HASP-UMN/CubeSat/Documents/CubeSat_Sub-Systems/Communications/Images/Patch_20140520.png

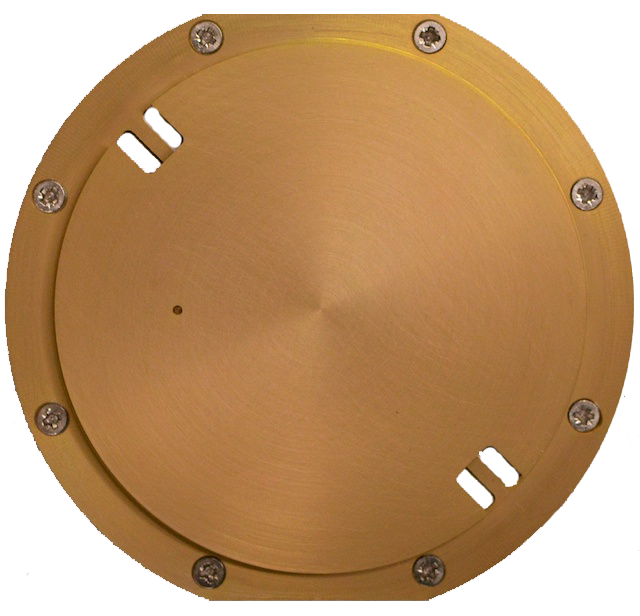
Documents/CubeSat_Sub-Systems/Communications/Images/Patch_20140520.png
