HASP-UMN/CubeSat/Presentations/Images/leadership-500x500.jpg

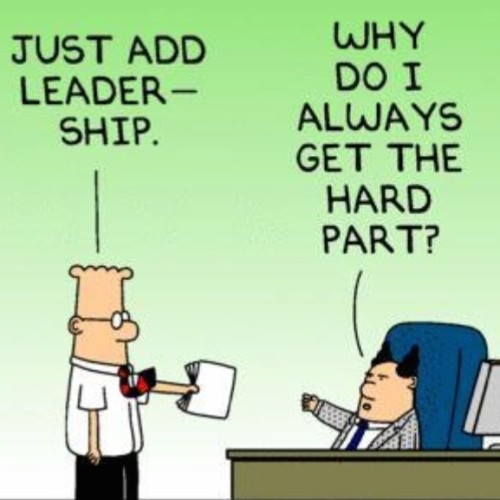
Presentations/Images/leadership-500x500.jpg
