HASP-UMN/CubeSat/README.md

# CubeSat
This is the working repository for the 2015-16 AEM4331 CubeSat design team

The contents are the research files and working documents for the Senior design team
