HASP-UMN/CubeSat/Presentations/CDR_Presentation.pptx

## CubeSat

Critical Design Review

## Agenda

    1. Introduction
    2. Motivation
    3. Approach
    4. Budget
    5. Design
    6. Standards
    7. FMEA
    8. Conclusion

- Charlie

## Introduction

- Charlie

Team Lead/Structure
Charles Denis

ADNCS
Jacob Gustafson
Brian Hanson
Nicholas Sloan

Communications
Ben Setterholm
Tim Kukowski

Power Management
Ethan Arendt
Justin Seifert
Nicholas Janak

## Motivation

- Charlie

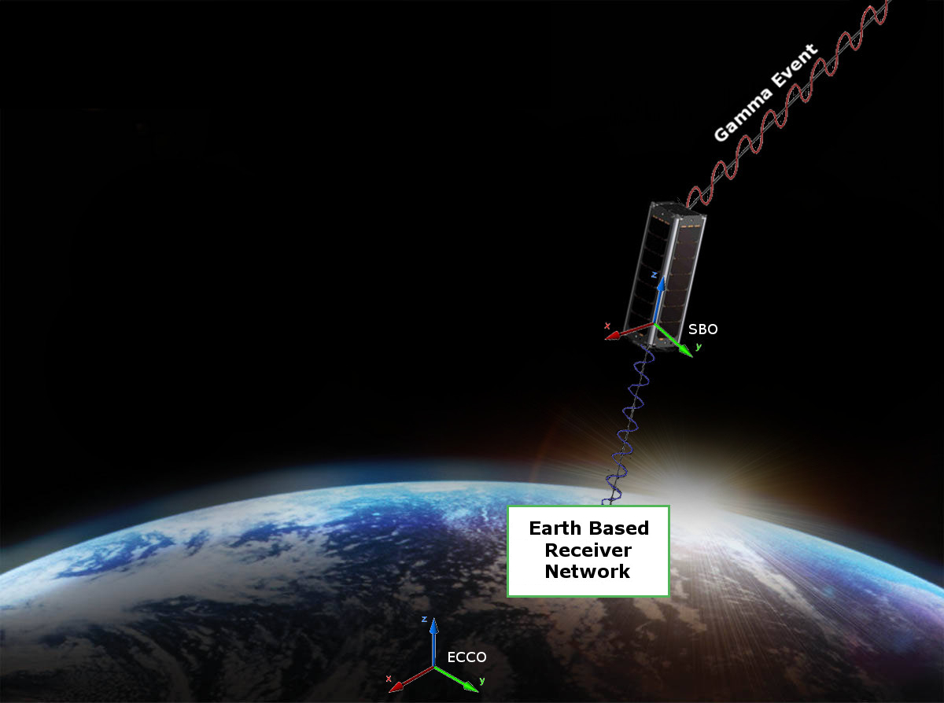
[picture p3: figure]

## Motivation

- Payload
  - Gamma Ray Intensity Detector (GRID)
- What GRID does?
  - Detect Gamma Ray Events to conceptually prove deep space navigation concepts

- Charlie

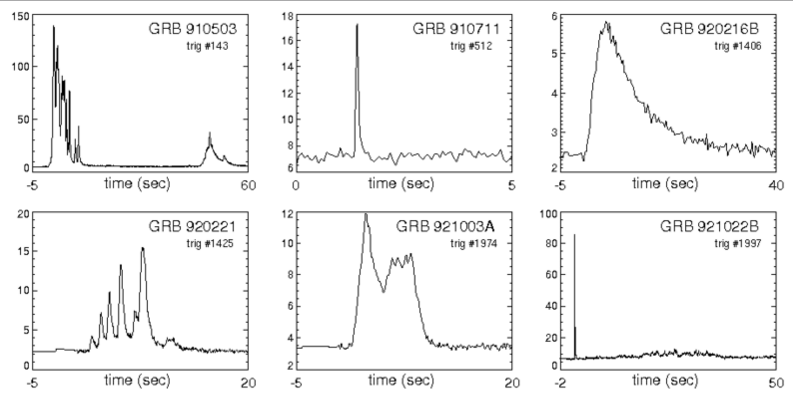
[picture p4: figure]

Figure 1. This figures shows six examples of known Gamma Ray bursts from our universe. The data in the plots represents the relation between Kilo-Electron Volts and Seconds in time.

## Motivation

Requirements
  - The CubeSat shall determine and relay a relative position solution (i.e., relative to the formation) with an accuracy of 10 meters (1 standard deviation)
  - The CubeSat shall determine and relay a relative attitude solution with an accuracy of 10 mRad.
  - The CubeSat shall maintain a clock offset or timing accuracy (relative to the formation) better than 10 µs.

- Tim K

## Motivation

Derived Requirements
  - Shall accept “GRID” as a payload
    - Supplies payload with power (3~5W/hr) and communication requirements
    - Provides environmental data (time, attitude, position) to payload with priority
    - Receives data from payload to transmit to ground network
  - Shall meet NASA CubeSat Launch Initiative requirements
    - Structural, electrical, and other requirements are listed at
      - http://www.nasa.gov/pdf/627972main_LSP-REQ-317_01A.pdf

- Tim K

## Design Approach

- Goals
- Off the Shelf components
  - Why?
  - Focus on design, not technology
  - Support for components
- Subteams
  - Divide and conquer
  - One to three slides

- Tim K

## Budget

- Attitude Control
- Attitude Determination
- Position Determination
- Communication
- Power
- Manpower
  - FREE!
  - Proposal

- Jake G.

## Design - Model

- Solidworks Model HERE

- Charlie D

## Design - Structure

- Century College to Manufacture to Specifications
  - Sub Contracted by UMN

- Charlie

## Design - Structure

- Thermal environment ( heat shielding )

- Charlie

## Design

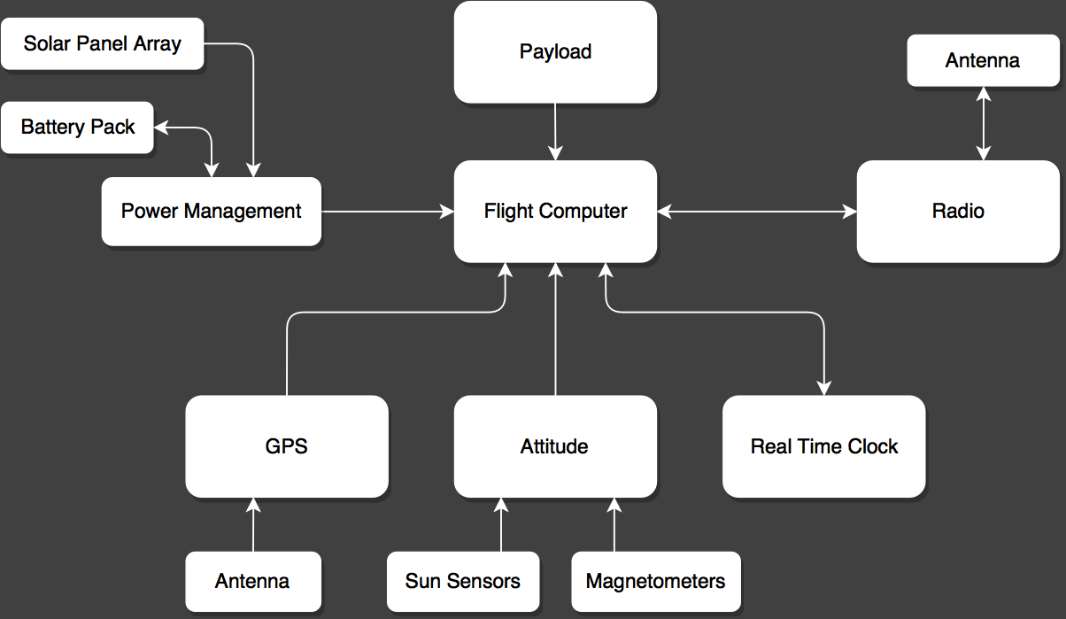
[picture p5: figure]

## Wiring

- TO BE COMPLETED

- Jake G

## Design - ADNCS

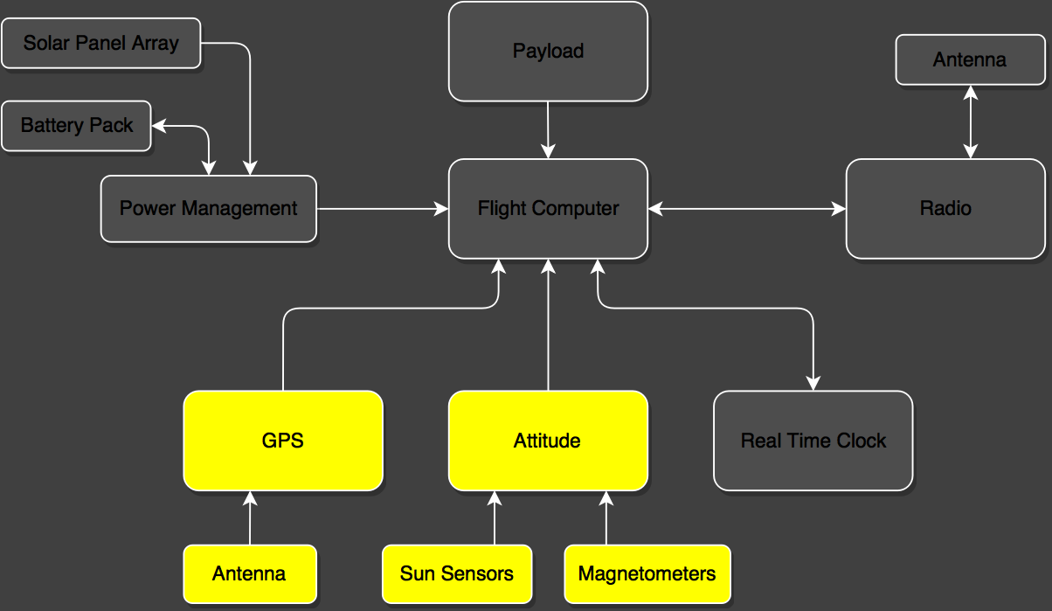
[picture p6: figure]

## DESIGN ADNCS

- Overview

- Nick S

## DESIGN ADNCS

- Passive control mathematatatatatics
why passive?
power savings, etc
FMEA analytics

- Nick S

## DESIGN ADNCS

- GPS

- Jake G

## DESIGN ADNCS

- Attitude determination
- High level description, inputs, etc.

- Brian H

## Design - ADNCS

- Jake G

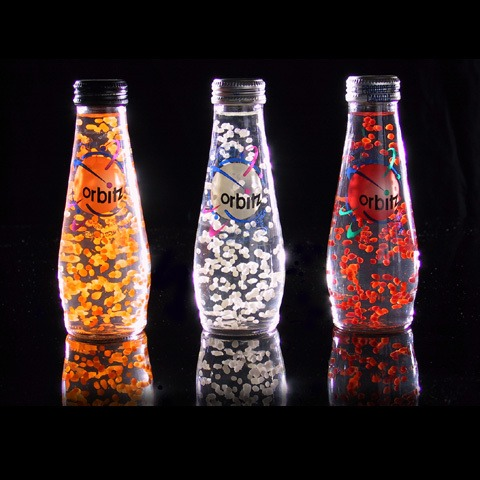
[picture p7: figure]

## Design – Requirements for GRID/GPS

## Design – Requirements for GRID/GPS

- GRID/GPS may generate up to 20 MB per GRB event
- GRID/GPS must save data files in 128 KB packets (maximum).
- Must use logical data naming structure
- Flight computer must generate and save a checksum for each packet file individually

- NAME

## Design - Communications

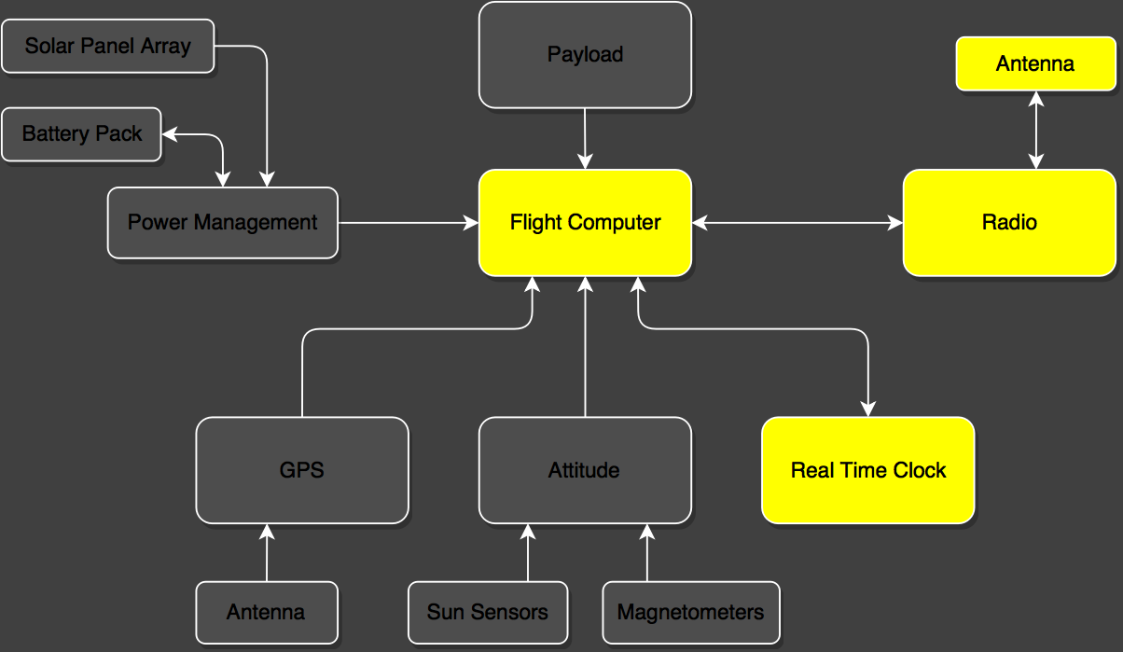
[picture p8: figure]

## Design - Communications Overview

- Maximum total theoretical data that can be transferred per day: 50 MB
- Expected effects reducing this value
  - Weather
  - Communications Algorithm
  - Random Data Errors
- Expected science data transfer per day: 15 MB
- Guaranteed total data transfer per day: 10 MB

- NAME

Notes: Predicted assumes 40% weather throughput, maximum expected data errors, and 1 MB of other data transferred per day (handshakes, diagnostics, log files)

## Design - Communications Hardware

- FreeWave Radio @ 915MHz
- Whip Antenna
- TO BE COMPLETED

- Tim K

## Design – Communications Algorithm

- Ben

Step 1: Active Pinging
- Check if any other ground stations are currently in contact with CubeSat
- If not, send hail signal once every 3 seconds

## Design – Communications Algorithm

- Ben

Step 2: Establish Connection
- CubeSat replies to hail
- CubeSat transmits GPS location, heading, and velocity information
- CubeSat transmits number of files ready for downlink

## Design – Communications Algorithm

- Ben

Step 3: Computation
- Ground station determines communication time

## Design – Communications Algorithm

- Ben

Step 3: Computation
- Ground station determines communication time

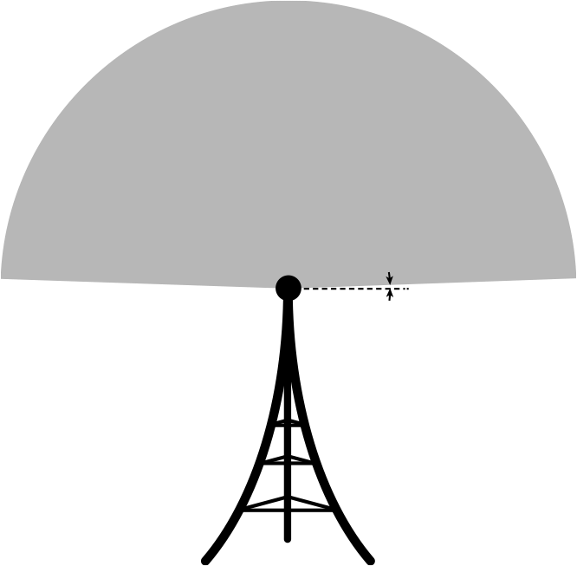
[picture p9: figure]
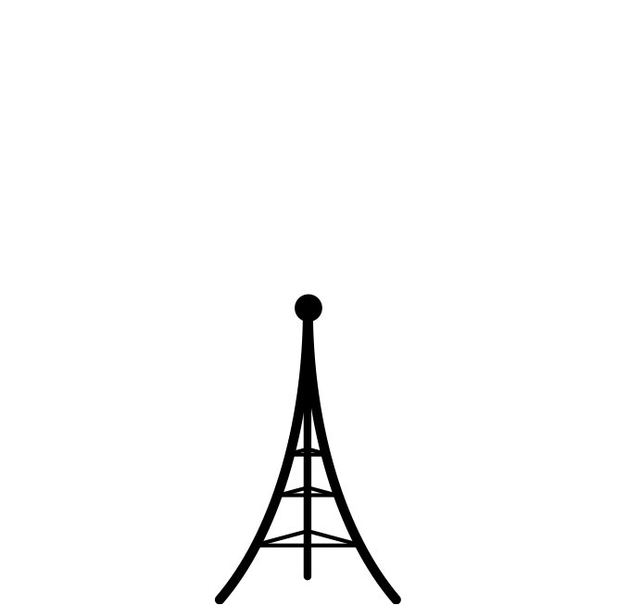
[picture p10: figure]
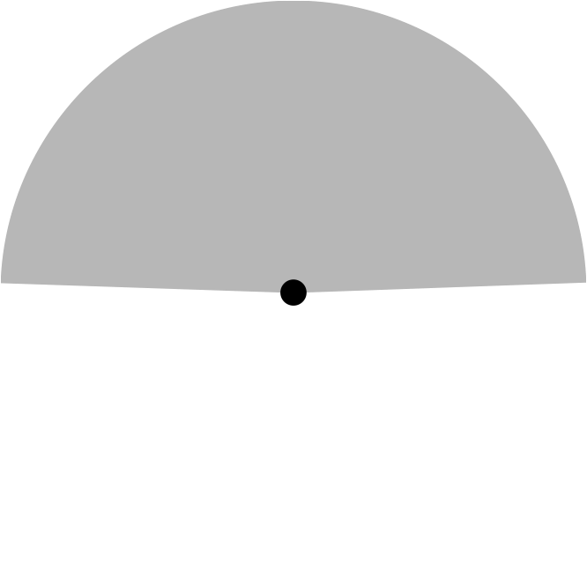
[picture p11: figure]
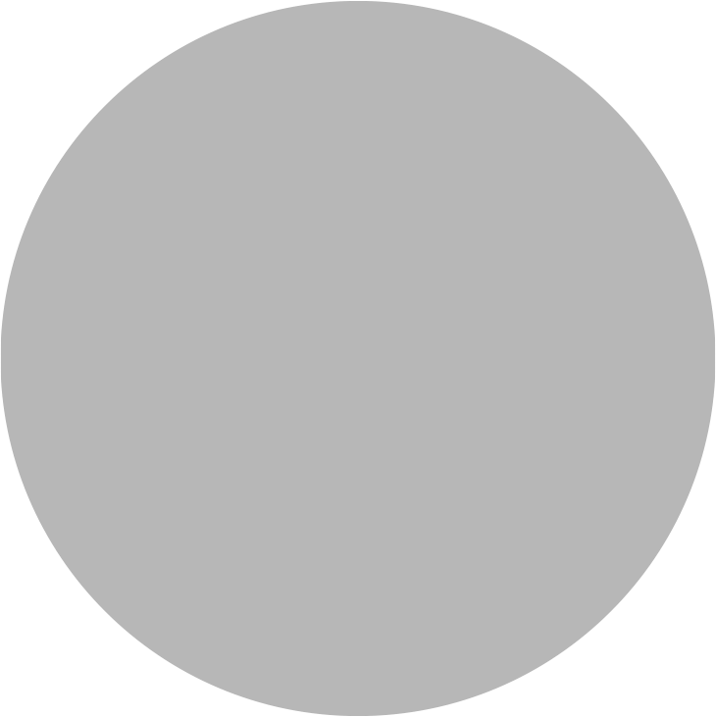
[picture p12: figure]

2°

2000 km

## Design – Communications Algorithm

- Ben

CubeSat makes contact
Determine range

Step 3: Computation
- Ground station determines communication time

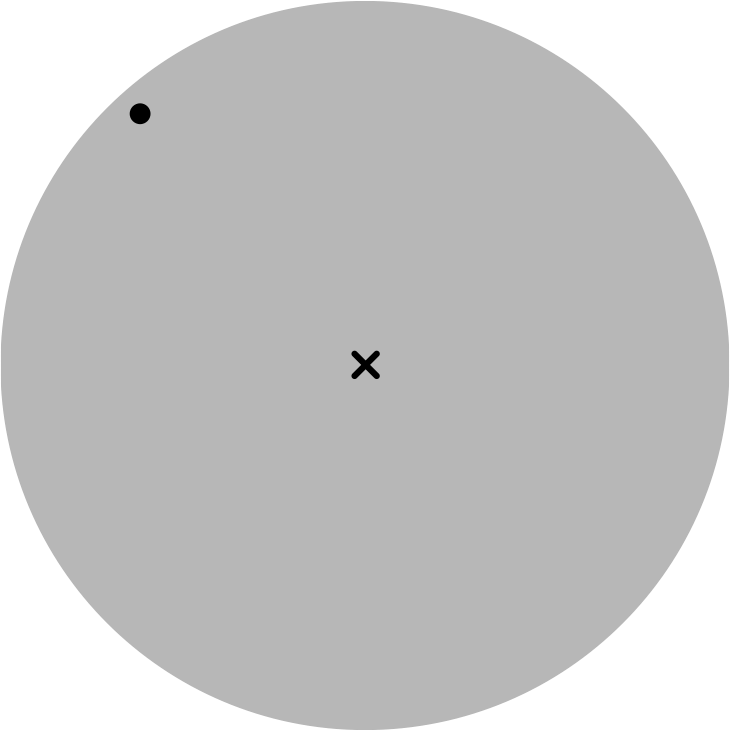
[picture p13: figure]
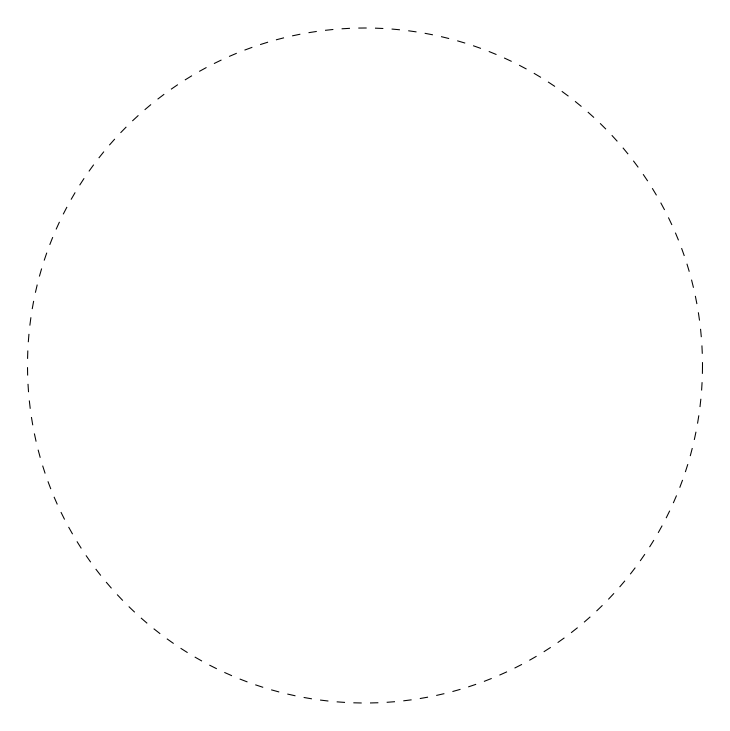
[picture p14: figure]

## Design – Communications Algorithm

- Ben

Step 3: Computation
- Ground station determines communication time

CubeSat makes contact
Determine range
Forward time step
3 second intervals

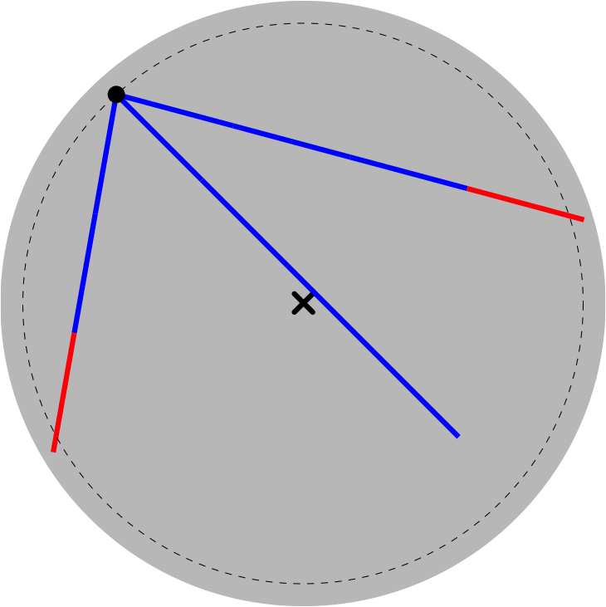
[picture p15: figure]
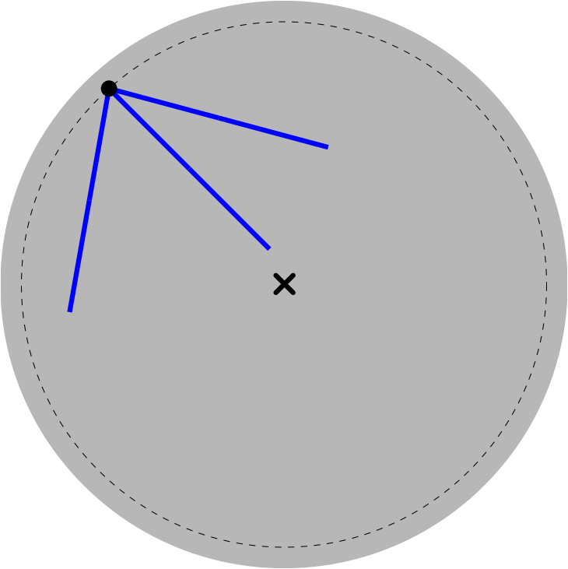
[picture p16: figure]
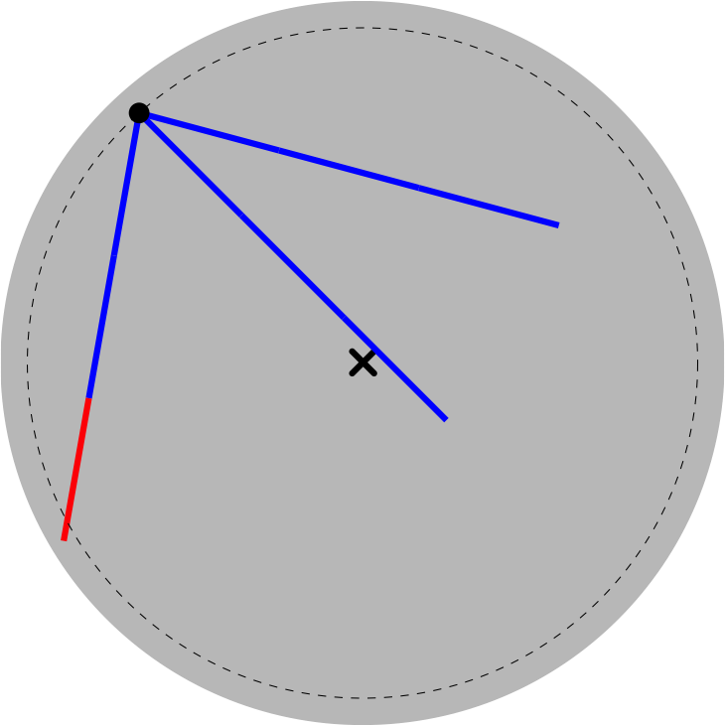
[picture p17: figure]
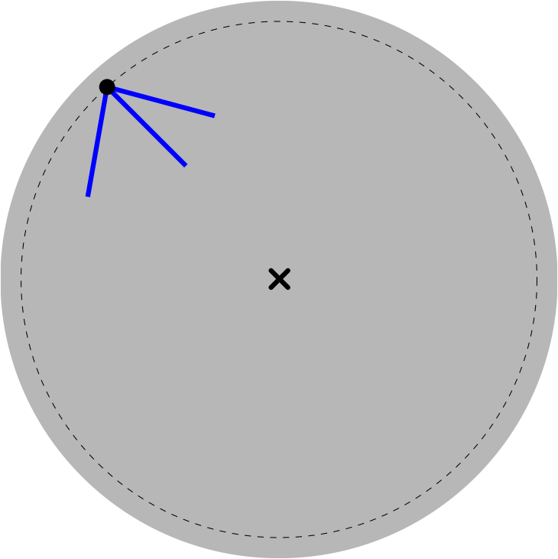
[picture p18: figure]
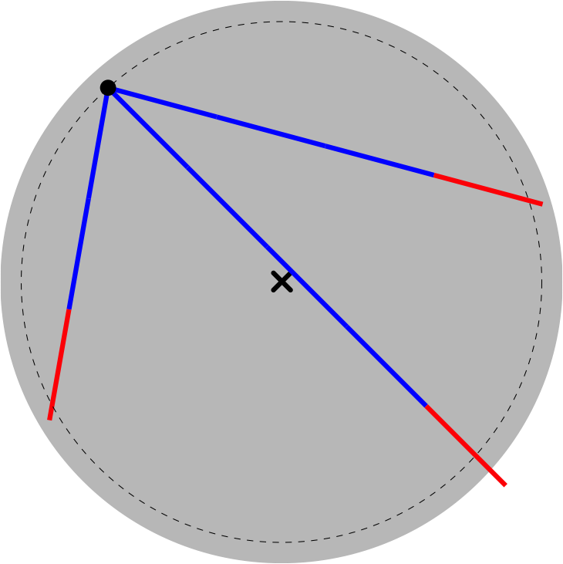
[picture p19: figure]

## Design – Communications Algorithm

- Ben

Step 4: Command
- Ground Station sends command code
  - transfer queued file
  - transfer log file
  - diagnostics
  - delete queued file
- CubeSat purges marked files

delete all data files
delete log file
reboot OS
goodbye

## Design – Communications Algorithm

- Ben

Step 5: Transmit Data
- CubeSat transmits one 128 kB packet
  - 3 time steps

## Design – Communications Algorithm

- Ben

Step 6: Error Checking
- Ground Station computes checksum
- Ground Station transmits checksum

## Design – Communications Algorithm

- Ben

Step 7: Confirmation
- CubeSat checks checksum
- CubeSat relays success/failure to ground station
- CubeSat appends log file
- CubeSat marks file for deletion

## Design – Communications Algorithm

- Ben

Diagnostics
- Onboard Time
- GPS Position, Velocity, Satellite Lock
- Battery Status, Panel Cell Performance
- Attitude Magnetic Lock
- Data Storage Check
- Detector Diagnostics

## Design - Power

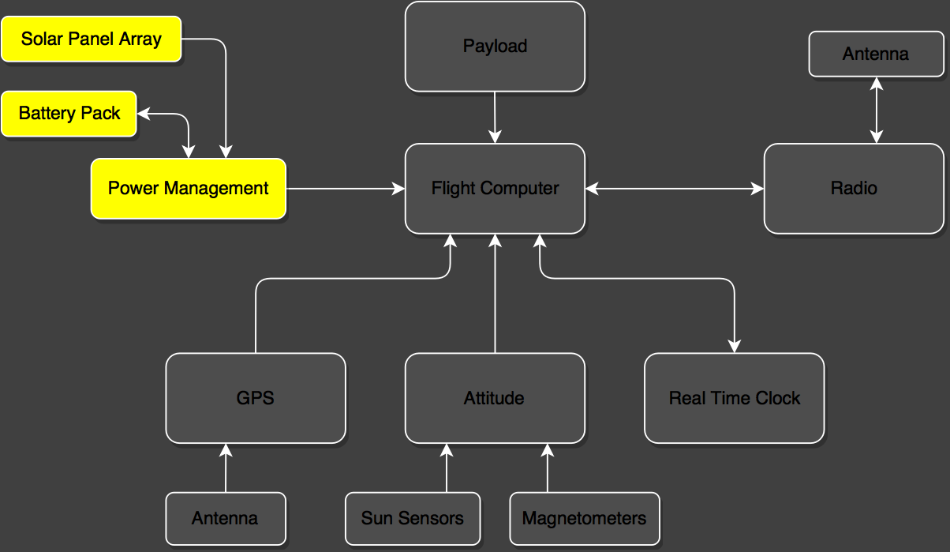
[picture p20: figure]

## Design – Power

- Overview
  - Power needed
  - Power supplied
  - Initial design / needed design
  - deployables

- Justin S

## Design - Power

- Enviromental aspects. (orbits)

- Nick J

## Slide 40

- Power components

- Justin S

## Design – Power Budget

- charge vs discharge

- Ethan A

## Design - Power

- Wiring

- Ethan A

## Design - Power

- Power order of operations

- Nick J

## Design – Power

- Nick J

## FMEA

- TO BE COMPLETED

- Ben S

## Conclusion

- Delivered:
- TO BE COMPLETED

- Nick S

## Next steps.

- Here is the next steps to be done in spring.

- Brian H

## Individual Reports

## Design – Data Link Budget

- TO BE COMPLETED

- Ben
