HASP-UMN/CubeSat/Presentations/Cubesat_outline.docx

1. Intro
  a. Team Arch
2. Motivation
  a. Conops
  b. Requirements
3. Design Approach
  a. Subsystem break down
    i. Requirements
    ii. Research
    iii. Research
    iv. More
  b. Search for reasonable COTS complements
  c. Case studies on other cube sates
  d. Network and repeat
  e. Find expert information
  f. Piece together
4. Specific Design
  a. Block Diagram
  b. Wiring Diagram
  c. CAD model
    i. SHEILDING
      1. Thermal
      2. electrical
  d. Structure requirements for century college
  e. ANDCS ALG
  f. Power Budget
  g. Link Budget
    i. Data schedule
  h. Passive ATT control
  i. Orbit
  j. Packet
    i. Start time GPS
    ii. Start GPS XYZ, velocity
    iii. GRID DATA
    iv. Stop GPS XYZ
    v. STOP TIME
5. Standards
  a. NASA Req
  b. Cal poly Slow
  c. Industrial
6. Budget
  a. Slimming down budget and picking components
7. FMEA
  a. Chart
    i. Modes
    ii. Risk 1-10
    iii. Probability 100 to 0 percent
