HASP-UMN/CubeSat/Documents/CubeSat_Sub-Systems/Communications/StateOfComm.rtf

State of Link Budget
▪ Problems
⁃ Frequency mismatch
⁃ Patch antenna (~2.2 - 2.5 GHz)
⁃ Freewave radio (~900 - 930 MHz).
▪ Info from Freewave (or receiver)
⁃ Receiving antenna
⁃ Effective area (lambda^2 * Gain)/(4*pi)
⁃ G/T
▪ Patch antenna
⁃ Gain?
▪ Atmospheric losses
⁃ If in GHz range
⁃ International Telecommunications Union
⁃ http://www.itu.int/dms_pubrec/itu-r/rec/p/R-REC-P.676-9-201202-S!!PDF-E.pdf
⁃ Ignore rain - transmit at other time

State of communications protocols
▪ Use GPS location to determine if in range to ping ground station
⁃ CubeSat to initiate ping?
▪ Use handshake to determine when to begin transmission
⁃ Ground station determine whether there will be enough time in the communication window to make communication worthwhile.
⁃ Make use of orbit and weather data.
⁃ Send transmission instructions to CubeSat in handshake
⁃ Handshake for each data packet
▪ Error checking
⁃ Look into FEC protocols
⁃ Error rate probably on the order of ~10^-7 or less
⁃ Value decreases with increasing power to CubeSat antenna
⁃ Link Budget will extimate
⁃ Break data up into 128 kB packages
⁃ Flight computer must have checksum ability
⁃ Ground station to uplink checksum
⁃ CubeSat to return Pass/Fail message
⁃ If Pass - delete data from CubeSat storage, proceed to next data packet
⁃ If Fail, repeat current data packet transmission
⁃ At 1W transmission/isotropic antenna, success:failure rate ~ 3:1
⁃ Better rate with more power & gain.
⁃ Transmission time at assumed 100 kbps data rate ~11 sec
⁃ Entire handshake, transmission, & error checking per packet ~15 sec
