HASP-UMN/CubeSat/Documents/CubeSat_Sub-Systems/Power/Research/Useful webpages.docx

http://www.diyspaceexploration.com/power-system-budget-analysis/
