HASP-UMN/CubeSat/Other/Returned tech memo/P1.pdf

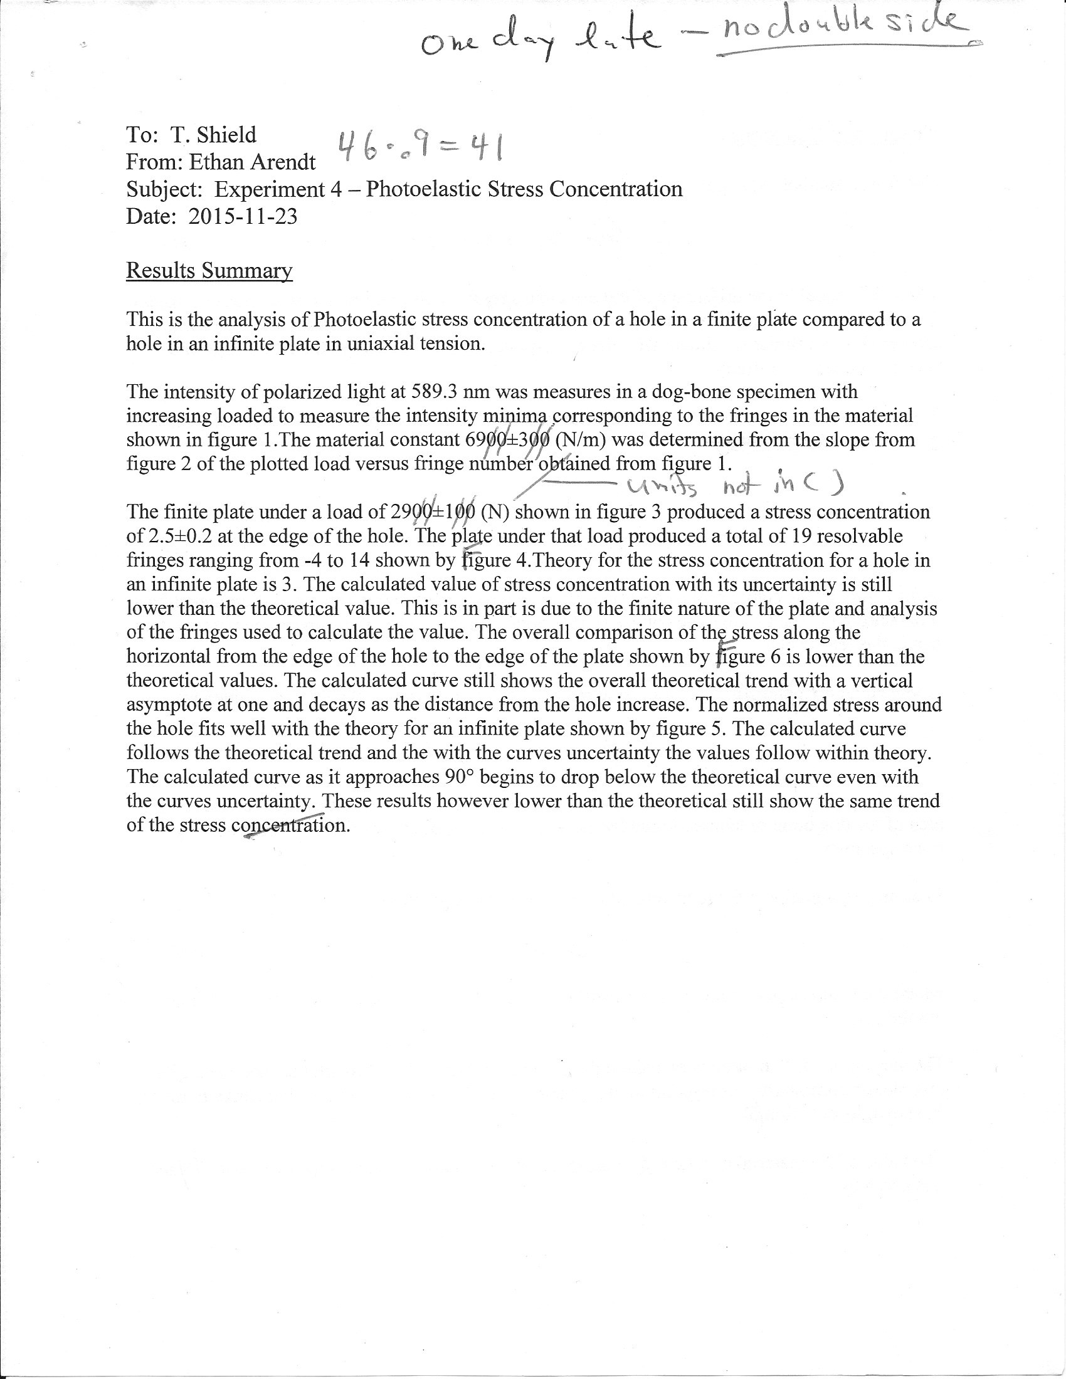
[picture p127: page 1]
