HASP-UMN/CubeSat/Other/Returned tech memo/P10.pdf

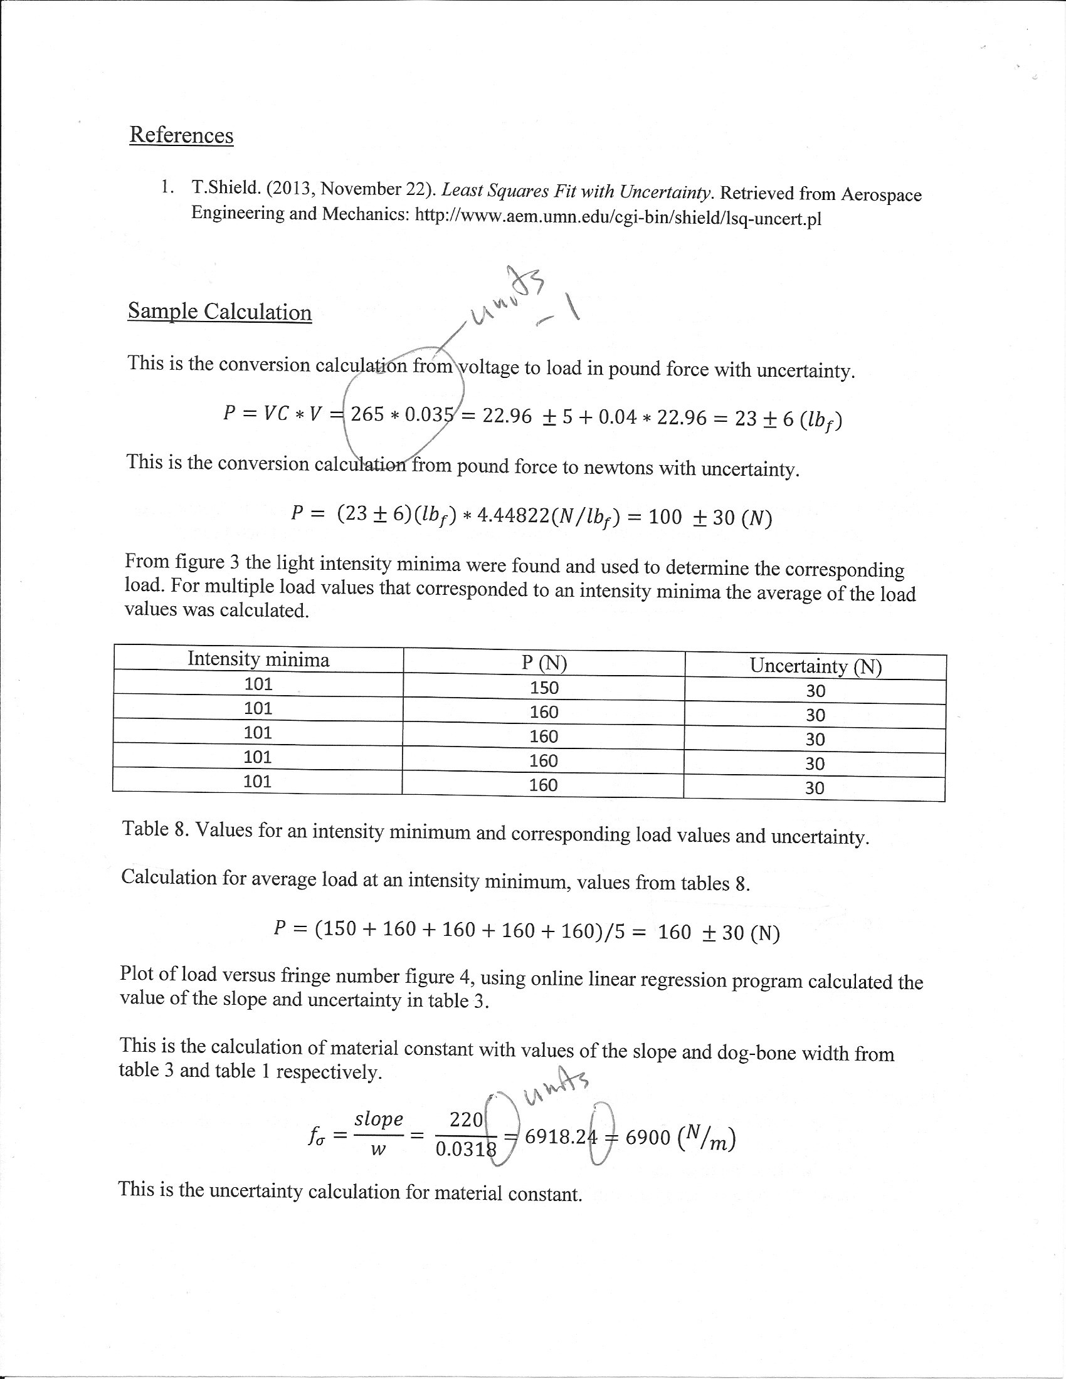
[picture p128: page 1]
