HASP-UMN/CubeSat/Other/Returned tech memo/P11.pdf

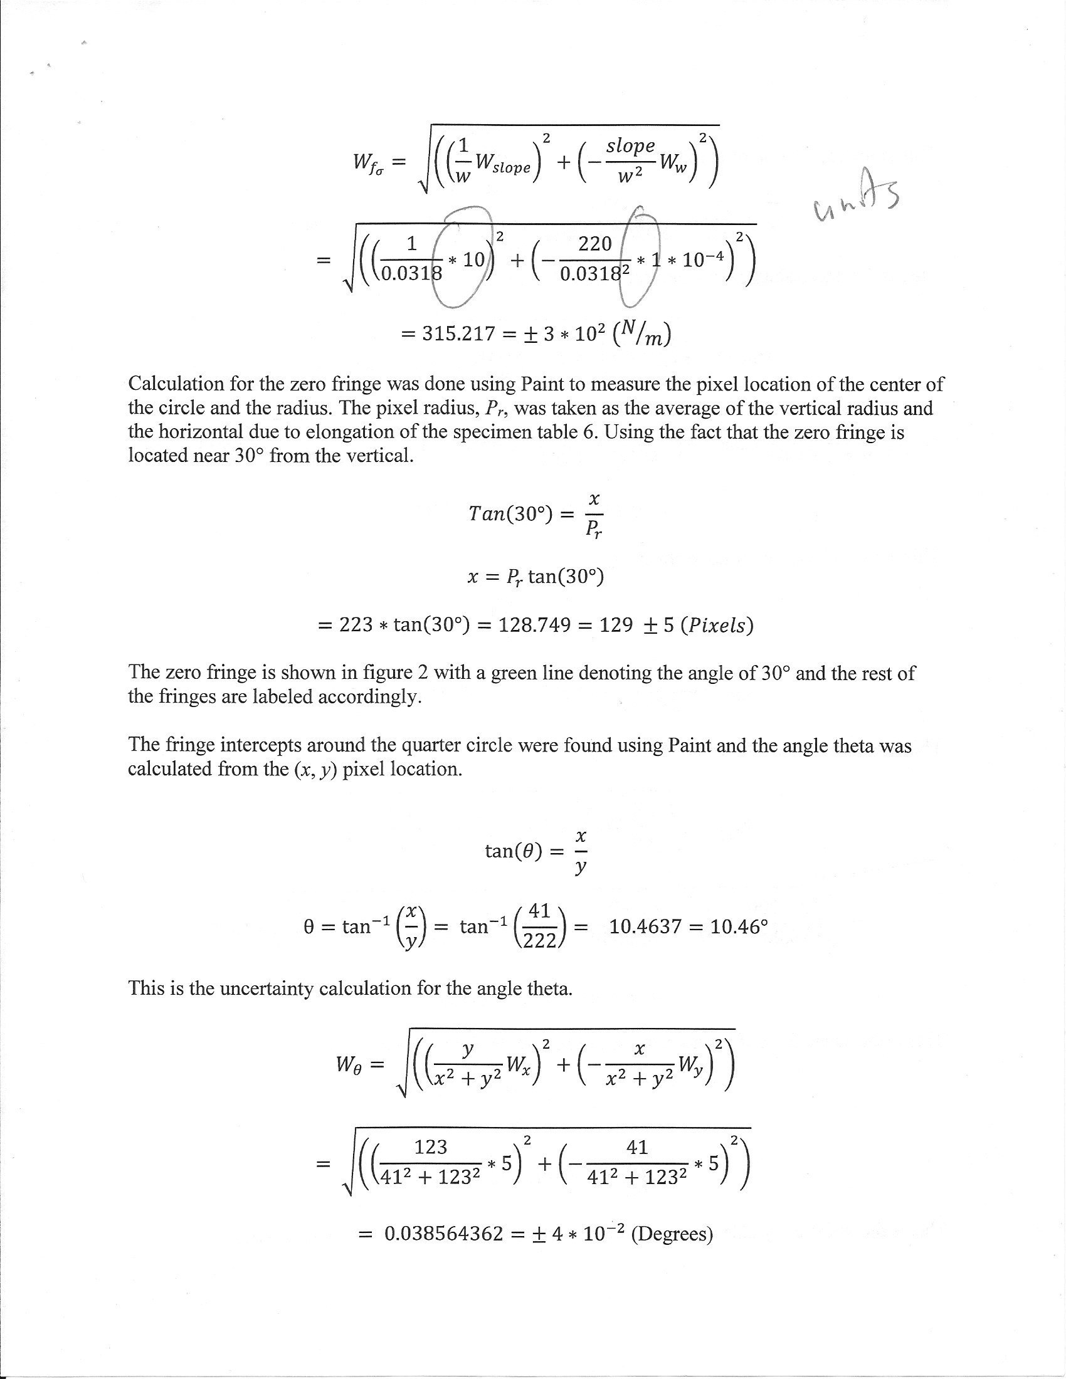
[picture p129: page 1]
