HASP-UMN/CubeSat/Other/Returned tech memo/P12.pdf

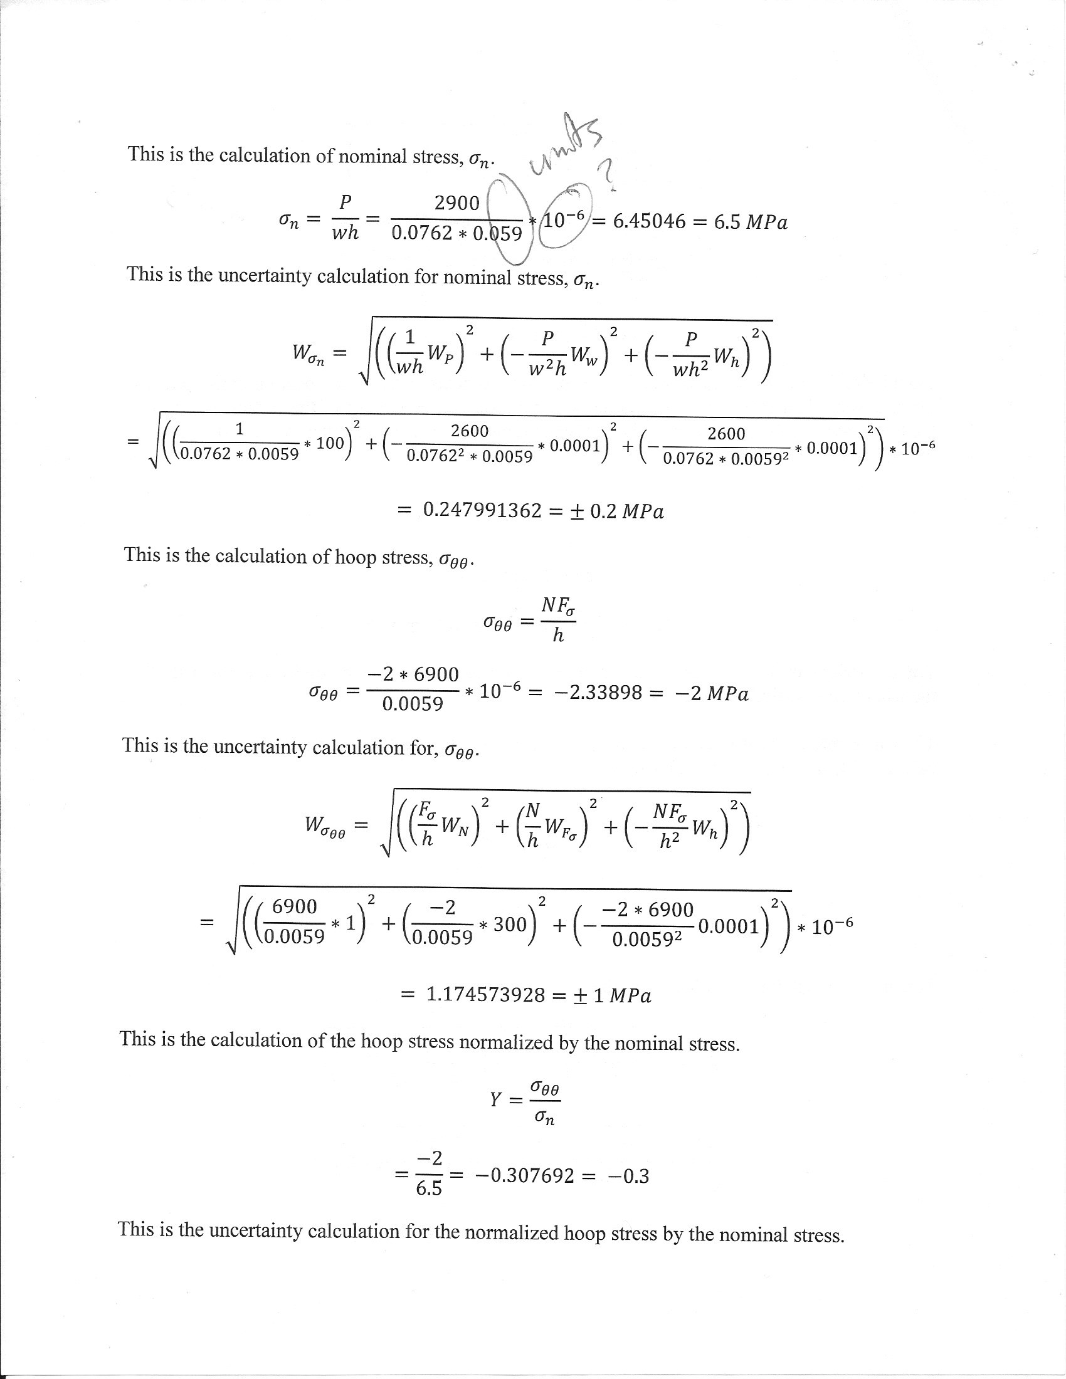
[picture p130: page 1]
