HASP-UMN/CubeSat/Other/Returned tech memo/P13.pdf

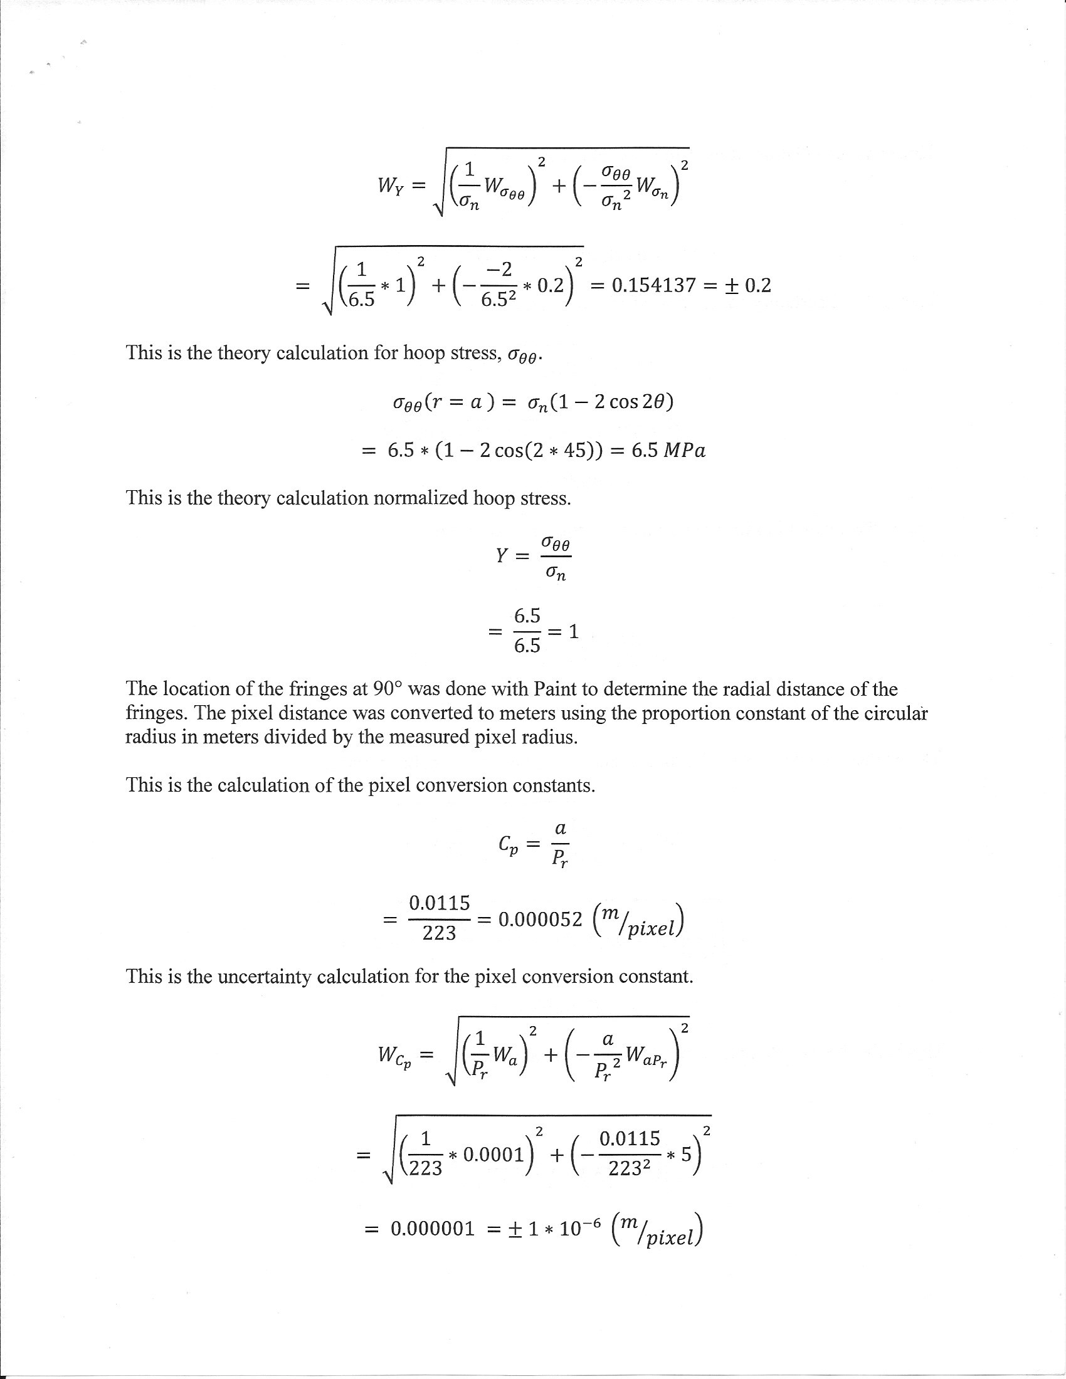
[picture p131: page 1]
