HASP-UMN/CubeSat/Other/Returned tech memo/P14.pdf

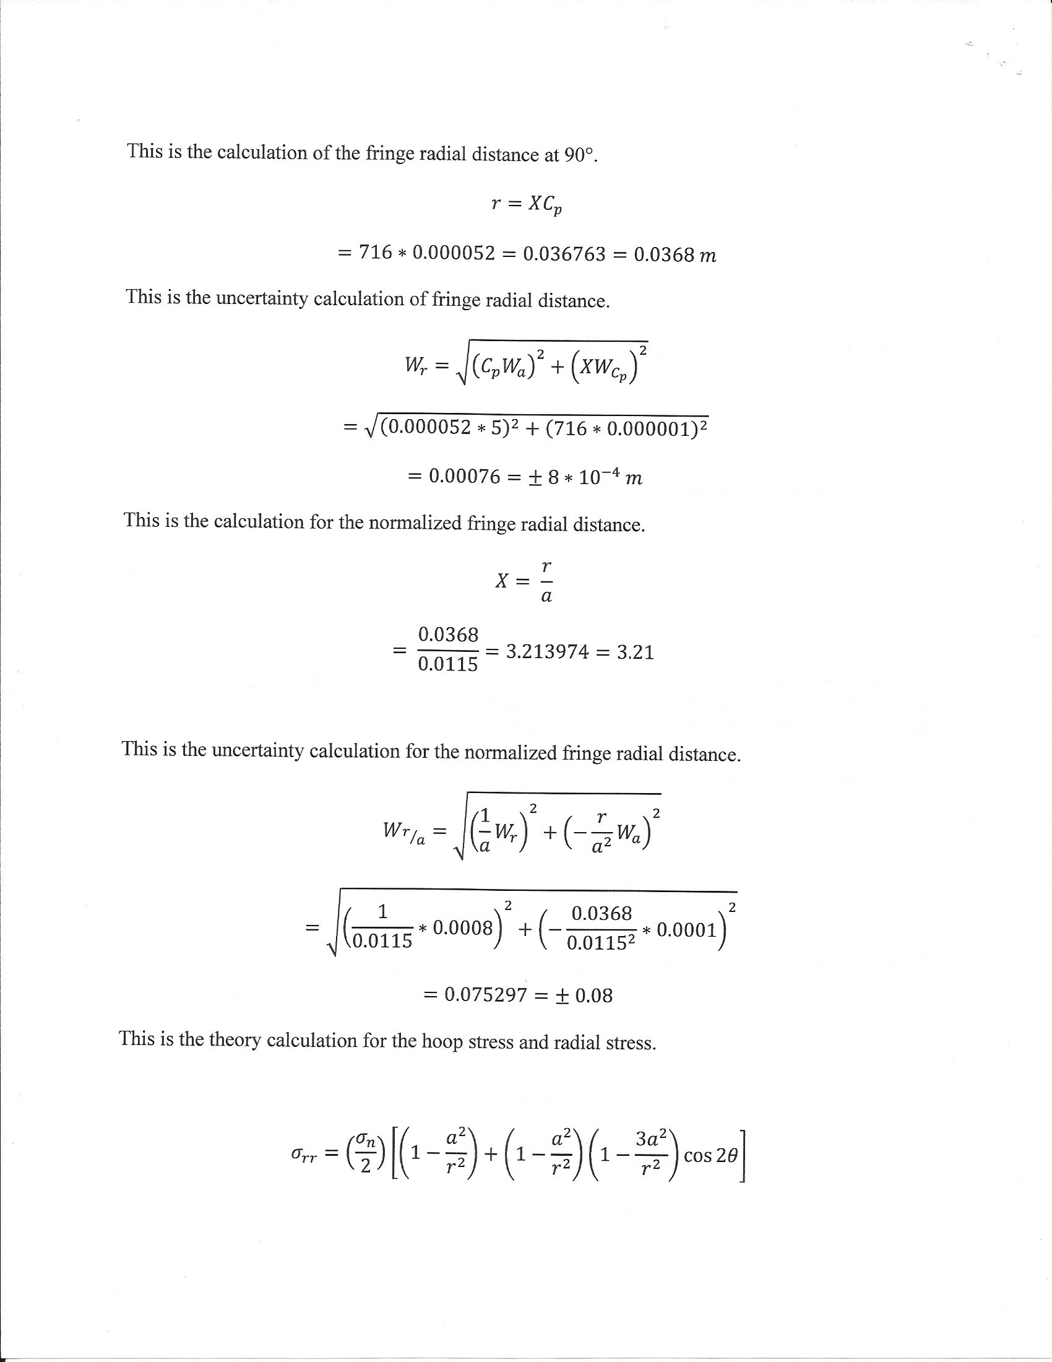
[picture p132: page 1]
