HASP-UMN/CubeSat/Other/Returned tech memo/P15.pdf

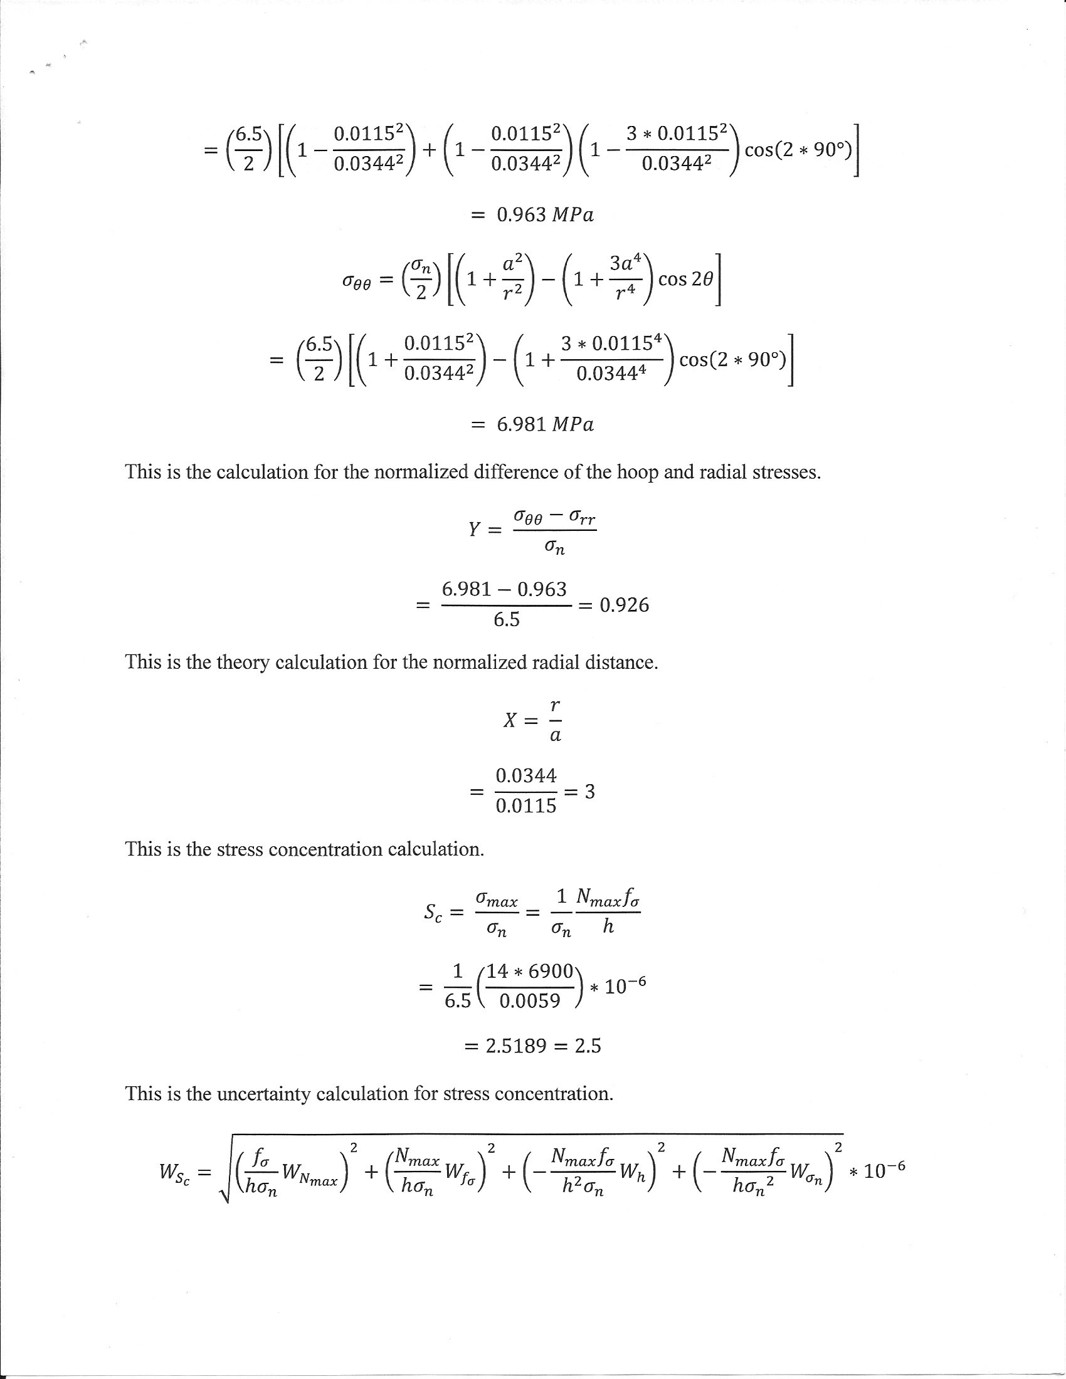
[picture p133: page 1]
