HASP-UMN/CubeSat/Other/Returned tech memo/P16.pdf

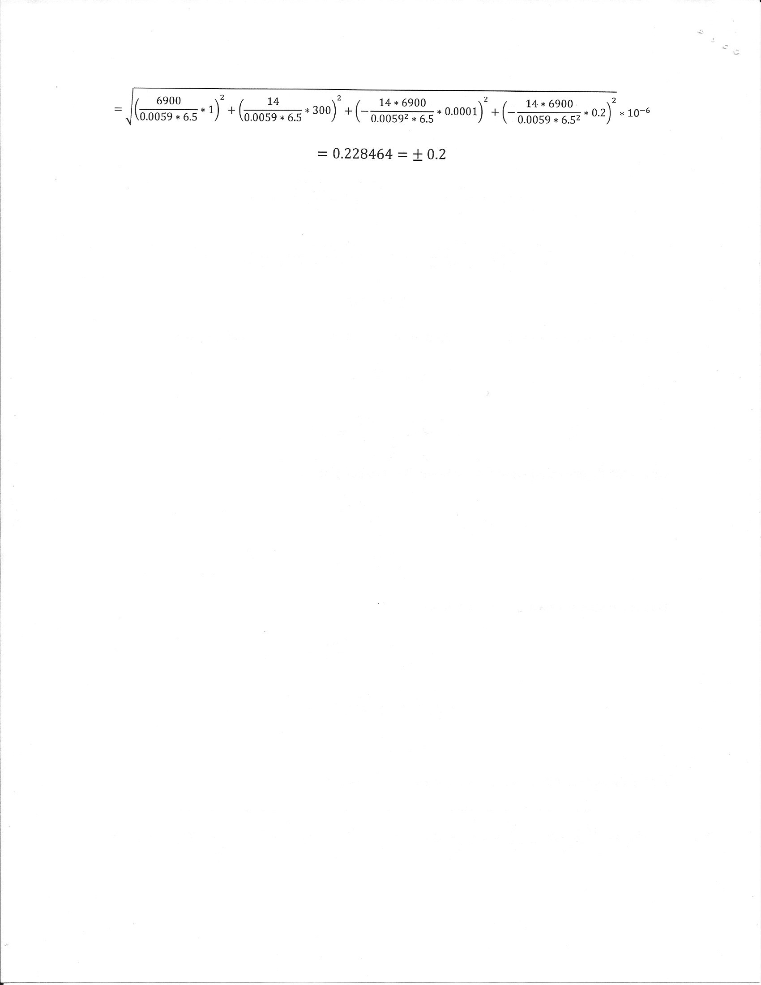
[picture p134: page 1]
