HASP-UMN/CubeSat/Other/Returned tech memo/P2.pdf

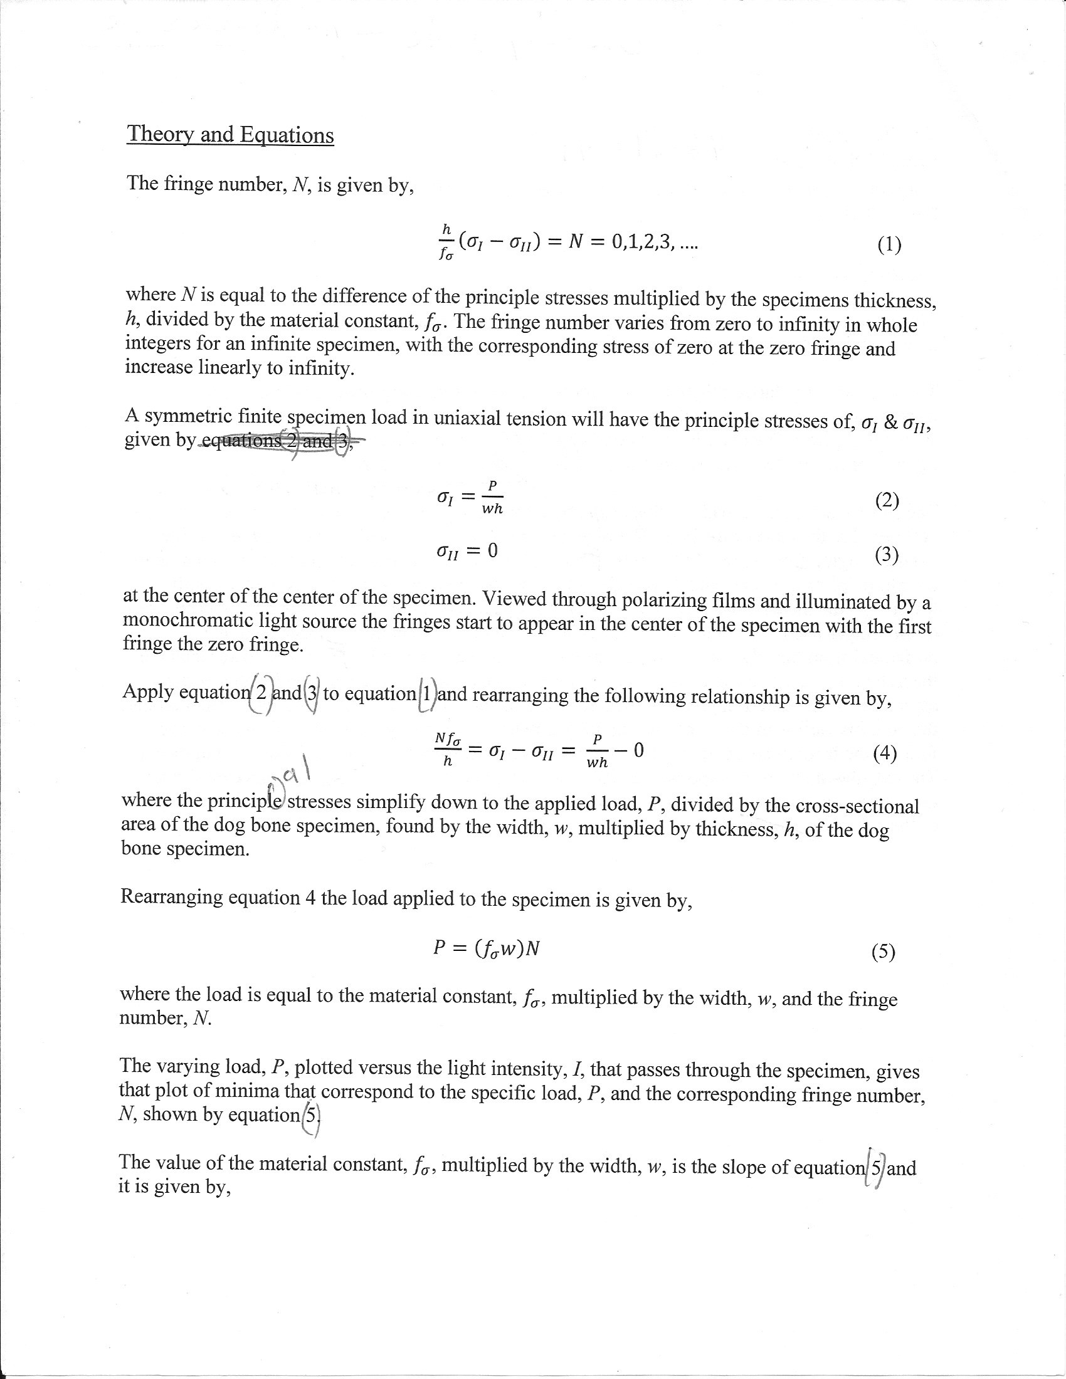
[picture p135: page 1]
