HASP-UMN/CubeSat/Other/Returned tech memo/P3.pdf

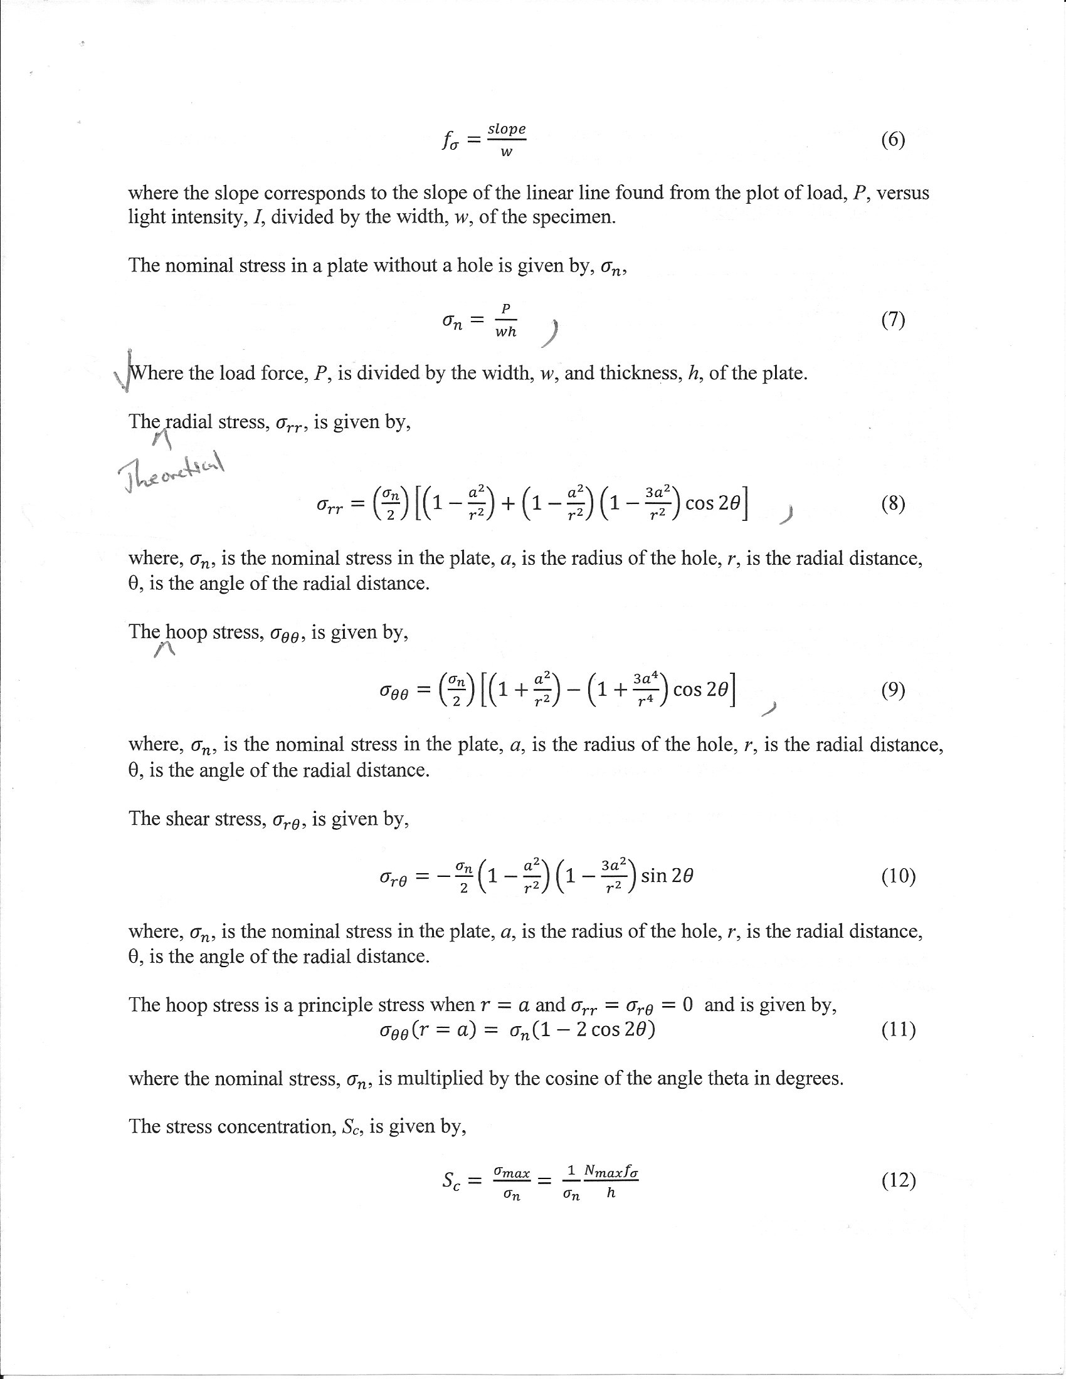
[picture p136: page 1]
