HASP-UMN/CubeSat/Other/Returned tech memo/P4.pdf

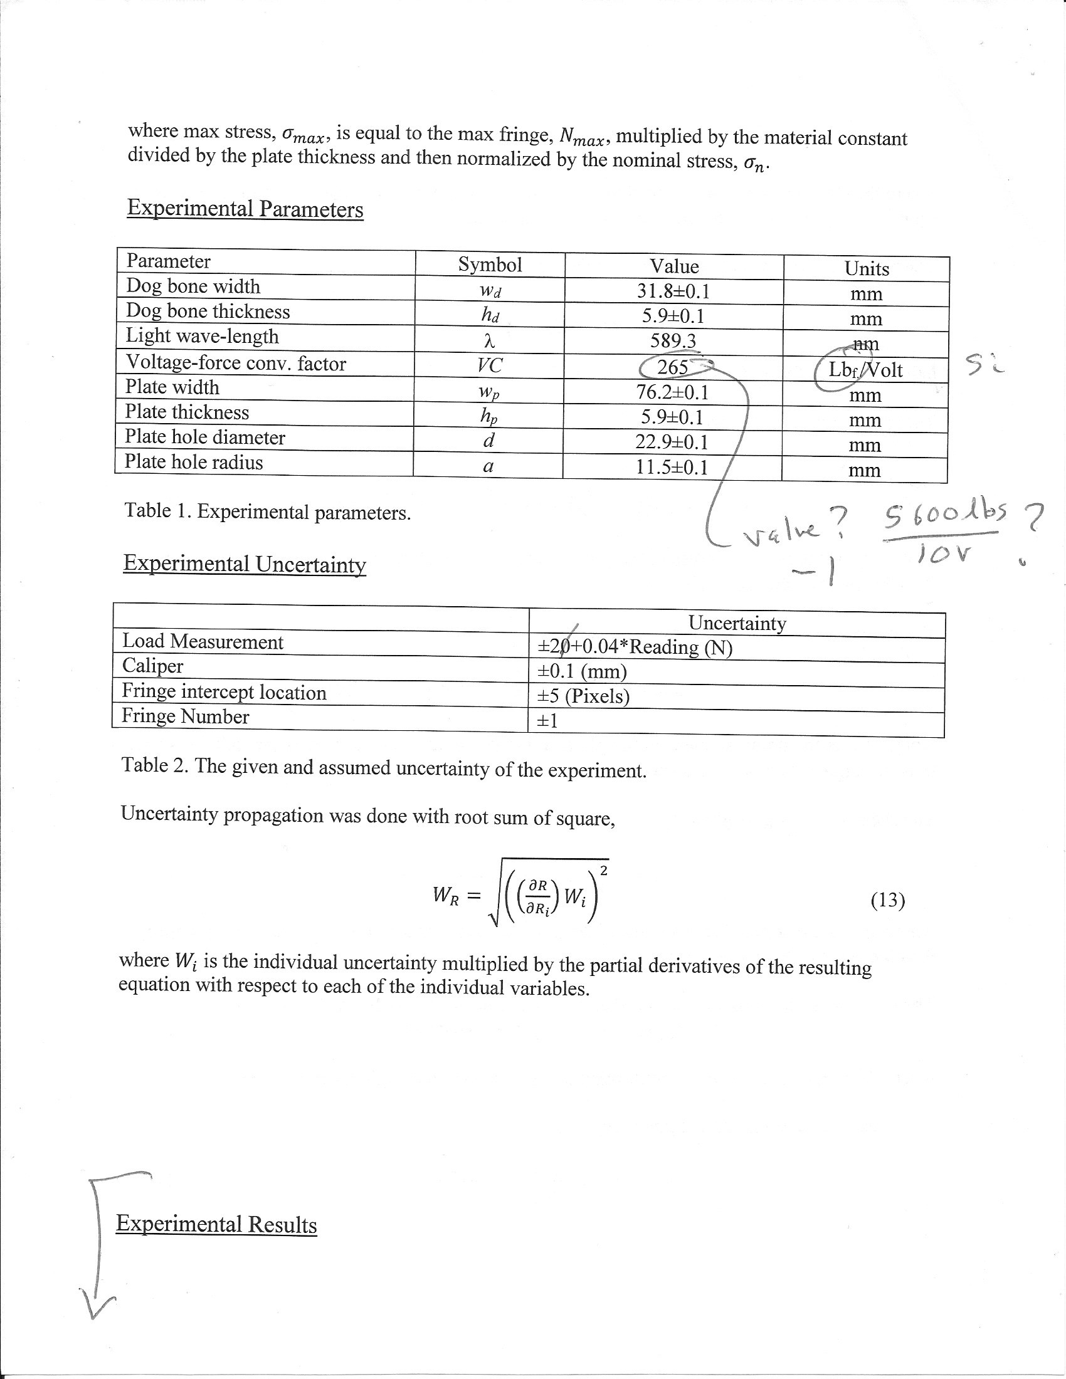
[picture p137: page 1]
