HASP-UMN/CubeSat/Other/Returned tech memo/P5.pdf

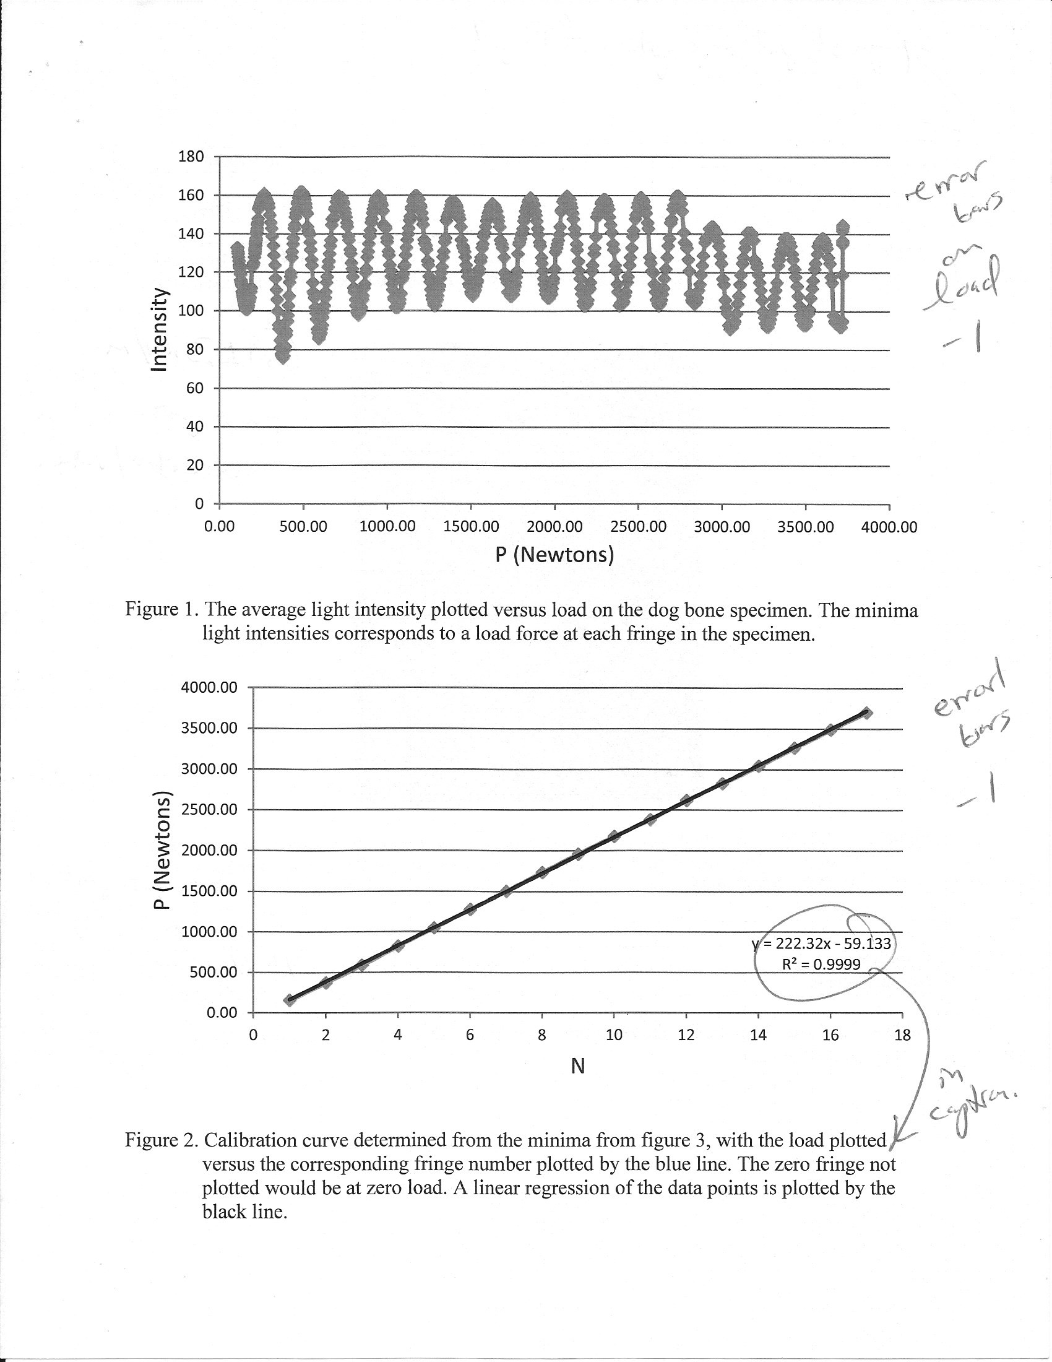
[picture p138: page 1]
