HASP-UMN/CubeSat/Other/Returned tech memo/P6.pdf

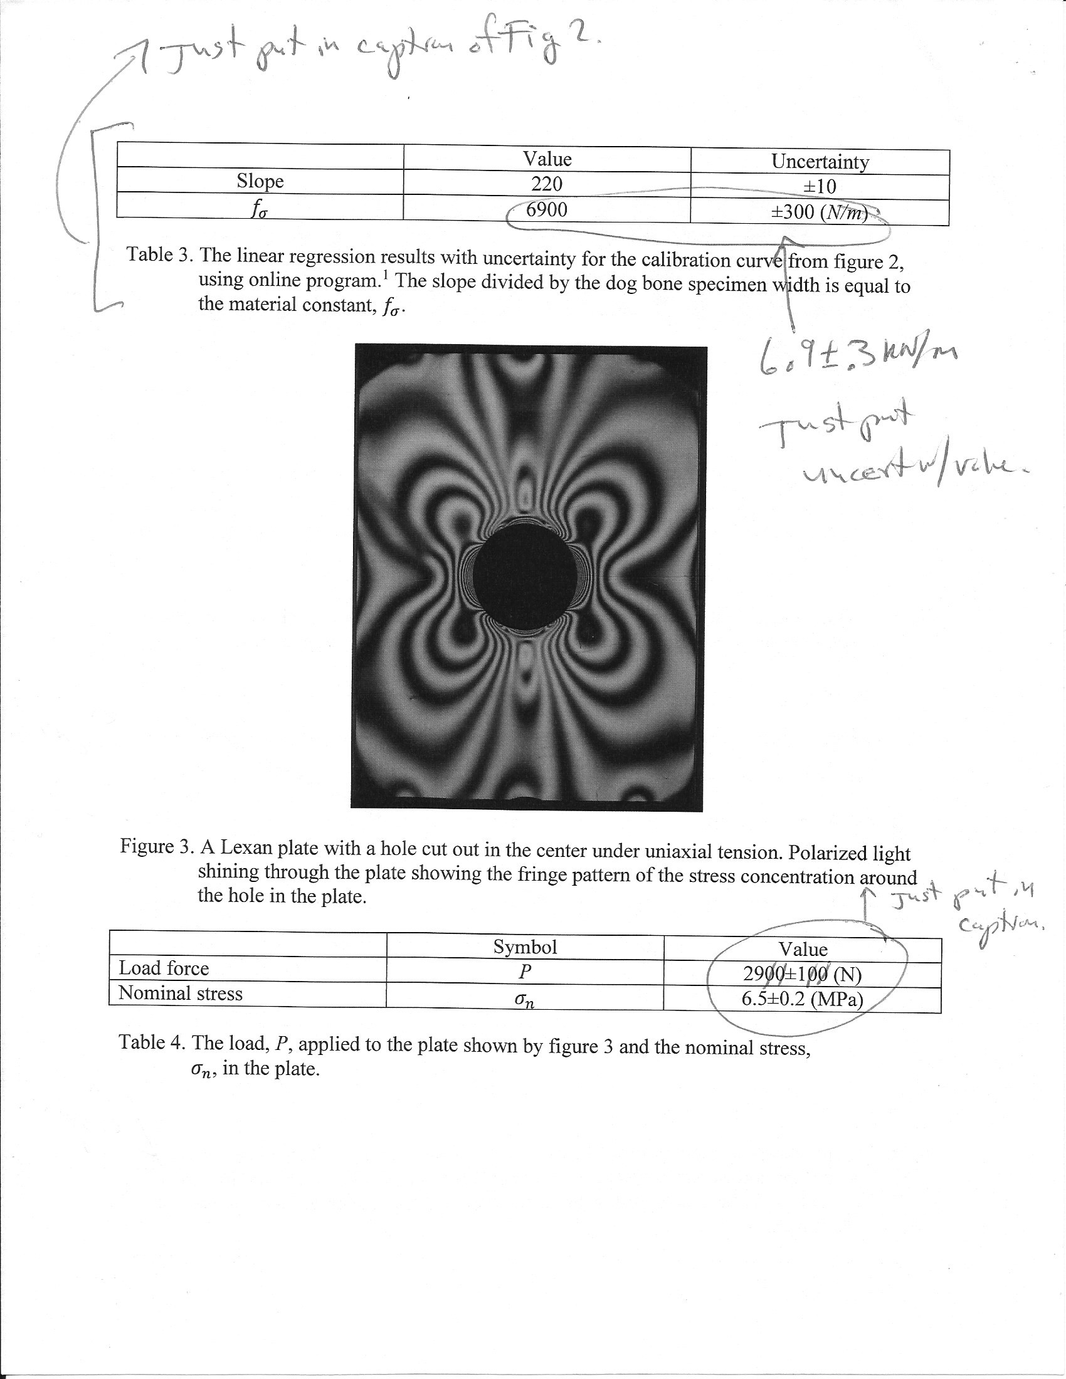
[picture p139: page 1]
