HASP-UMN/CubeSat/Other/Returned tech memo/P7.pdf

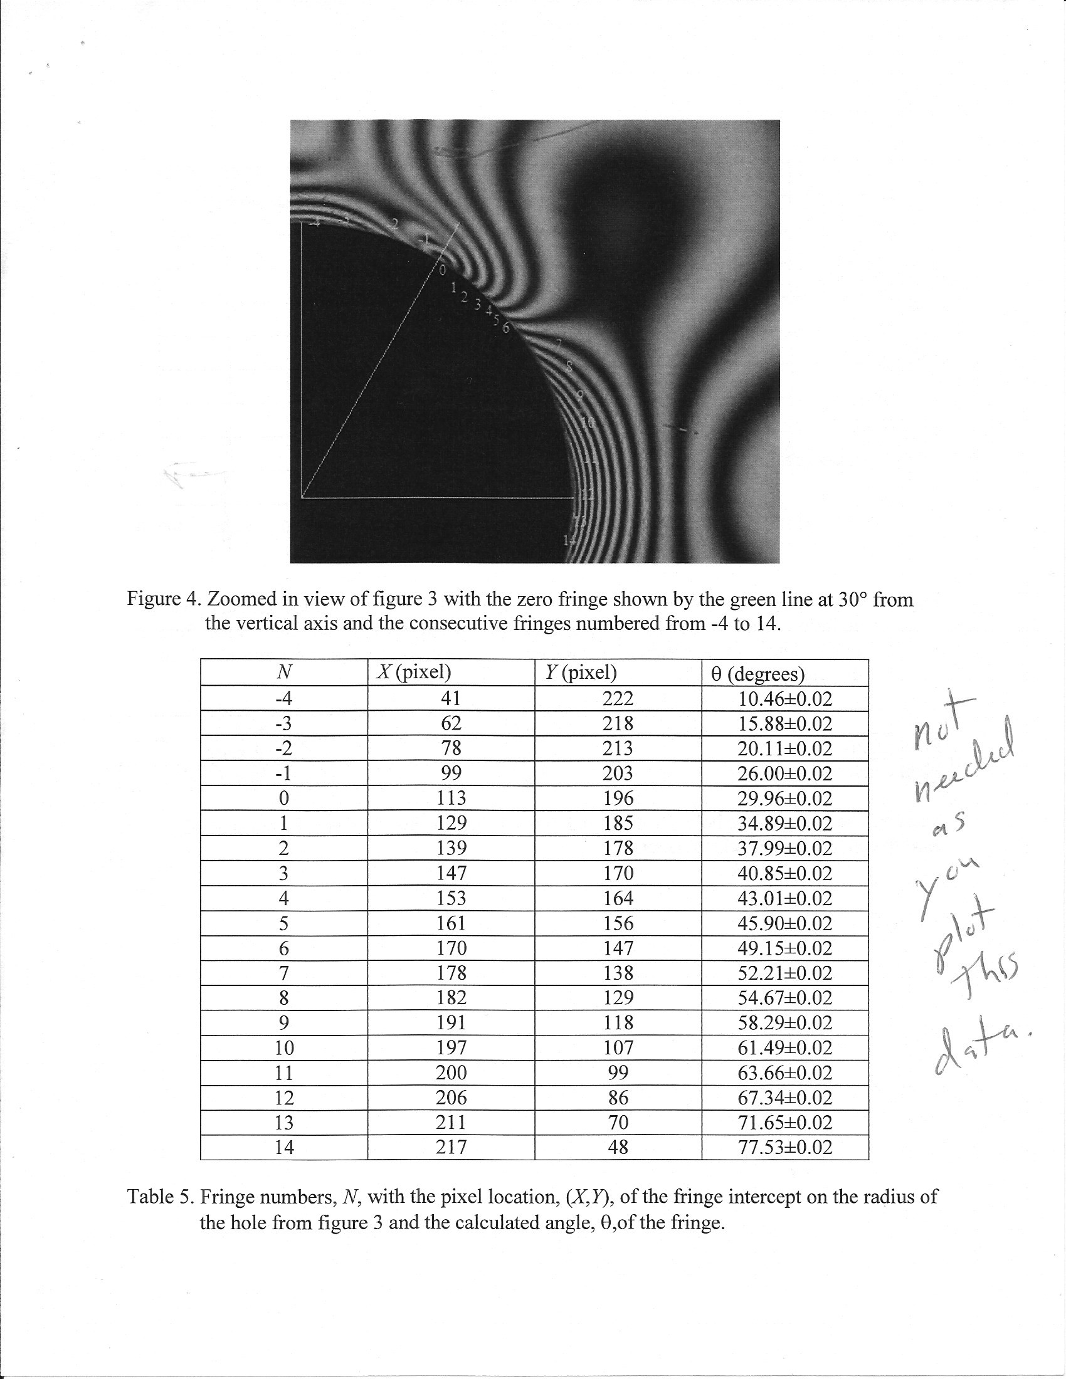
[picture p140: page 1]
