HASP-UMN/CubeSat/Other/Returned tech memo/P8.pdf

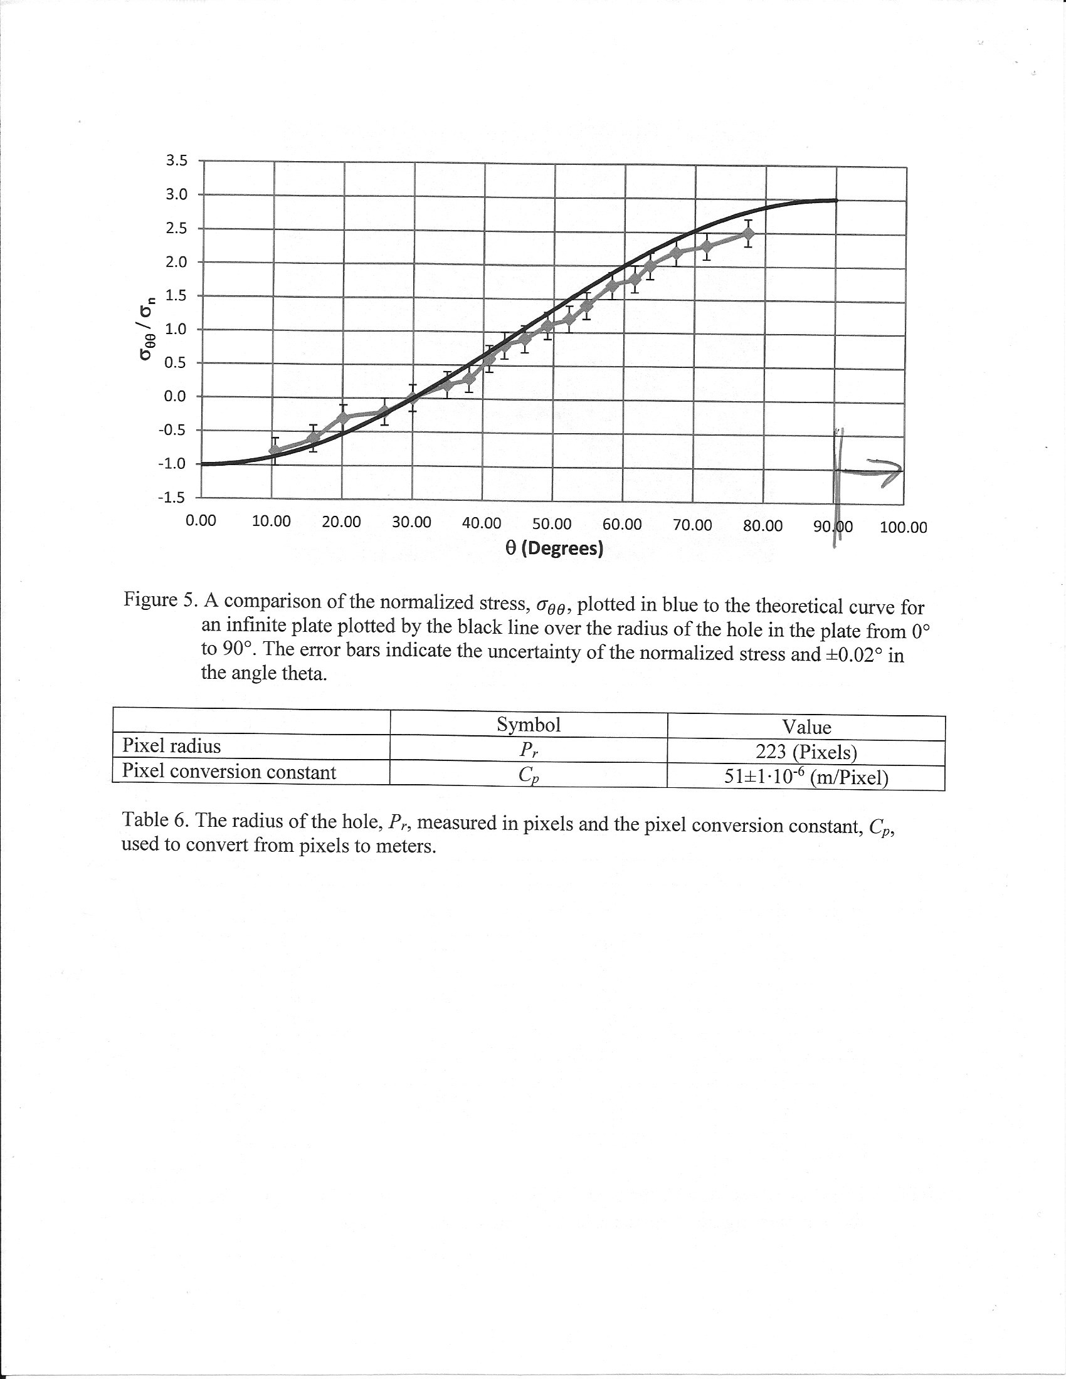
[picture p141: page 1]
