HASP-UMN/CubeSat/Other/Returned tech memo/P9.pdf

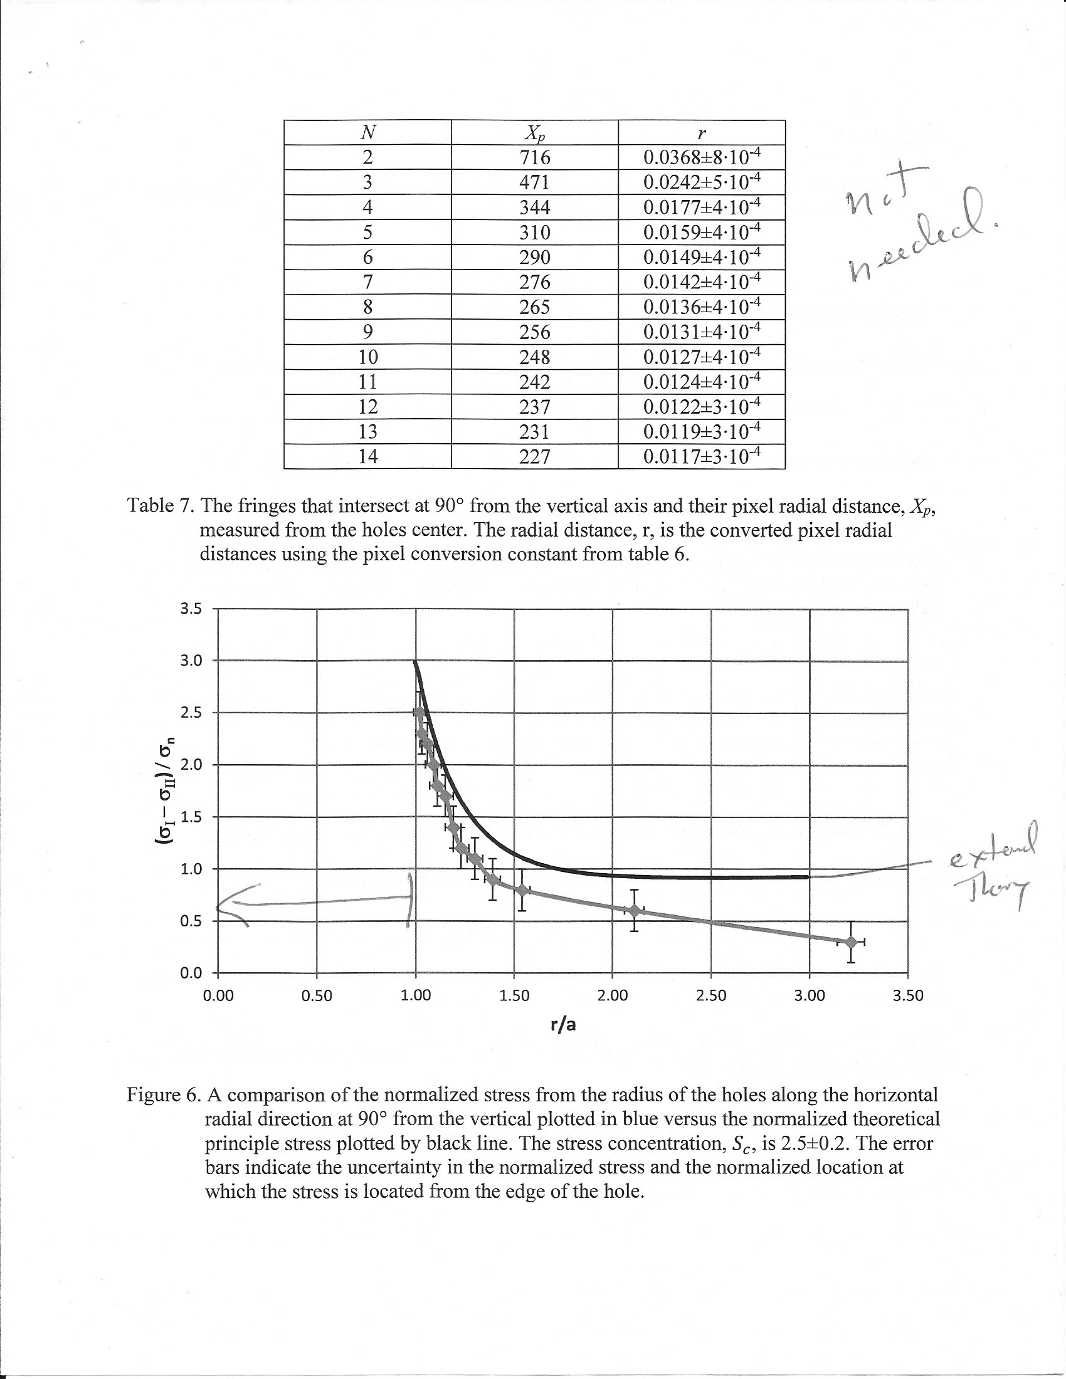
[picture p142: page 1]
