HASP-UMN/CubeSat/CubeSat_draft.JPG

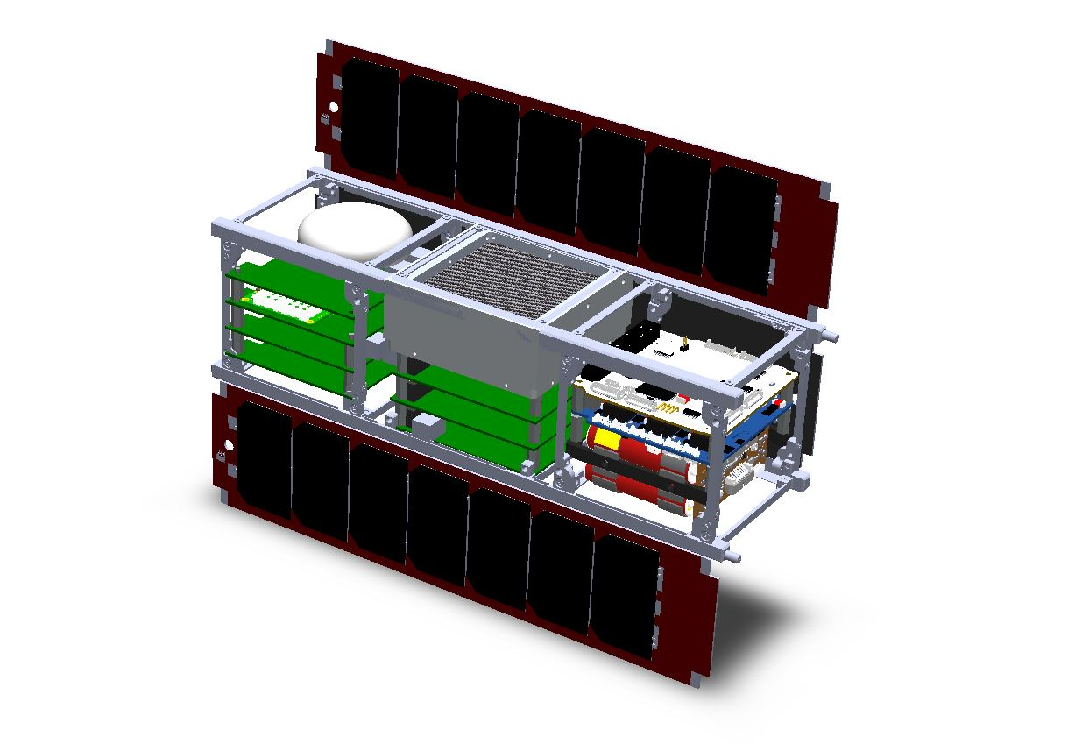
CubeSat_draft.JPG
