HASP-UMN/CubeSat/Documents/CubeSat_Sub-Systems/Communications/Images/MM2-900MHz-Radio.jpg

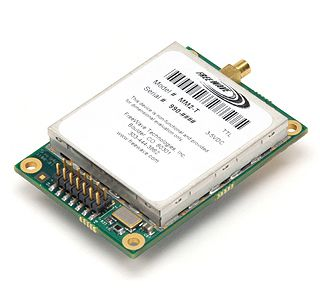
Documents/CubeSat_Sub-Systems/Communications/Images/MM2-900MHz-Radio.jpg
