HASP-UMN/CubeSat/Documents/CubeSat_Sub-Systems/Communications/Images/p01l49tk.jpg

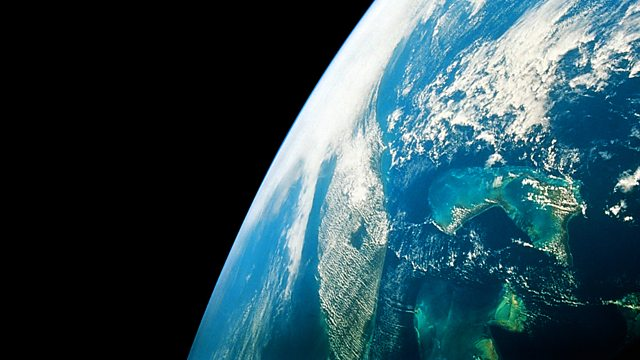
Documents/CubeSat_Sub-Systems/Communications/Images/p01l49tk.jpg
