HASP-UMN/CubeSat/Documents/CubeSat_Sub-Systems/Communications/Images/radio-waves-hi.png

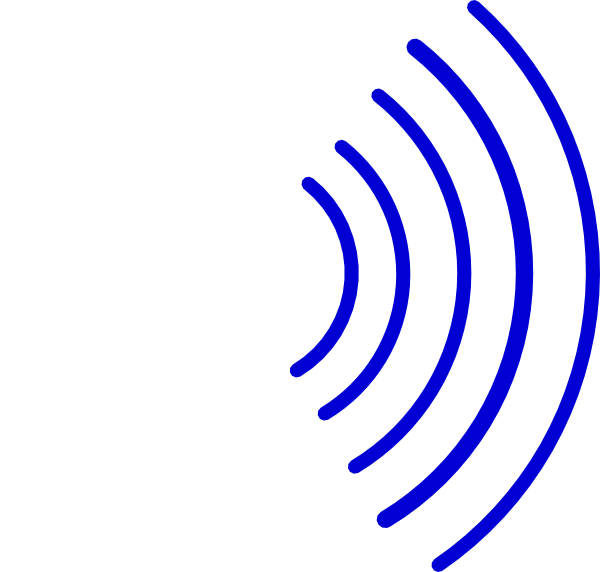
Documents/CubeSat_Sub-Systems/Communications/Images/radio-waves-hi.png
