HASP-UMN/CubeSat/Documents/CubeSat_Sub-Systems/Communications/Images/radio-waves-tower.png

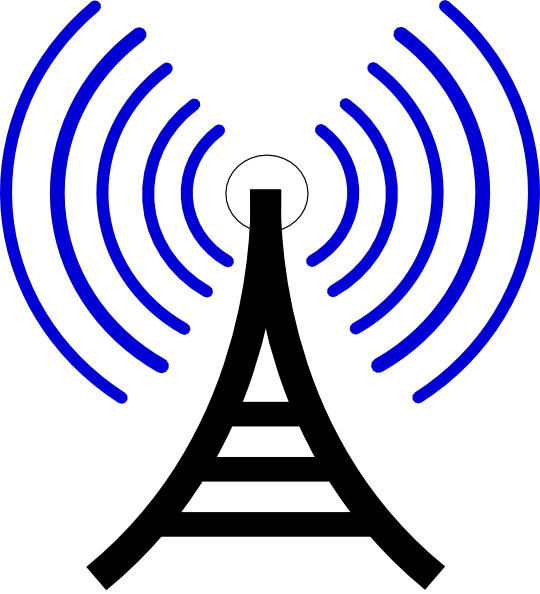
Documents/CubeSat_Sub-Systems/Communications/Images/radio-waves-tower.png
