HASP-UMN/CubeSat/Documents/CubeSat_Sub-Systems/Power/Data/Clyde Space 3U solar panel connection harness 73-large.jpg

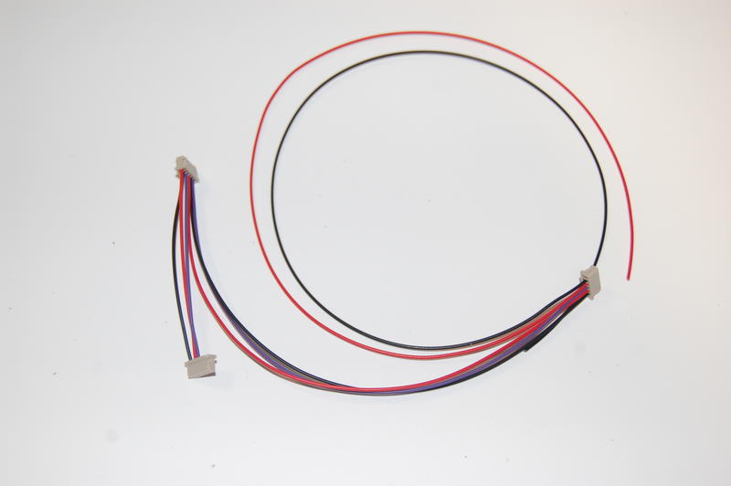
Documents/CubeSat_Sub-Systems/Power/Data/Clyde Space 3U solar panel connection harness 73-large.jpg
