HASP-UMN/CubeSat/Documents/CubeSat_Sub-Systems/Power/p31US-cad-dim-1.png

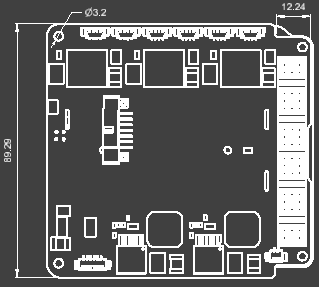
Documents/CubeSat_Sub-Systems/Power/p31US-cad-dim-1.png
