HASP-UMN/CubeSat/Documents/CubeSat_Sub-Systems/Power/p31uss.png

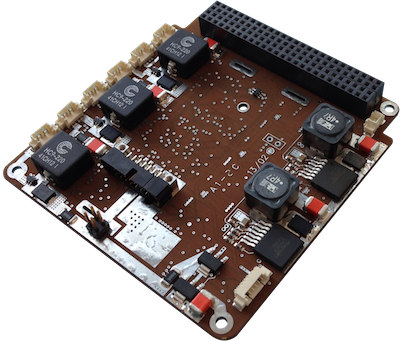
Documents/CubeSat_Sub-Systems/Power/p31uss.png
