HASP-UMN/CubeSat/Other/photo 1.JPG

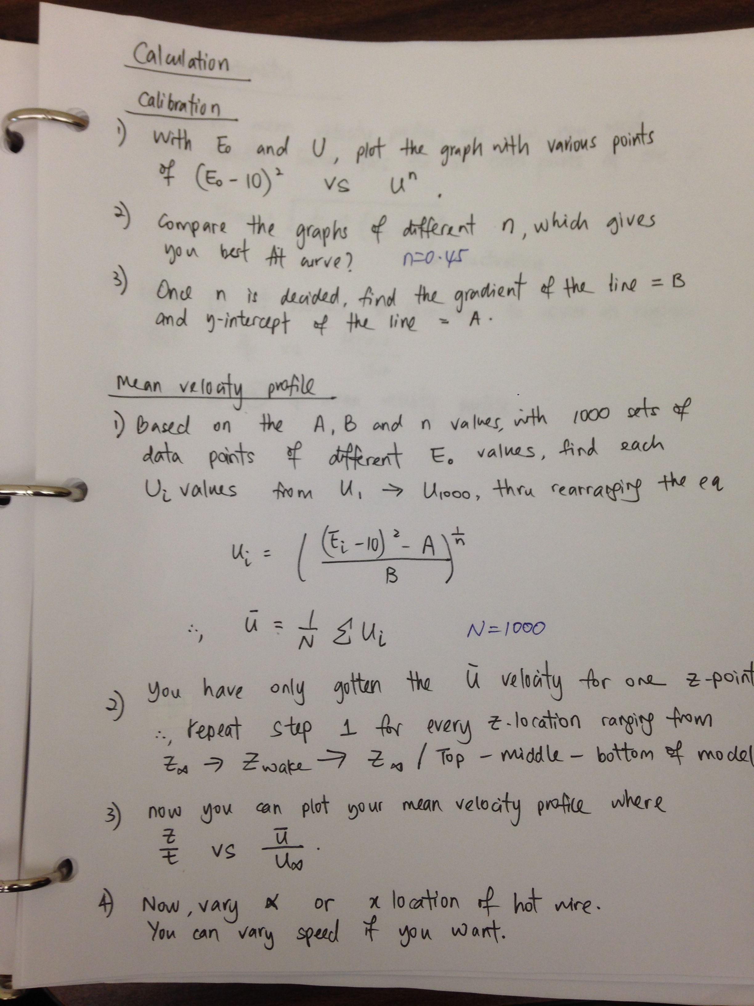
Other/photo 1.JPG
