HASP-UMN/CubeSat/Other/photo 2.JPG

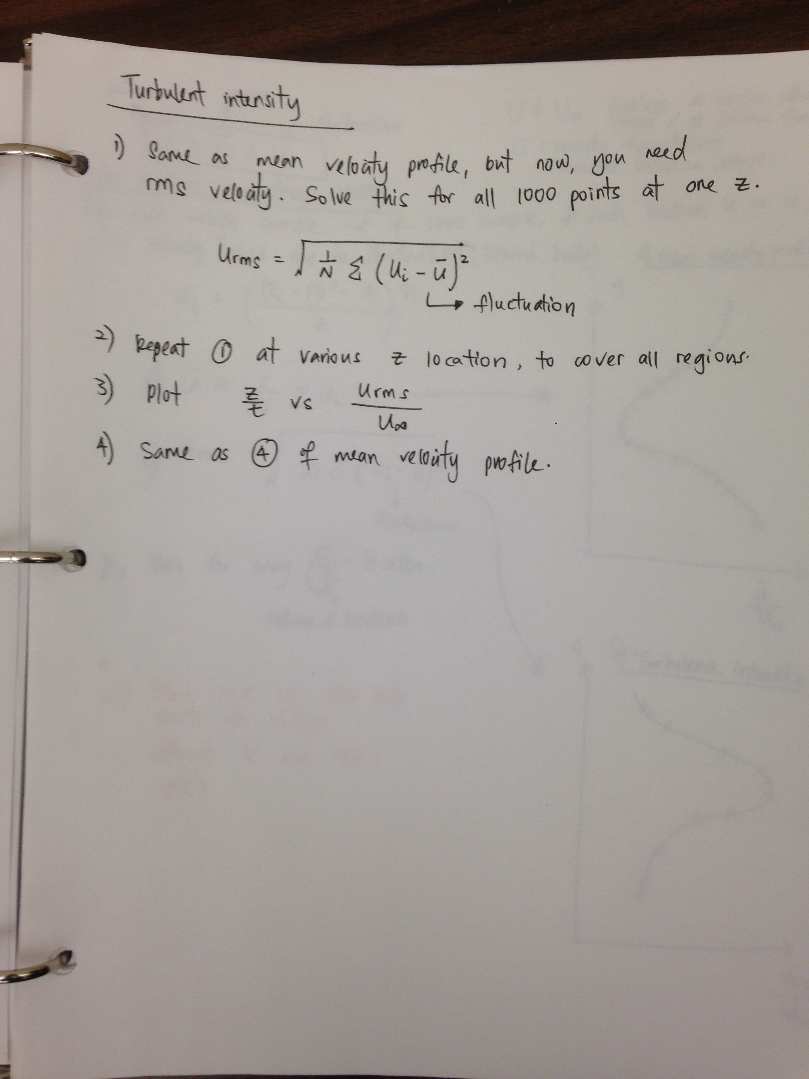
Other/photo 2.JPG
