HASP-UMN/CubeSat/Presentations/Images/74-1269400665-519002e79392dd951417bc56bc1289d6.png

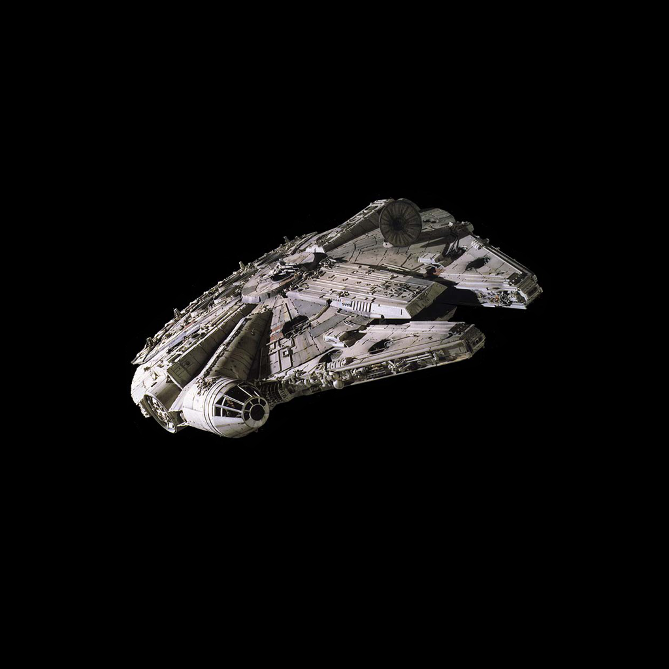
Presentations/Images/74-1269400665-519002e79392dd951417bc56bc1289d6.png
