HASP-UMN/CubeSat/Presentations/Images/514-original.jpg

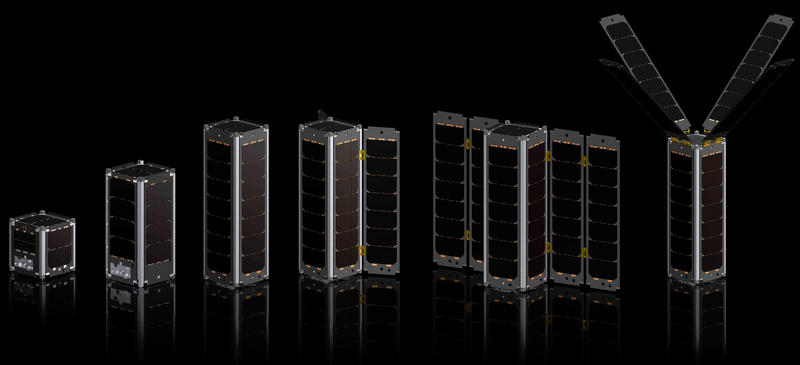
Presentations/Images/514-original.jpg
