HASP-UMN/CubeSat/Presentations/Images/1200_894_EarthHorizonBackground.jpg

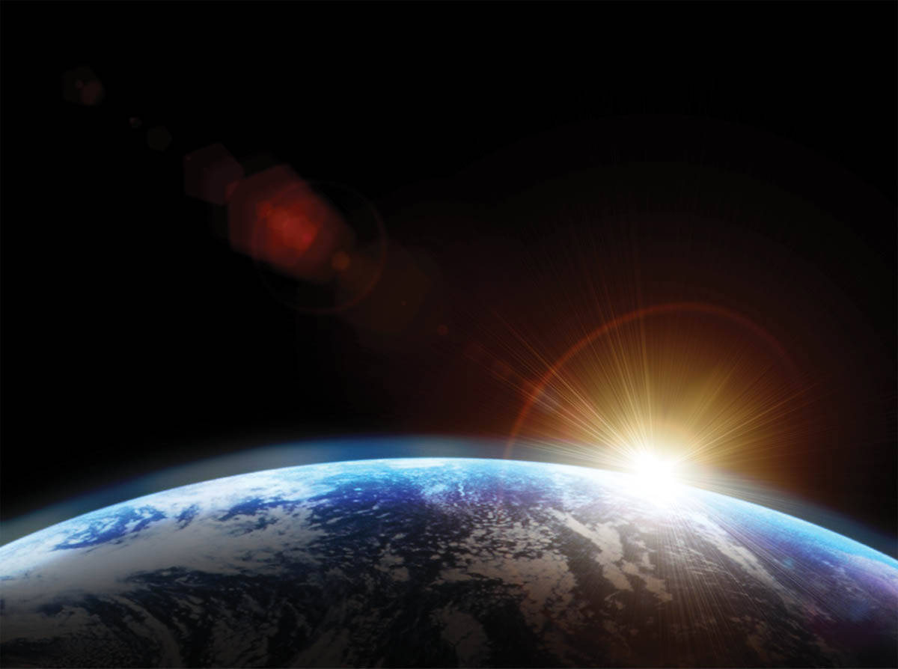
Presentations/Images/1200_894_EarthHorizonBackground.jpg
