HASP-UMN/CubeSat/Presentations/Images/1200_894_EarthHorizonBackground_DARK.jpg

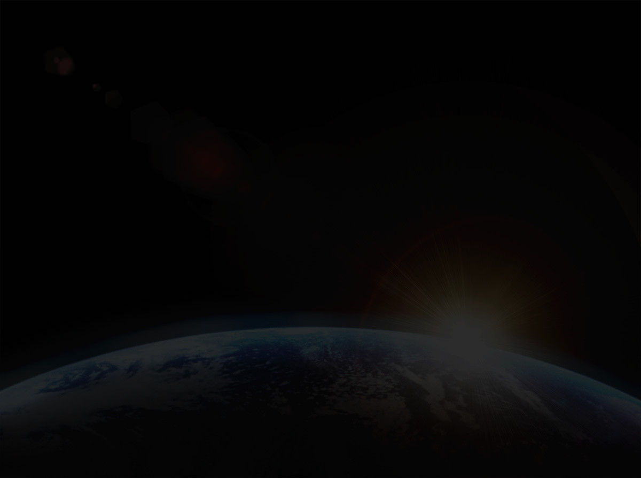
Presentations/Images/1200_894_EarthHorizonBackground_DARK.jpg
