HASP-UMN/CubeSat/Presentations/Images/download.jpg

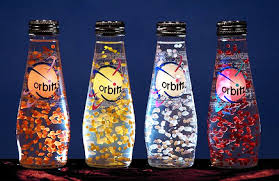
Presentations/Images/download.jpg
