HASP-UMN/CubeSat/Presentations/Images/FULL ASSEM DEPLOYED.png

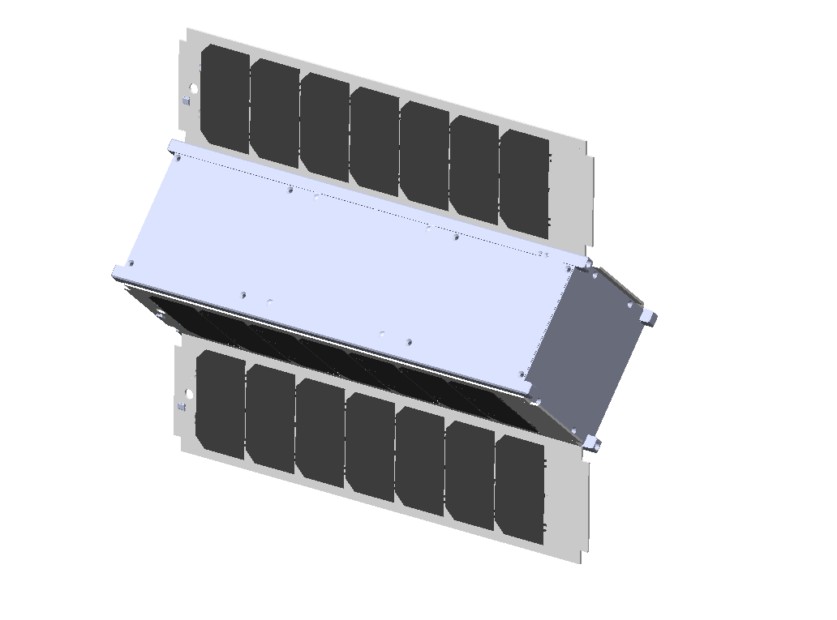
Presentations/Images/FULL ASSEM DEPLOYED.png
