HASP-UMN/CubeSat/Presentations/Images/FULL ASSEM.png

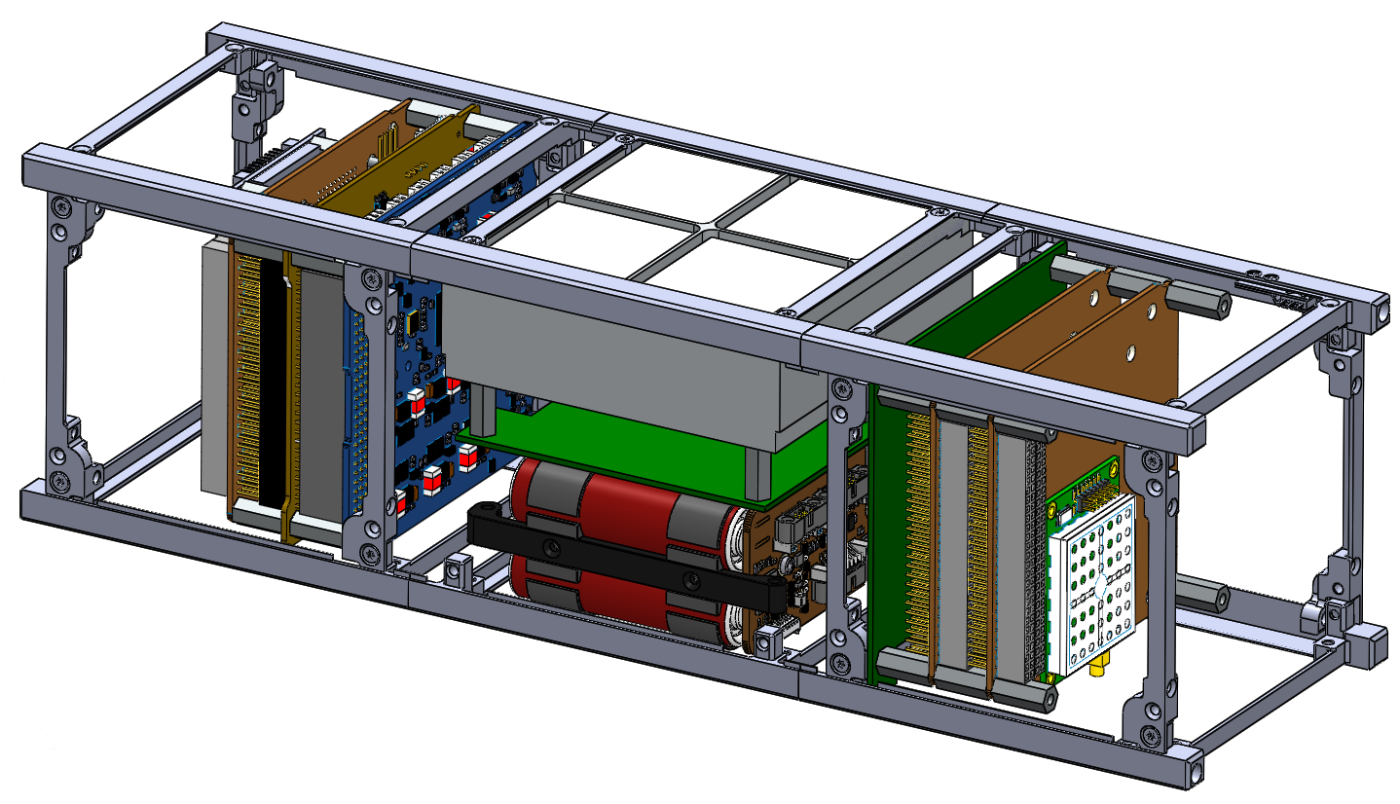
Presentations/Images/FULL ASSEM.png
