HASP-UMN/CubeSat/Cost.xlsx

Sheet: Sheet1
Component | Model | Source | Pwr Req (W) | Cost | # Requested | Total Cost | Purpose | DataSheet
Flight Computer | A712D | GOMSpace | 1 | $5400.00 | 2 | $10800.00 | Control Flight data, tasking 1 extra for benchtop testing. | PDF link (http://gomspace.com/documents/gs-ds-nanomind-a712d-1.5.pdf)
GPS Receiver | OEM 615 | Novatel | .5W |  | 1 | $0.00 | Read GPS data and calculate Positon | PDF link (http://www.novatel.com/assets/Documents/Papers/OEM615.pdf)
GPS Antenna | Single Frequency Mircostrip | Antdevco | N/A | $5000.00 | 1 | $5000.00 | Recieves GPS and passes Signal to GPS | PDF link (http://www.antdevco.com/ADC-0509251107%20R6%20Patch%20data%20sheet_non-ITAR.pdf)
Sun sensors (coarse) | integrated w/ solar panels | GOMSpace | N/A |  | 4 | $0.00 | Price upcharge unkown for "fine" sensors
Solar Panels | NanoPower P110 | GOMSpace | N/A | $6750.00 | 4 | $27000.00 | Recharge Battery and Power CubeSat | PDF link
Battery | NanoPower BPX | GOMSpace | N/A | $6200.00 | 1 | $6200.00 | Power CubeSat (1 Battery) | PDF link
Power Management | P31us | GOMSpace | .5W | $6200.00 | 1 | $6200.00 | Manage Power for CubeSat | PDF link
Radio | MM2-TTL | FreeWave | 4W (transmit) | $1500.00 | 1 | $1500.00 | Send Data to Ground Network w/ Dev kit | PDF link
Antenna (Patch) | CS-CPUT-STX-02 | ClydeSpace | 2W | $4725.00 | 1 | $4725.00 | Enable Long distance Radio | PDF link (http://www.clyde-space.com/documents/2398)
Attitude Control* | ISIS Magnetorqer Board | CubeSatShop | .175 - 1.2W | $10000.00 | 1 | $10000.00 | Provides Attitude Control | PDF link (http://www.isispace.nl/brochures/ISIS.iMTQv2.OS.001_Option%20Sheet%20for%20iMTQv2_v1.0.pdf)
Deployable Solar Panels* | SP-L-DD1S3U-0039 | ClydeSpace |  | $20150.00 | 1 | $20150.00 | Provides additional solar energy and control | PDF link (http://www.clyde-space.com/documents/2410)
Payload | HASP | UofM owned | 5.5W |  | 1 | $0.00 | Detect Gamma Events
 |  |  |  |  |  | $91575.00
* Denotes additional hardware if Passive attitude does not allow for adequate sun sourced power

Sheet: Sheet2
 |  | 75k Estimate
Component | Model | Source | Pwr Req (W) | Cost | Purpose | DataSheet
Flight Computer | A712D | GOMSpace | 1 | $5400.00 | Control Flight data, tasking | PDF link (http://gomspace.com/documents/gs-ds-nanomind-a712d-1.5.pdf)
GPS Receiver | OEM 615 | Novatel | 0.5 | N/A | Read GPS data and calculate Positon | PDF link (http://www.novatel.com/assets/Documents/Papers/OEM615.pdf)
GPS Antenna | ANT-GPS | SpaceQuest | N/A | $3000.00 | Recieves GPS and passes Signal to GPS | PDF link (http://static1.squarespace.com/static/53fb871ce4b02e1724b07963/t/53fcb6a0e4b035e1daf476b8/1409070752614/ANT-GPS.pdf)
Sun sensors (coarse) | integrated w/ solar panels | GOMSpace | N/A |  | Price upcharge unkown for "fine" sensors
Solar Panels | NanoPower P110 | GOMSpace | N/A | $27000.00 | Recharge Battery and Power CubeSat | PDF link
Battery | NanoPower BPX | GOMSpace | N/A | $6200.00 | Power CubeSat (1 Battery) | PDF link
Power Management | P31us | GOMSpace | .5W | $6200.00 | Manage Power for CubeSat | PDF link
Radio | MM2-TTL | FreeWave | 4W (transmit) | $1000.00 | Send Data to Ground Network | PDF link (http://go.freewave.com/MM2-LV-Data-Sheet)
Antenna (Patch) | CS-CPUT-STX-02 | ClydeSpace | 2W | $4725.00 | Enable Long distance Radio | PDF link (http://www.clyde-space.com/documents/2398)
Payload | HASP | UofM owned | 5.5W | $0.00 | Detect Gamma Events
 |  |  |  | $53525.00
