HASP-UMN/CubeSat/Documents/CubeSat_Sub-Systems/Atittude Control/GPS costs.xlsx

GPS
need 2 parts:
GPS receiver: All have accuracy of 10 meters or less
piNAV-L1 GPS
Website: | http://www.skyfoxlabs.com
Datasheet | http://www.skyfoxlabs.com/pdf/piNAV-L1_datasheet.pdf
Cost | $8500
Power: | 540mW
Space Hertiage | Will be launch in December 2016
Operational Temperatures: | -40 to 80 C
size | 75×35×12.5 mm incl. shielding
Weight: | 47 grams
OEM615 | one used with HASP
Website: | http://www.novatel.com/products/gnss-receivers/oem-receiver-boards/oem6-receivers/oem615/#overview
Datasheet | http://www.novatel.com/assets/Documents/Papers/OEM615.pdf
Cost | Unlisted (you said around 12k)
Power: | 1W
Space Hertiage | Unlisted | Have found people that used it before: example: https://directory.eoportal.org/web/eoportal/satellite-missions/e/eseo
Operational Temperatures: | -40 to 85C
size | 71x46x11 mm
Weight: | 24 g
CPS12-V1
Website: | http://www.spacequest.com
Datasheet | http://static1.squarespace.com/static/53fb871ce4b02e1724b07963/t/53fcb41fe4b01bd08e4a83c3/1409070111249/GPS12-V1+Receiver%2C+Product+Sheet+Ver+4.pdf
Cost | $29000
Power: | 1.2W
Space Hertiage | Does not list though says have partenerd with many companies including NASA in the past, also listed as Space Qualified
Operational Temperatures: | -40 to 85 C
size | 100mm x 70mm x 25mm
Weight: | 160 grams
GPS Antenna:
Single Frequency Microstrip Patch Antenna
Website: | http://www.antdevco.com/
Datasheet | http://www.antdevco.com/ADC-0509251107%20R6%20Patch%20data%20sheet_non-ITAR.pdf
Type: | Patch
Cost | 5000
Power: | Powered by reievcer
Space Hertiage | Tons can be found on their website
Operational Temperatures: | -65 to 100 C
size | 3in by 3in
Weight: | ~100g
ANT-GPS
Website: | http://www.spacequest.com
Datasheet | http://static1.squarespace.com/static/53fb871ce4b02e1724b07963/t/53fcb6a0e4b035e1daf476b8/1409070752614/ANT-GPS.pdf
Type: | Hemispherical
Cost | 3000 | http://www.spacequest.com/customers/
Power: | Powered by reievcer
Space Hertiage | Does not list though says have partenerd with many companies including NASA in the past
Operational Temperatures: | -65 to 100 C
size | 2 in by 2in
Weight: | 82g
