HASP-UMN/CubeSat/Documents/CubeSat_Sub-Systems/Communications/Hardware Prices.xlsx

Product | Type | Brand | Estimated Cost | Comments
MM2-TTL | Radio | Freewave | $1000 - $1500 | Price range included in case we want the dev kit or buy a second radio
S-Band Patch | Antenna | Clyde Space | $5000 - $5500 | Found some other non-patch antennas around this price range
