HASP-UMN/CubeSat/Documents/CubeSat_Sub-Systems/Atittude Control/Sun Sensor research.xlsx

Color coding | Sun Sensor | Datasheet link | Update freq. | Power Req | Mass | Cost | Flight Heritage | Accuracy | FOV | Operating Temp | Size | Other Comments
Bad | SSBV cubesat sun sensor | http://www.ssbv.com/ProductDatasheets/page39/page29/index.html | 10Hz (customer ADC dependent) | 50mW (5V supply, 10mA draw) | 5 grams | $3300/unit | UKube‐1 and TDS‐1 | 0.5 deg | 114 deg. | -25C to +50C (tested, components are rated for -40C to +85C) | 33mmx11mmx6mm
unknown/non-ideal | SOLARMEMS SSoC-A60 | http://www.solar-mems.com/smt_pdf/commercial_brochure_SSOC-A.pdf | Analog, requires ADC | 36mW | 25 grams | € 2200.00/unit (via cubesatshop) | NANOSAT 1B | 0.3 deg | 120 deg. | -40C to +85C | 50mmx12mmx30mm | too large
Good, meets req | ADCOLE Digital Sun Sensor | http://www.adcole.com/aerospace/digital-sun-sensors/digital-sun-sensor-128-degree/ | unknown | unknown | unknown | unknown | Cassini, MAVEN,Pathfinder, Curiosity (company has sun sensors on these) | 0.5 deg | 128 deg | unknown | unknown | No Reply
 | Airbus Coarse Bi-Axis Sun Sensor | http://www.space-airbusds.com/media/document/gnc_2_bass_2015-v_std_b-def.pdf | unknown | unknown | 65 grams | unknown | Helios,Envisat,Odin,Myriad | unknown | 180 deg (pyramid-type sensor) | -40C to +90C | 70 x 82 x 23 mm | Would require us to determine Calibration scheme as it only puts out raw analog signals
 | Gomspace integrated sensor | http://gomspace.com/index.php?p=products-p110 | unknown | unknown | unknown | Comes with the solar panels | AAU-Cubesat | unknown | unknown | -40C to +85C | 5.5mmx11mmx11mm
 | Space Micro MSS-01 Sun sensor | http://www.spacemicro.com/assets/datasheets/guidance-and-nav/MSS.pdf | unknown | unknown | 36 grams | unknown | unknown | 1 deg | 120deg(?) | -40C to +93C | 35mm x 25mmx25mm | Not sure what "60° full-angle circular field of view" means. Mounting could be difficult
 | SOLARMEMS nanoSSoC-D60 | http://www.solar-mems.com/smt_pdf/Brochure_NanoSSOC-D60.pdf | 50Hz (max 10Hz, if using I2C(?)) | 115mW | 6.5 grams | € 3,600.00/unit | CEPHEUS and five confidential missions from Clyde Space and Innovative Space Solutions | <0.5 deg | 120 deg. | -30C to +85C | 43x14x5.9mm
 | Try ADCOLE again since they're stuff is very good. If we run into a problem with sun sensors not being able to update fast enough, they may be able to help. Otherwise, maybe we'll have to do an intertial solution.
 | Contacts | Name | email
 | SOLAR MEMS | Manuel Rodriguez | manuel.rodriguez@solar-mems.com
 | SSBV | James Barrington-Brown | jbb@newspacesystems.com
 | Gomspace | Suneel and Chuck over at the Asterlabs
