HASP-UMN/CubeSat/Documents/CubeSat_Sub-Systems/Atittude Control/Research/Magnetorquers.xlsx

Model | Price | Magnetic Moment [Am^2] | Power Requirement | Mass [g] | Axis
NSS Magnetorquer Rod | $1600 | 0.2 | 200mW | 30 | 1
ISIS Magnetorquer | $8738.40 | 0.2 | 175mW max of 1.2W | 196 | 3
Clydespace Z-Axis | $1425 | 0.19 | ??? | 50 | 1
