HASP-UMN/CubeSat/CDR Structure/GRID/GRID.SLDASM

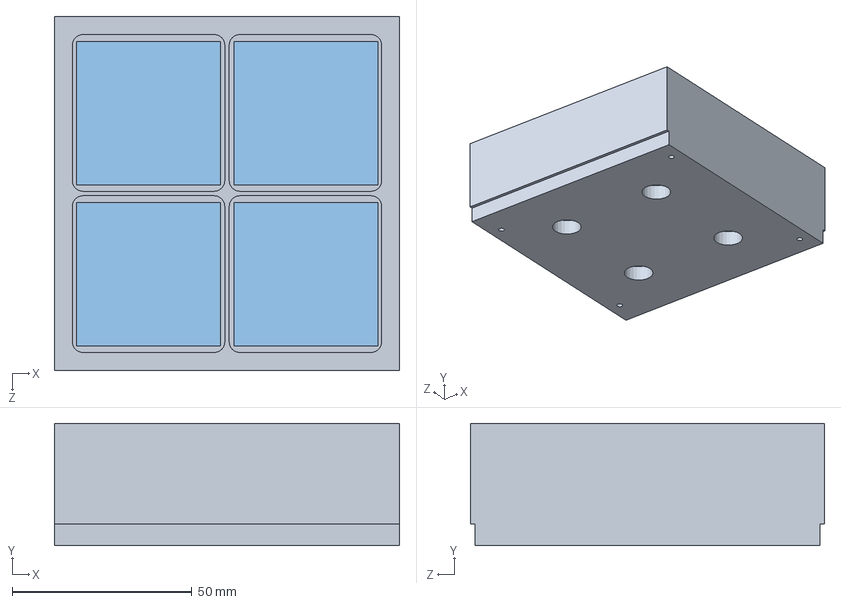
[picture p162: CAD file, 2015-12-16]
CDR Structure/GRID/GRID.SLDASM
96.0 x 34.0 x 98.4 mm
Detector housing
Foam x 4
Scintillator x 4
