HASP-UMN/CubeSat/Structure/New Structure/Top_Frame.sldasm

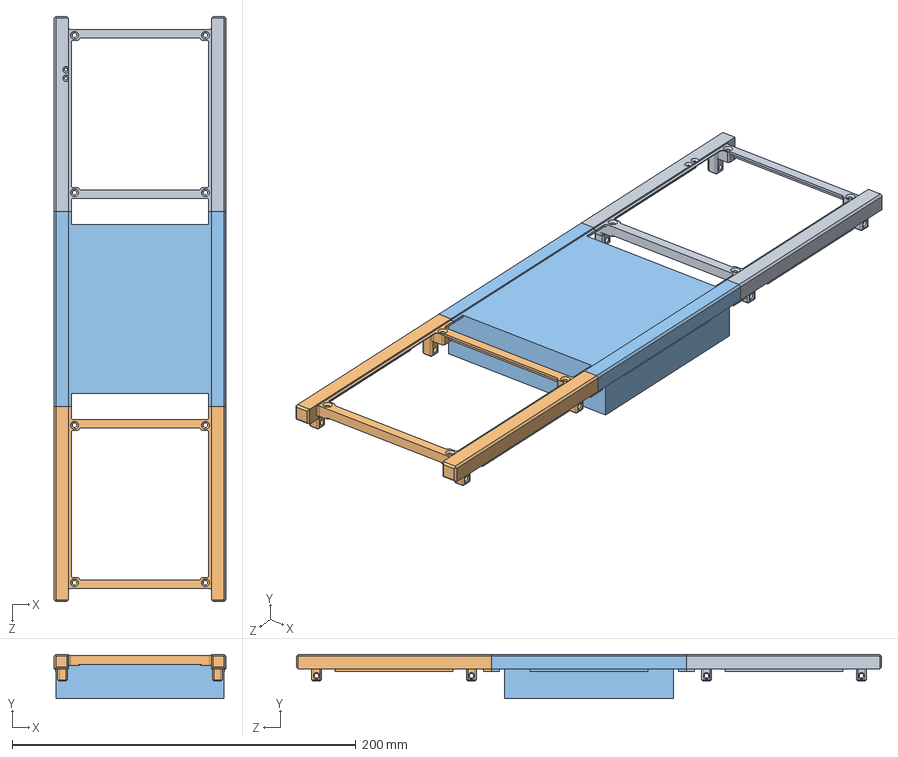
[picture p163: CAD file, 2015-12-11]
Structure/New Structure/Top_Frame.sldasm
100.0 x 25.8 x 340.5 mm
SIDE_FRAME_007BOTTOM
SIDE_FRAME_007TOP
DETECTOR_SIDE_FRAME_007MIDDLE
Scintillator x 4
