HASP-UMN/CubeSat/Structure/PowerAssm.SLDASM

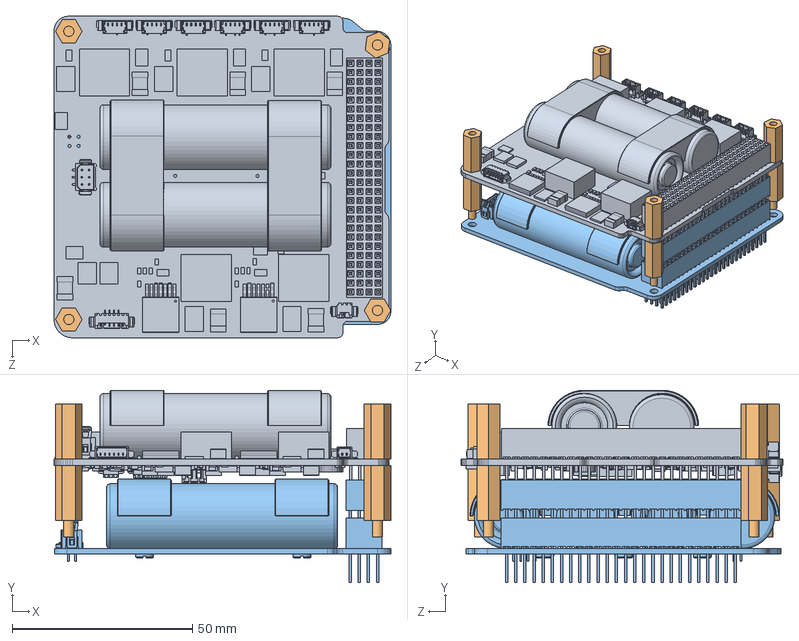
[picture p164: CAD file, 2015-12-11]
Structure/PowerAssm.SLDASM
93.6 x 53.4 x 89.3 mm
POWER_NanoPower P31u-9
PC104 standoff x 8
POWER_bp4-2.0
