HASP-UMN/CubeSat/CDR Structure/CUSTOMBOARDS.SLDASM

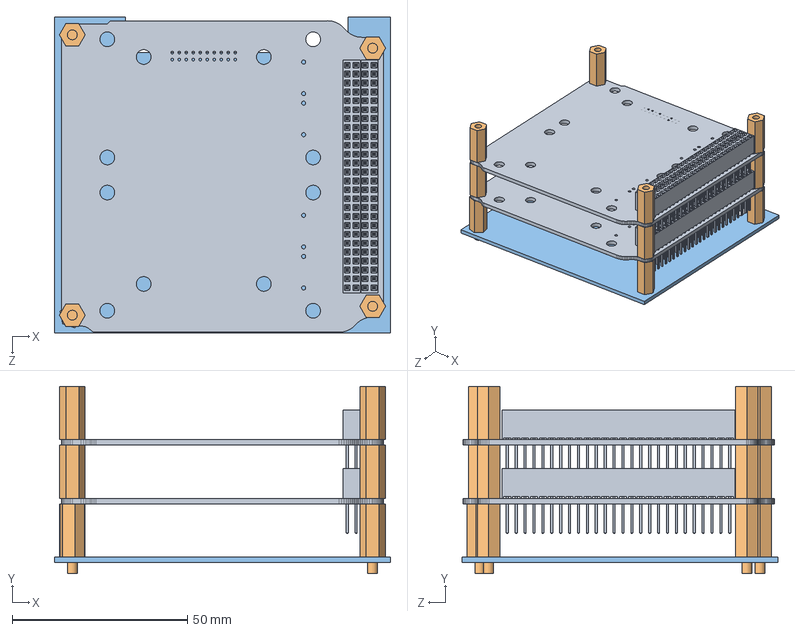
[picture p165: CAD file, 2015-12-16]
CDR Structure/CUSTOMBOARDS.SLDASM
95.9 x 53.5 x 90.2 mm
CANBUSBOARD x 2
PC104 standoff 15.2 x 12
PC104 preprocessor board
