HASP-UMN/CubeSat/Structure/CubesatAssembly.SLDASM

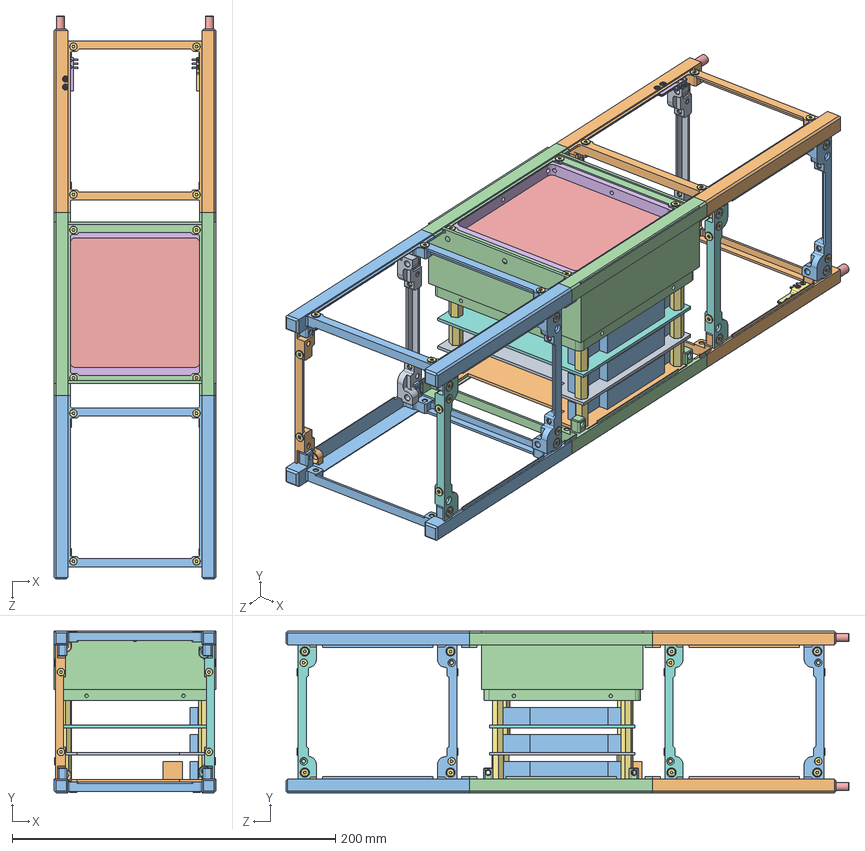
[picture p166: CAD file, 2015-11-15]
Structure/CubesatAssembly.SLDASM
100.0 x 100.0 x 348.5 mm
NUT_M1_6 x 4
SCREW_M1_6X4 x 8
SPRING_02 x 2
KILL_SWITCH_LEVER x 2
KILL_SWITCH_SWITCH x 2
BRACKET_KS_007B x 2
BRACKET_KS_007A x 2
KILL_SWITCH_PINS x 2
KILL_SWITCH_BODY x 2
SIDE_FRAME_007BOTTOM x 2
SIDE_FRAME_007TOP x 2
SIDE_FRAME_007MIDDLE x 2
BUSJE_001 x 2
KILL_SWITCH_PIN x 2
SCREW_M2_5X6 x 64
REVD_02-1_RIB_F x 2
REVE_02-1_RIB_C x 2
REVE_02-1_RIB_E x 2
REVD_02-1_RIB_D x 2
Detector housing
Detector carbon window
Detector window clamp
PC104 standoff x 12
PC104 board
PC104 board 2
PC104 preprocessor board
PC104 connector x 3
