HASP-UMN/CubeSat/Structure/New Structure/Bottom_Frame.sldasm

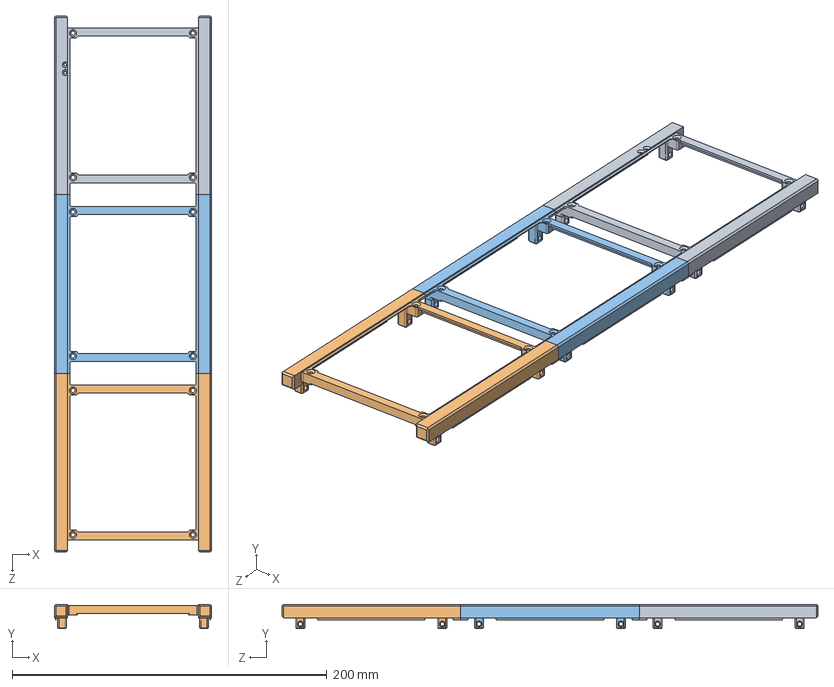
[picture p167: CAD file, 2015-12-11]
Structure/New Structure/Bottom_Frame.sldasm
100.0 x 15.4 x 340.5 mm
SIDE_FRAME_007BOTTOM
SIDE_FRAME_007TOP
SIDE_FRAME_007MIDDLE
