HASP-UMN/CubeSat/Structure/GRID/GRID.SLDASM

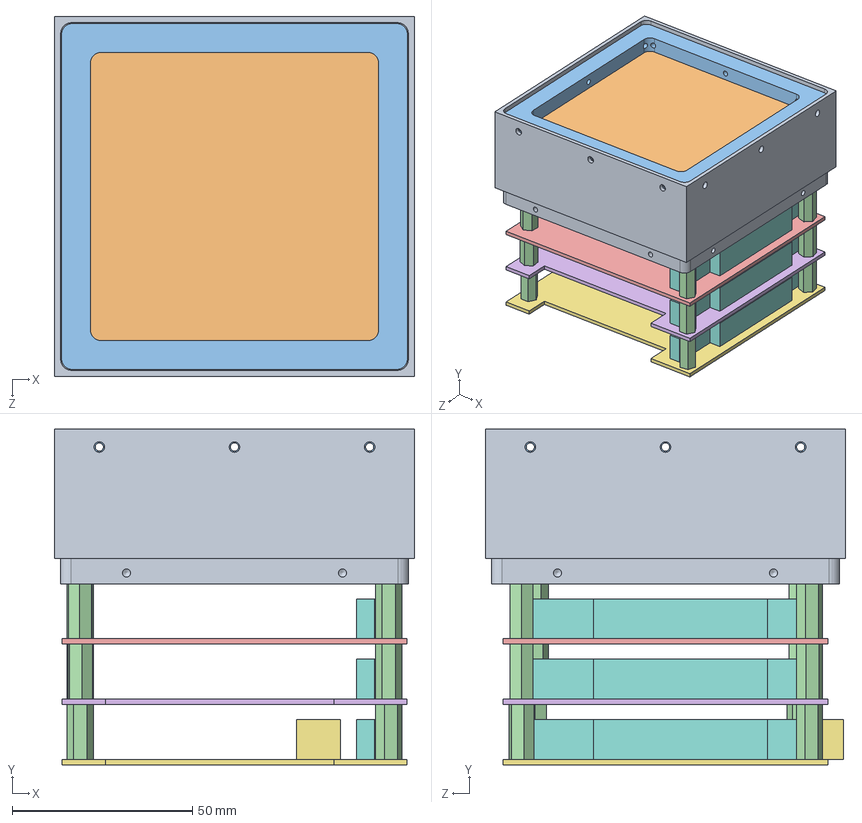
[picture p168: CAD file, 2015-11-17]
Structure/GRID/GRID.SLDASM
100.0 x 93.3 x 100.0 mm
Detector housing
Detector carbon window
Detector window clamp
PC104 standoff x 12
PC104 board
PC104 board 2
PC104 preprocessor board
PC104 connector x 3
