HASP-UMN/CubeSat/Structure/New Structure/Detector_Frame.SLDASM

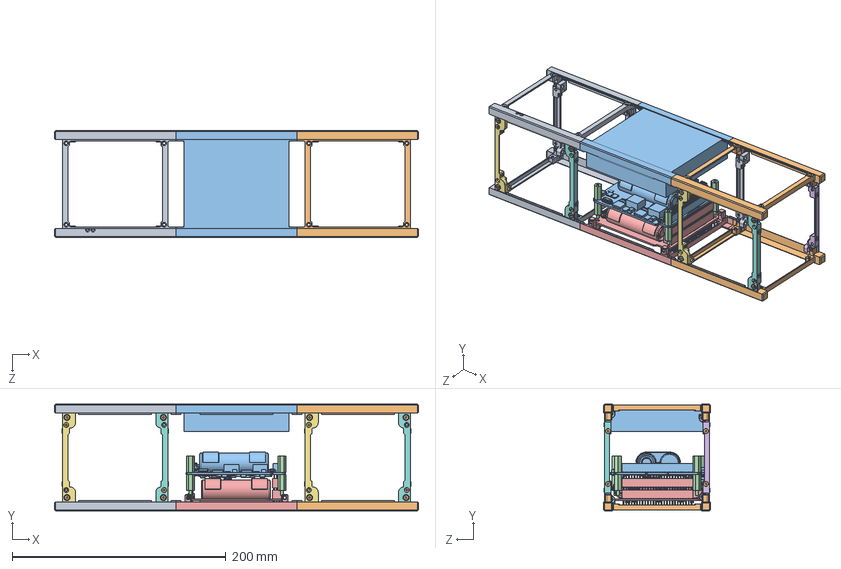
[picture p169: CAD file, 2015-12-11]
Structure/New Structure/Detector_Frame.SLDASM
340.5 x 100.0 x 100.0 mm
SIDE_FRAME_007BOTTOM x 2
SIDE_FRAME_007TOP x 2
DETECTOR_SIDE_FRAME_007MIDDLE
Scintillator x 4
SIDE_FRAME_007MIDDLE
REVD_02-1_RIB_F x 2
REVE_02-1_RIB_C x 2
REVE_02-1_RIB_E x 2
REVD_02-1_RIB_D x 2
SCREW_M2_5X6 x 40
POWER_NanoPower P31u-9
PC104 standoff x 8
POWER_bp4-2.0
