HASP-UMN/CubeSat/Structure/New Structure/Bracing.SLDASM

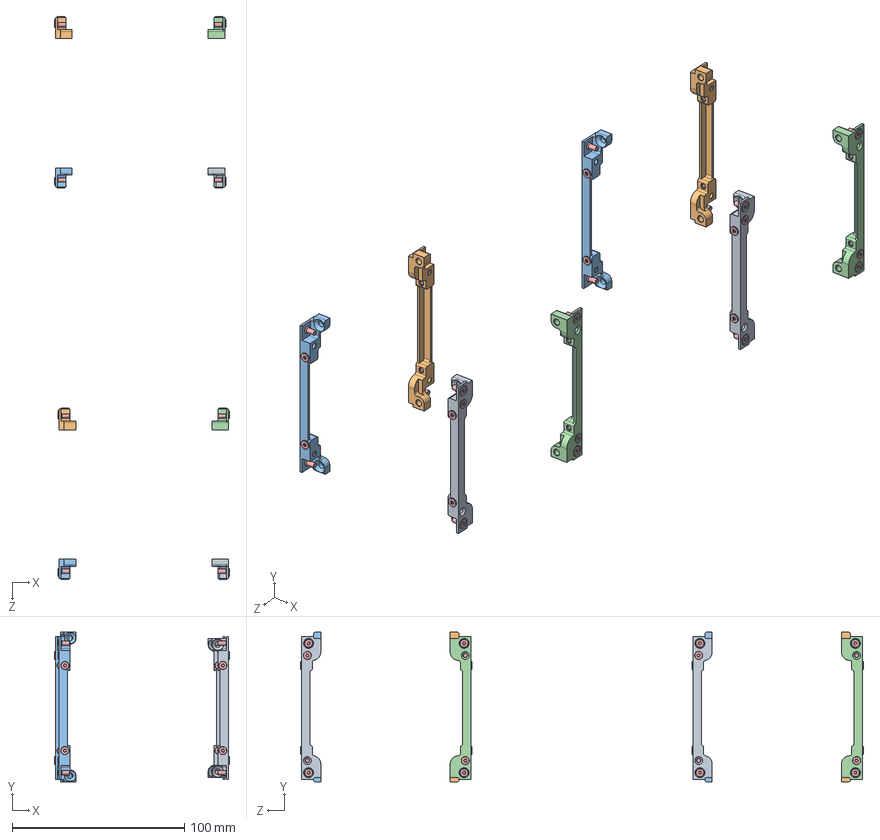
[picture p170: CAD file, 2015-12-11]
Structure/New Structure/Bracing.SLDASM
101.8 x 86.8 x 326.6 mm
REVD_02-1_RIB_F x 2
REVE_02-1_RIB_C x 2
REVE_02-1_RIB_E x 2
REVD_02-1_RIB_D x 2
SCREW_M2_5X6 x 40
