HASP-UMN/CubeSat/Structure/Structure/3U_STS_FRAME_ASEMBLED_02_ASM.sldasm

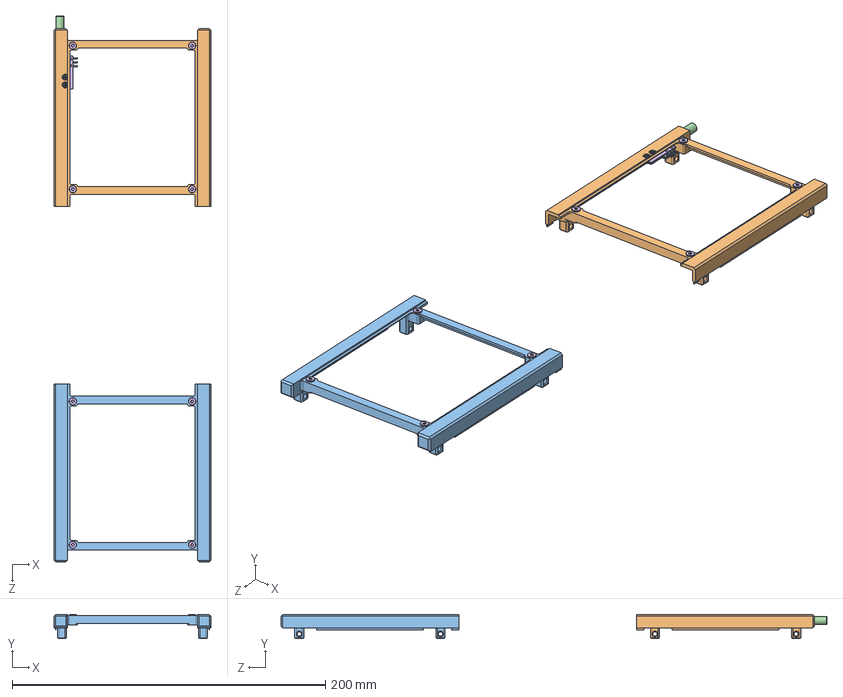
[picture p171: CAD file, 2015-12-11]
Structure/Structure/3U_STS_FRAME_ASEMBLED_02_ASM.sldasm
100.0 x 15.4 x 348.5 mm
NUT_M1_6 x 2
SCREW_M1_6X4 x 4
SPRING_02
KILL_SWITCH_LEVER
KILL_SWITCH_SWITCH
BRACKET_KS_007B
BRACKET_KS_007A
KILL_SWITCH_PINS
KILL_SWITCH_BODY
SIDE_FRAME_007BOTTOM
SIDE_FRAME_007TOP
BUSJE_001
KILL_SWITCH_PIN
SCREW_M2_5X6 x 8
