HASP-UMN/CubeSat/CDR Structure/FRAME/SIDE_FRAME_DETECTOR_TRIPLE_ASM.SLDASM

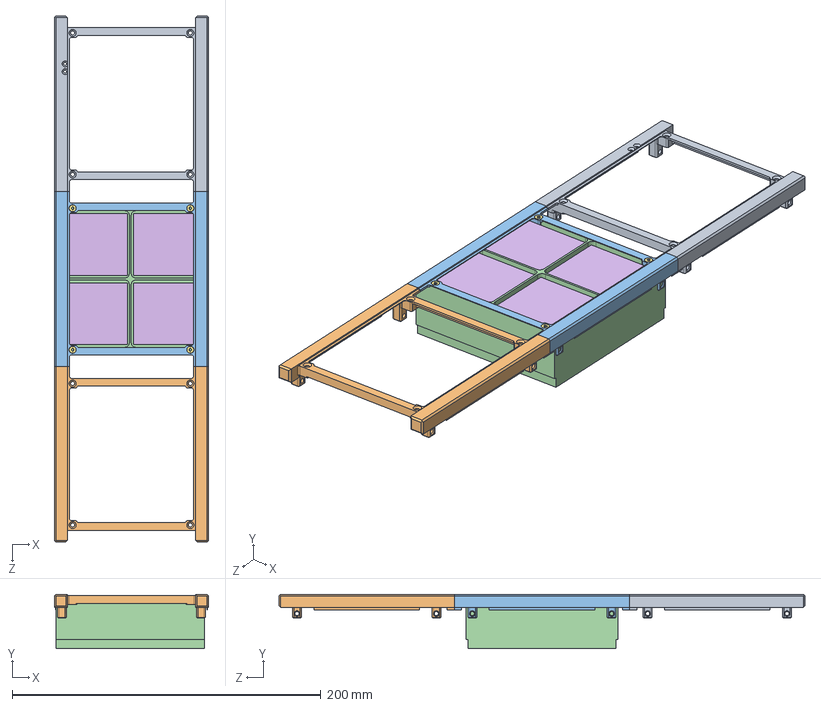
[picture p172: CAD file, 2015-12-16]
CDR Structure/FRAME/SIDE_FRAME_DETECTOR_TRIPLE_ASM.SLDASM
100.0 x 35.2 x 340.5 mm
SIDE_FRAME_007BOTTOM
SIDE_FRAME_007TOP
SIDE_FRAME_DETECTOR_MIDDLE
Detector housing
Foam x 4
Scintillator x 4
SCREW_M2_5X6 x 4
