HASP-UMN/CubeSat/Structure/GRID/Assem2.SLDASM

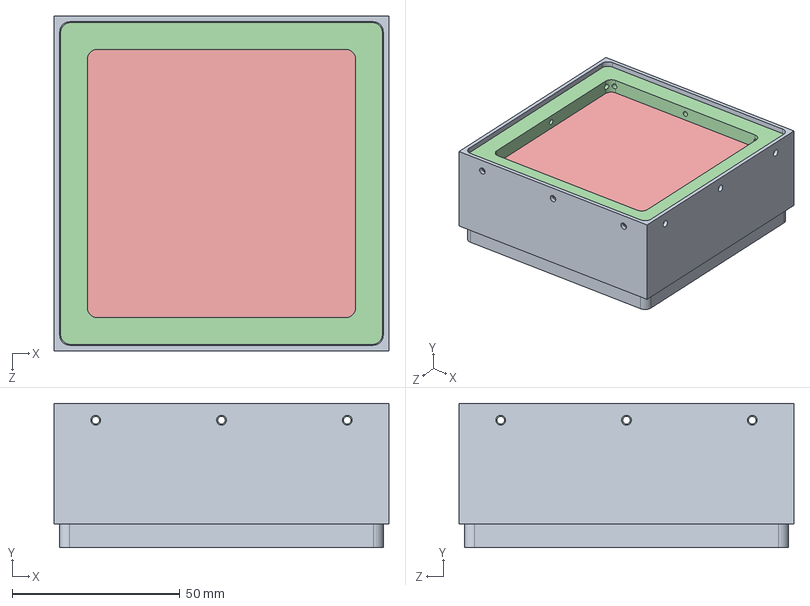
[picture p173: CAD file, 2015-11-15]
Structure/GRID/Assem2.SLDASM
100.0 x 43.0 x 100.0 mm
Detector housing
Foam x 4
Scintillator x 4
Detector window clamp
Detector carbon window
