HASP-UMN/CubeSat/CDR Structure/FRAME/KS_MECH_UPDATED_OPEN_ASM.sldasm

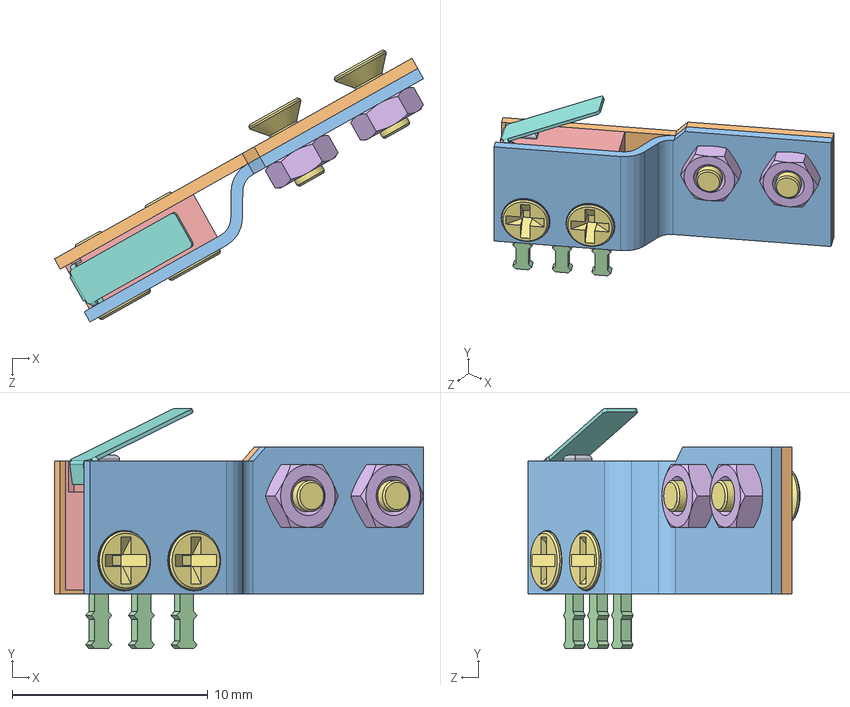
[picture p174: CAD file, 2015-12-16]
CDR Structure/FRAME/KS_MECH_UPDATED_OPEN_ASM.sldasm
18.9 x 12.3 x 13.9 mm
KILL_SWITCH_SWITCH
BRACKET_KS_007B
BRACKET_KS_007A
KILL_SWITCH_PINS
KILL_SWITCH_BODY
NUT_M1_6 x 2
SCREW_M1_6X4 x 4
KILL_SWITCH_LEVER
