HASP-UMN/CubeSat/CDR Structure/FRAME/REVE_02-1_ASSEMBLY_RIB_CDEF_ASM.sldasm

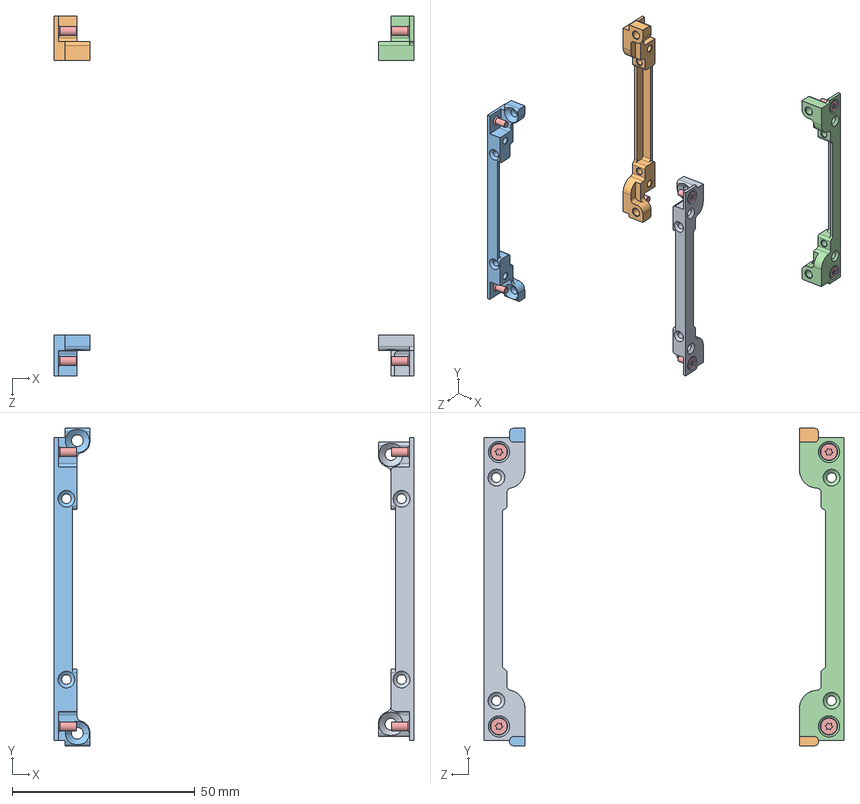
[picture p175: CAD file, 2015-12-16]
CDR Structure/FRAME/REVE_02-1_ASSEMBLY_RIB_CDEF_ASM.sldasm
98.4 x 86.8 x 98.4 mm
REVD_02-1_RIB_F
REVE_02-1_RIB_C
REVE_02-1_RIB_E
REVD_02-1_RIB_D
SCREW_M2_5X6 x 8
