HASP-UMN/CubeSat/CDR Structure/FRAME/SIDE_FRAME_DETECTOR_MIDDLE_ASM.SLDASM

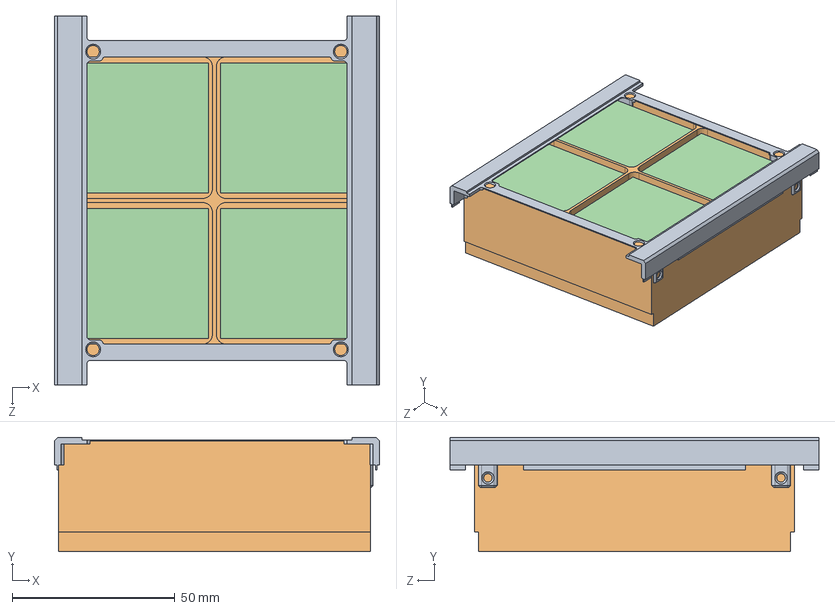
[picture p176: CAD file, 2015-12-16]
CDR Structure/FRAME/SIDE_FRAME_DETECTOR_MIDDLE_ASM.SLDASM
100.0 x 35.2 x 113.5 mm
SIDE_FRAME_DETECTOR_MIDDLE
Detector housing
Foam x 4
Scintillator x 4
