HASP-UMN/CubeSat/CDR Structure/FRAME/FULL 3U Frame/ISIS 3U Cubesat Structure.SLDASM

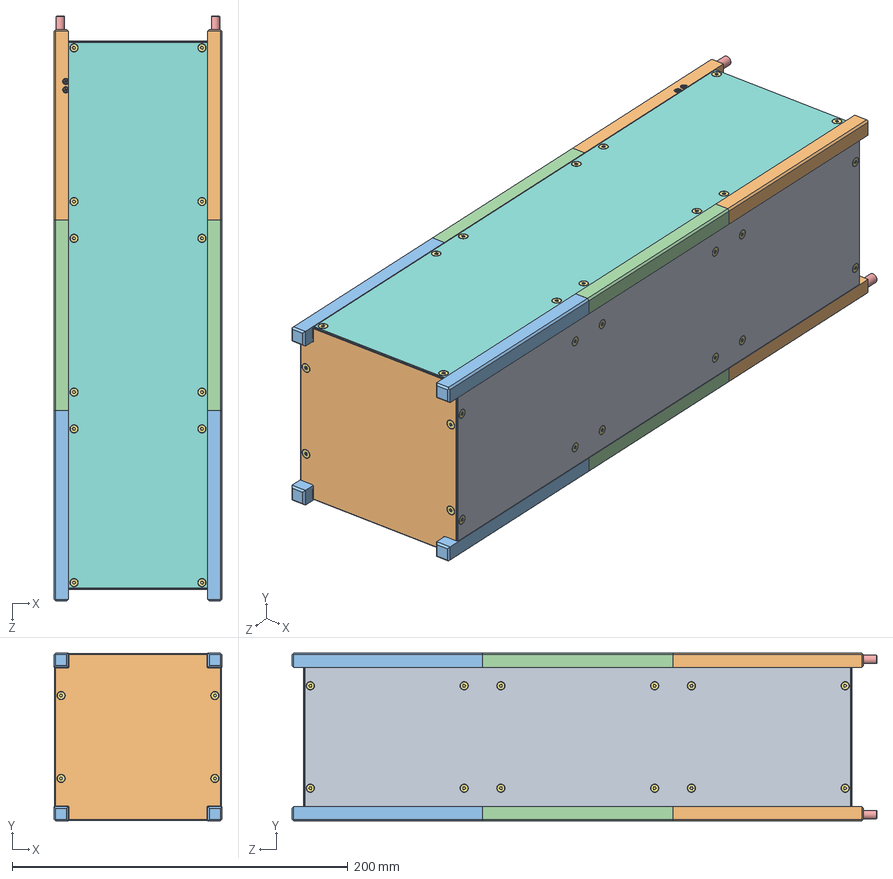
[picture p177: CAD file, 2015-12-16]
CDR Structure/FRAME/FULL 3U Frame/ISIS 3U Cubesat Structure.SLDASM
100.0 x 100.0 x 348.5 mm
NUT_M1_6 x 4
SCREW_M1_6X4 x 8
SPRING_02 x 2
KILL_SWITCH_LEVER x 2
KILL_SWITCH_SWITCH x 2
BRACKET_KS_007B x 2
BRACKET_KS_007A x 2
KILL_SWITCH_PINS x 2
KILL_SWITCH_BODY x 2
SIDE_FRAME_007BOTTOM x 2
SIDE_FRAME_007TOP x 2
SIDE_FRAME_007MIDDLE x 2
BUSJE_001 x 2
KILL_SWITCH_PIN x 2
SCREW_M2_5X6 x 96
SSP_F_3U x 2
SSP_R x 2
TSP_R_V_01 x 2
REVD_02-1_RIB_F x 3
REVE_02-1_RIB_C x 3
REVE_02-1_RIB_E x 3
REVD_02-1_RIB_D x 3
