HASP-UMN/CubeSat/CDR Structure/FRAME/KILL_SWITCH_AV46J_ASM.sldasm

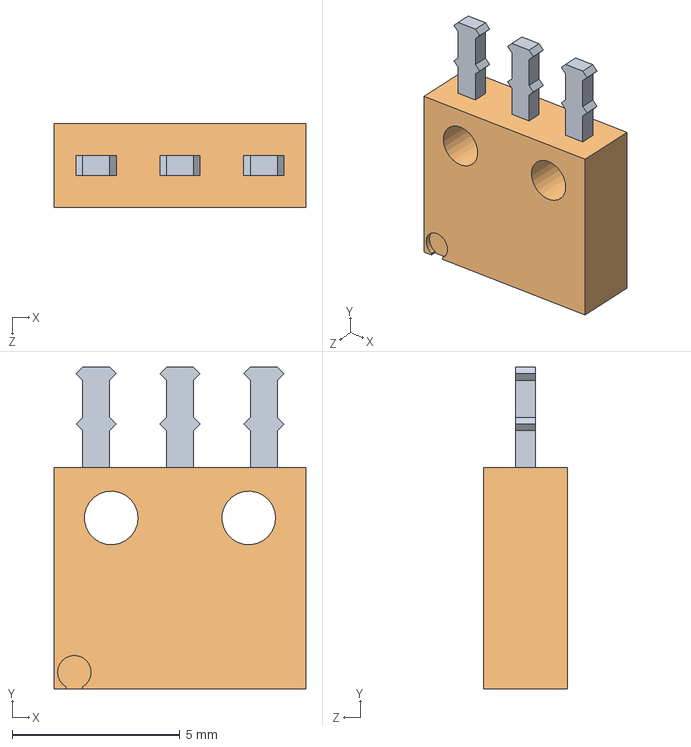
[picture p178: CAD file, 2015-12-16]
CDR Structure/FRAME/KILL_SWITCH_AV46J_ASM.sldasm
7.50 x 9.60 x 2.50 mm
KILL_SWITCH_PINS
KILL_SWITCH_BODY
