HASP-UMN/CubeSat/CDR Structure/BP8/bpx-8.SLDASM

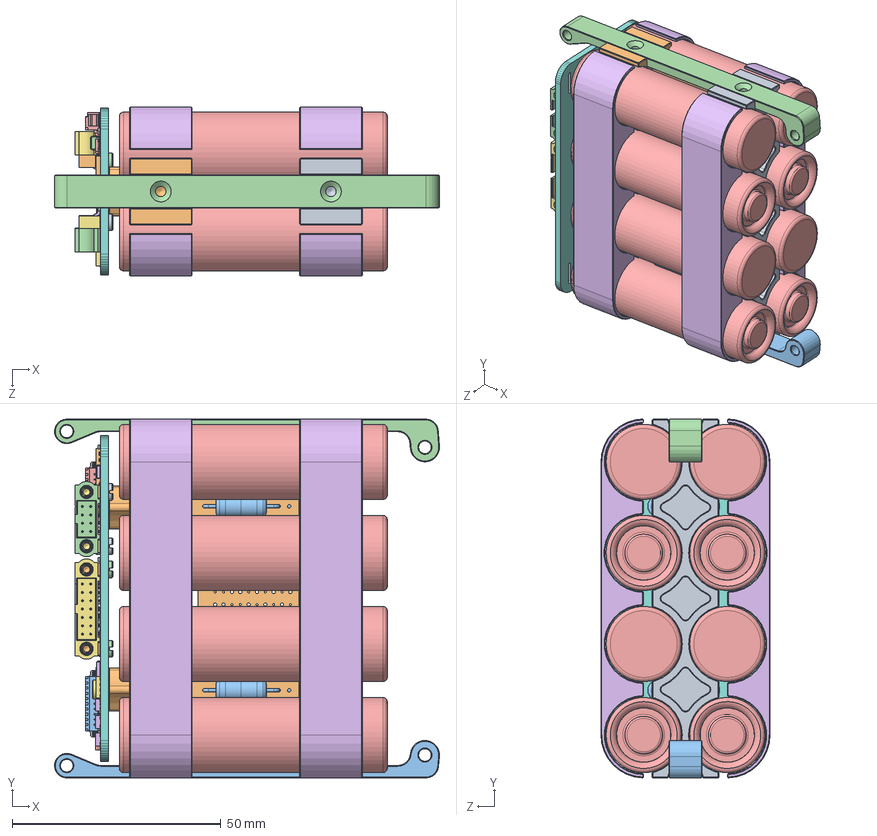
[picture p179: CAD file, 2015-12-16]
CDR Structure/BP8/bpx-8.SLDASM
92.2 x 85.9 x 40.5 mm
mp4-bridge-A (20-60-1520)
mp4-bridge-B (20-60-1521)
mp4-rail-A (20-60-1522)
mp4-rail-B (20-60-1523)
18650-bracket-bp4 x 4
M2.5x12-hex x 2
Board_bpx
Extruded x 14
M80-2702098_SEPARATE_ROWS
M80-2360005 x 4
M80-2370005 x 4
Extruded_1 x 9
Extruded_2 x 17
CircuitWorks-SOT-23 x 6
Extruded_3 x 3
M80-2702098_SEPARATE_ROWS_1 x 2
M80-2360005_1 x 14
M80-2370005_1 x 14
Extruded_4
Extruded_5
SW3dPS-0805_SMD_Capacitor x 4
cm322522
User_Library-ABS07_ABS07_Body_2
User_Library-ABS07_ABS07_Body2_2
User_Library-ABS07_ABS07_Beschriftung_2
User_Library-ABS07_ABS07_Pads_2
Extruded_6
Extruded_7
msop-12
Extruded_8
Extruded_9 x 2
Extruded_10
Extruded_11
bpx_toplayer
Board_bpxheat
heatres x 4
