HASP-UMN/CubeSat/CDR Structure/3U 7xUTJ Cell Side Solar Panel - Pumpkin Compatible.SLDASM

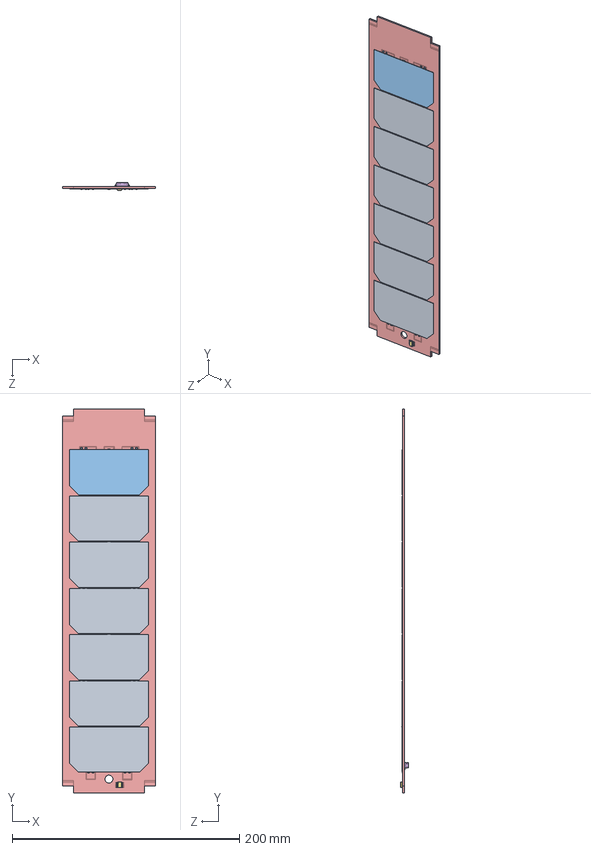
[picture p180: CAD file, 2015-12-16]
CDR Structure/3U 7xUTJ Cell Side Solar Panel - Pumpkin Compatible.SLDASM
81.7 x 338.0 x 7.10 mm
3D-15-00255-REVB_2 x 6
3D-27-00323-REV03_2
3D-15-00255-REVB
3D-27-00323-REV03
3U pcb
DF13-6P-125H
SO-8
