HASP-UMN/CubeSat/CDR Structure/Power.SLDASM

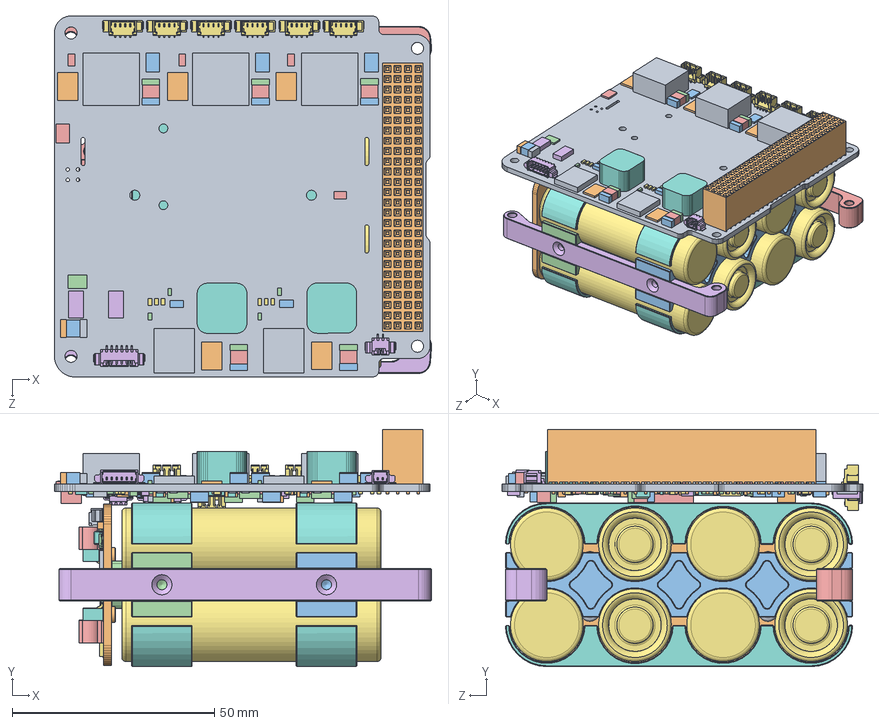
[picture p181: CAD file, 2015-12-16]
CDR Structure/Power.SLDASM
93.3 x 58.7 x 89.3 mm
Board
Extruded x 22
Extruded_1 x 18
Extruded_2 x 78
Extruded_3 x 4
Extruded_4 x 49
Extruded_5 x 6
Extruded_6 x 4
Extruded_7 x 4
Extruded_8 x 4
Extruded_9 x 5
Extruded_10 x 15
Extruded_11 x 4
Extruded_12 x 7
Extruded_13
Extruded_14
Extruded_15 x 16
Extruded_16 x 4
Extruded_17 x 20
Extruded_18 x 3
Extruded_19
Extruded_20
Extruded_21
Extruded_22 x 12
Extruded_23 x 24
Extruded_24 x 11
Extruded_25 x 11
Extruded_26 x 11
Extruded_27 x 18
Extruded_28 x 9
Extruded_29 x 6
Extruded_30 x 2
Extruded_31 x 3
Extruded_32 x 3
Extruded_33
Extruded_34 x 3
533980471-picoblade-4 x 7
Extruded_35 x 2
Extruded_36 x 3
Extruded_37 x 5
Extruded_38 x 2
Extruded_39 x 6
Extruded_40
Extruded_41
Extruded_42 x 3
Extruded_43 x 6
Extruded_44
esq-126-39-g-d
mp4-bridge-A (20-60-1520)
mp4-bridge-B (20-60-1521)
mp4-rail-A (20-60-1522)
mp4-rail-B (20-60-1523)
18650-bracket-bp4 x 4
M2.5x12-hex x 2
Board_bpx
M80-2702098_SEPARATE_ROWS
M80-2360005 x 4
M80-2370005 x 4
CircuitWorks-SOT-23 x 6
M80-2702098_SEPARATE_ROWS_1 x 2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
