HASP-UMN/CubeSat/CDR Structure/NanoPower P31us/NanoPower-P31us-8.001.SLDASM

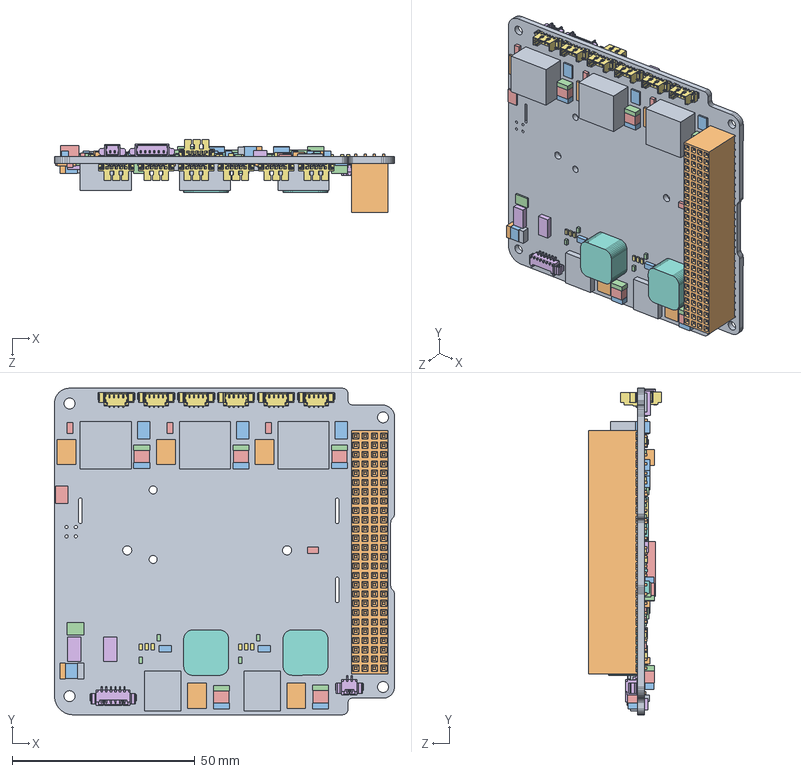
[picture p182: CAD file, 2015-12-16]
CDR Structure/NanoPower P31us/NanoPower-P31us-8.001.SLDASM
92.9 x 89.3 x 20.0 mm
Board
Extruded x 8
Extruded_1 x 9
Extruded_2 x 61
Extruded_3
Extruded_4 x 48
Extruded_5 x 5
Extruded_6 x 3
Extruded_7 x 3
Extruded_8 x 3
Extruded_9 x 3
Extruded_10 x 14
Extruded_11 x 3
Extruded_12 x 7
Extruded_13
Extruded_14
Extruded_15 x 16
Extruded_16 x 4
Extruded_17 x 20
Extruded_18 x 3
Extruded_19
Extruded_20
Extruded_21
Extruded_22 x 12
Extruded_23 x 24
Extruded_24 x 11
Extruded_25 x 11
Extruded_26 x 11
Extruded_27 x 18
Extruded_28 x 9
Extruded_29 x 6
Extruded_30 x 2
Extruded_31 x 3
Extruded_32 x 3
Extruded_33
Extruded_34 x 3
533980471-picoblade-4 x 7
Extruded_35 x 2
Extruded_36 x 3
Extruded_37 x 5
Extruded_38 x 2
Extruded_39 x 6
Extruded_40
Extruded_41
Extruded_42 x 3
Extruded_43 x 6
Extruded_44
esq-126-39-g-d
