HASP-UMN/CubeSat/(list of files, cad)

Other CAD files:
CDR Structure/FRAME/FULL 3U Frame/SIDE_FRAME_007_TRIPLE_ASM.sldasm
CDR Structure/aaaSTEP FILE DUMP/P100.sldasm
CDR Structure/BP8/U11_bpx.sldasm
CDR Structure/FRAME/FULL 3U Frame/KILL_SWITCH_AV46J_ASM.sldasm
CDR Structure/NanoPower P31us/U604.sldasm
Structure/GRID/Assem1.SLDASM
CDR Structure/BP8/U2_bpx.sldasm
CDR Structure/NanoPower P31us/R3_M506.sldasm
CDR Structure/NanoPower P31us/U1_M503.sldasm
CDR Structure/aaaSTEP FILE DUMP/3U_STS_FRAME_ASEMBLED_02_ASM.sldasm
CDR Structure/NanoPower P31us/U201.sldasm
CDR Structure/BP8/nanopower-bpx-2.sldasm
CDR Structure/BP8/C4_bpx.sldasm
CDR Structure/NanoPower P31us/C102.sldasm
CDR Structure/BP8/Rks1_bpx.sldasm
CDR Structure/FRAME/FULL 3U Frame/3U_STS_FRAME_ASEMBLED_02_ASM_1.sldasm
CDR Structure/BP8/C3_bpx.sldasm
CDR Structure/NanoPower P31us/C203.sldasm
CDR Structure/NanoPower P31us/R412.sldasm
CDR Structure/BP8/U3_bpx.sldasm
CDR Structure/NanoPower P31us/Q2_B2.sldasm
CDR Structure/FRAME/REVD_RIB_HELICOILS_ASM.sldasm
CDR Structure/NanoPower P31us/C4_M505.sldasm
CDR Structure/BP8/C4_bpxheat.sldasm
CDR Structure/FRAME/FULL 3U Frame/REVD_RIB_HELICOILS_ASM.sldasm
CDR Structure/NanoPower P31us/U2_B1.sldasm
CDR Structure/BP8/C3_bpxheat.sldasm
CDR Structure/7 cell string end tabs - trimmed tabs.sldasm
CDR Structure/NanoPower P31us/C1_M506.sldasm
CDR Structure/BP8/C20_bpx.sldasm
CDR Structure/FRAME/SIDE_FRAME_007_TRIPLE_ASM.sldasm
CDR Structure/NanoPower P31us/C502.sldasm
CDR Structure/BP8/R2_bpx.sldasm
CDR Structure/FRAME/FULL 3U Frame/REVE_02-1_ASSEMBLY_RIB_CDEF_ASM.sldasm
CDR Structure/NanoPower P31us/R107_B1.sldasm
CDR Structure/BP8/Q201_bpx.sldasm
CDR Structure/NanoPower P31us/C2_M505.sldasm
CDR Structure/NanoPower P31us/C1_B2.sldasm
CDR Structure/NanoPower P31us/U606.sldasm
CDR Structure/NanoPower P31us/R603.sldasm
CDR Structure/NanoPower P31us/R5_M502.sldasm
CDR Structure/BP8/Rks4_bpx.sldasm
CDR Structure/NanoPower P31us/R201.sldasm
CDR Structure/BP8/P1_bpx.sldasm
CDR Structure/FRAME/FULL 3U Frame/KS_MECH_UPDATED_OPEN_ASM.sldasm
CDR Structure/BP8/Qh1_bpx.sldasm
CDR Structure/NanoPower P31us/U1_B3.sldasm
CDR Structure/BP8/R17_bpx.sldasm
CDR Structure/NanoPower P31us/C400.sldasm
CDR Structure/BP8/Rm1_bpx.sldasm
CDR Structure/NanoPower P31us/U1_M506.sldasm
CDR Structure/NanoPower P31us/R601.sldasm
CDR Structure/BP8/Cc2_bpx.sldasm
CDR Structure/NanoPower P31us/C401.sldasm
CDR Structure/BP8/R37_bpx.sldasm
CDR Structure/NanoPower P31us/C3_M502.sldasm
CDR Structure/NanoPower P31us/R804.sldasm
CDR Structure/NanoPower P31us/U203.sldasm
CDR Structure/BP8/Rh3_bpx.sldasm
CDR Structure/NanoPower P31us/R206.sldasm
CDR Structure/NanoPower P31us/R208.sldasm
CDR Structure/NanoPower P31us/C3_M504.sldasm
CDR Structure/NanoPower P31us/R502.sldasm
CDR Structure/BP8/Qh2_bpx.sldasm
CDR Structure/NanoPower P31us/R101.sldasm
CDR Structure/NanoPower P31us/C6_B3.sldasm
CDR Structure/BP8/BPX_heater_1.sldasm
CDR Structure/BP8/PBAT2_bpx.sldasm
CDR Structure/NanoPower P31us/C503.sldasm
CDR Structure/BP8/Rbatm_bpx.sldasm
CDR Structure/NanoPower P31us/R4_M502.sldasm
CDR Structure/BP8/TP1_bpxheat.sldasm
CDR Structure/NanoPower P31us/U2_M505.sldasm
CDR Structure/BP8/C1_bpxheat.sldasm
CDR Structure/NanoPower P31us/C200.sldasm
CDR Structure/NanoPower P31us/Q201.sldasm
CDR Structure/NanoPower P31us/U2_M503.sldasm
CDR Structure/NanoPower P31us/C2_B33.sldasm
CDR Structure/NanoPower P31us/R204.sldasm
CDR Structure/BP8/C18_bpx.sldasm
CDR Structure/NanoPower P31us/R614.sldasm
CDR Structure/NanoPower P31us/R2_B2.sldasm
CDR Structure/NanoPower P31us/R3_B50.sldasm
CDR Structure/BP8/C101_bpx.sldasm
CDR Structure/NanoPower P31us/R102.sldasm
CDR Structure/NanoPower P31us/Q406.sldasm
CDR Structure/BP8/C1_bpx.sldasm
CDR Structure/NanoPower P31us/R406.sldasm
CDR Structure/BP8/C100_bpx.sldasm
CDR Structure/NanoPower P31us/L1_B2.sldasm
CDR Structure/NanoPower P31us/R3_B3.sldasm
CDR Structure/NanoPower P31us/P105.sldasm
CDR Structure/BP8/R1_bpx.sldasm
CDR Structure/NanoPower P31us/R504.sldasm
CDR Structure/NanoPower P31us/L800.sldasm
CDR Structure/BP8/Rks2_bpx.sldasm
CDR Structure/NanoPower P31us/C4_B33.sldasm
CDR Structure/BP8/Rh2_bpx.sldasm
CDR Structure/BP8/R16_bpx.sldasm
CDR Structure/NanoPower P31us/C4_M506.sldasm
CDR Structure/NanoPower P31us/R4_B1.sldasm
CDR Structure/NanoPower P31us/R3_B1.sldasm
CDR Structure/NanoPower P31us/R4_M506.sldasm
CDR Structure/BP8/Qsda_bpx.sldasm
CDR Structure/NanoPower P31us/R6_M505.sldasm
CDR Structure/NanoPower P31us/R7_M501.sldasm
CDR Structure/NanoPower P31us/U2_B2.sldasm
CDR Structure/BP8/U1_bpx.sldasm
CDR Structure/NanoPower P31us/C204.sldasm
CDR Structure/NanoPower P31us/TMP1.sldasm
CDR Structure/BP8/CXTAL2_bpx.sldasm
CDR Structure/NanoPower P31us/C5_B2.sldasm
CDR Structure/BP8/Y1_bpx.sldasm
CDR Structure/NanoPower P31us/C100.sldasm
CDR Structure/BP8/R38_bpx.sldasm
CDR Structure/NanoPower P31us/C2_M506.sldasm
CDR Structure/BP8/C21_bpx.sldasm
CDR Structure/NanoPower P31us/KS1.sldasm
CDR Structure/BP8/C17_bpx.sldasm
CDR Structure/NanoPower P31us/C603.sldasm
CDR Structure/BP8/kaos-B.sldasm
CDR Structure/BP8/Rc4_bpx.sldasm
CDR Structure/NanoPower P31us/C2_B50.sldasm
CDR Structure/NanoPower P31us/R404.sldasm
CDR Structure/NanoPower P31us/D802.sldasm
CDR Structure/BP8/R100_bpx.sldasm
CDR Structure/NanoPower P31us/R413.sldasm
CDR Structure/BP8/Q4_bpx.sldasm
CDR Structure/NanoPower P31us/R607.sldasm
CDR Structure/18650-bracket-bp4.sldprt
CDR Structure/18650.sldprt
CDR Structure/3D-27-00323-REV03.sldprt
CDR Structure/3D-27-00323-REV03_2.sldprt
CDR Structure/803216624.sldprt
CDR Structure/803217224.sldprt
CDR Structure/803217344.sldprt
CDR Structure/803217464.sldprt
CDR Structure/BP8/1336663280.sldasm
CDR Structure/BP8/18650-bracket-bp4.sldprt
CDR Structure/BP8/18650.sldprt
CDR Structure/BP8/532610871.sldasm
CDR Structure/BP8/532610971.sldasm
CDR Structure/BP8/537219600.sldasm
CDR Structure/BP8/537219856.sldasm
CDR Structure/BP8/537220112.sldasm
CDR Structure/BP8/537220624.sldasm
CDR Structure/BP8/537220752.sldasm
CDR Structure/BP8/537221008.sldasm
CDR Structure/BP8/537221136.sldasm
CDR Structure/BP8/537222800.sldasm
CDR Structure/BP8/537223824.sldasm
CDR Structure/BP8/644170576.sldasm
CDR Structure/BP8/688141264.sldasm
CDR Structure/BP8/688143824.sldasm
CDR Structure/BP8/688144080.sldasm
CDR Structure/BP8/688144848.sldasm
CDR Structure/BP8/803216624.sldprt
CDR Structure/BP8/803217224.sldprt
CDR Structure/BP8/803217344.sldprt
CDR Structure/BP8/803217464.sldprt
CDR Structure/BP8/Board_bpx.sldprt
CDR Structure/BP8/Board_bpxheat.sldprt
CDR Structure/BP8/C10_bpx.sldasm
CDR Structure/BP8/C11_bpx.sldasm
CDR Structure/BP8/C19_bpx.sldasm
CDR Structure/BP8/C2_bpxheat.sldasm
CDR Structure/BP8/C8_bpx.sldasm
CDR Structure/BP8/COMPOUND_1.sldprt
CDR Structure/BP8/COMPOUND_2.sldprt
CDR Structure/BP8/CXTAL1_bpx.sldasm
CDR Structure/BP8/Cc1_bpx.sldasm
CDR Structure/BP8/CircuitWorks-SOT-23.sldprt
CDR Structure/BP8/Cm1_bpx.sldasm
CDR Structure/BP8/D1_bpx.sldasm
CDR Structure/BP8/Extruded.sldprt
CDR Structure/BP8/Extruded_1.sldprt
CDR Structure/BP8/Extruded_10.sldprt
CDR Structure/BP8/Extruded_11.sldprt
CDR Structure/BP8/Extruded_2.sldprt
CDR Structure/BP8/Extruded_3.sldprt
CDR Structure/BP8/Extruded_4.sldprt
CDR Structure/BP8/Extruded_5.sldprt
CDR Structure/BP8/Extruded_6.sldprt
CDR Structure/BP8/Extruded_7.sldprt
CDR Structure/BP8/Extruded_8.sldprt
CDR Structure/BP8/Extruded_9.sldprt
CDR Structure/BP8/L3_bpx.sldasm
CDR Structure/BP8/M2.5x12-hex.sldprt
CDR Structure/BP8/M80-2250000.sldasm
CDR Structure/BP8/M80-2250000_1.sldasm
CDR Structure/BP8/M80-226.sldasm
CDR Structure/BP8/M80-226_1.sldasm
CDR Structure/BP8/M80-2360005.sldprt
CDR Structure/BP8/M80-2360005_1.sldprt
CDR Structure/BP8/M80-2370005.sldprt
CDR Structure/BP8/M80-2370005_1.sldprt
CDR Structure/BP8/M80-2702098_SEPARATE_ROWS.sldprt
CDR Structure/BP8/M80-2702098_SEPARATE_ROWS_1.sldprt
CDR Structure/BP8/P2_bpx.sldasm
CDR Structure/BP8/PBAT1_bpx.sldasm
CDR Structure/BP8/PGND1_bpx.sldasm
CDR Structure/BP8/Qks_bpx.sldasm
CDR Structure/BP8/Qscl_bpx.sldasm
CDR Structure/BP8/R39_bpx.sldasm
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
