HASP-UMN/CubeSat/Other/Calibration Curve1.xlsx

Sheet: Calibration Curve
C Data Columns are: time | Chan 101 | View Finder |  | Measurements (m) | Uncertainty (m) | Force (lb) | Force (N) | Uncertainty (N) | MINIMA | N | Uncertainty | P (N) | Uncertainty (N) |  |  | Web Uncertainty Program
C Channel Labels: secs | volts | pixel value |  |  |  |  |  |  | Intensity
C Channel conv factors: 1 | 1 | 1 |  |  |  |  |  |  | 101 | 1 | 1 | 158.21 | 28.57 |  |  | 1 | 158.21 | 1 | 28.56956594
0.035 | 0.0408477 | 133 | Thickness (h) | 0.00585 | 0.000127 | 22.96 | 102.12 | 26.33 | 76 | 2 | 1 | 375.52 | 37.26 |  |  | 2 | 375.52 | 1 | 37.26179698
0.102 | 0.0411529 | 133 | Width (w) | 0.0318 | 0.000127 | 23.13 | 102.88 | 26.36 | 86 | 3 | 1 | 590.00 | 45.84105257 |  |  | 3 | 590.00 | 1 | 45.84105257
0.202 | 0.0421002 | 133 |  |  |  | 23.66 | 105.25 | 26.45 | 98 | 4 | 1 | 825.18 | 55.24817491 |  |  | 4 | 825.18 | 1 | 55.24817491
0.302 | 0.0420374 | 133 |  |  |  | 23.63 | 105.09 | 26.44 | 102 | 5 | 1 | 1051.64 | 64.30683625 |  |  | 5 | 1051.64 | 1 | 64.30683625
0.402 | 0.0417691 | 133 |  |  |  | 23.47 | 104.42 | 26.42 | 103 | 6 | 1 | 1280.62 | 73.46609354 |  |  | 6 | 1280.62 | 1 | 73.46609354
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
