HASP-UMN/CubeSat/FMEA.xlsx

Sheet: Key
Key *
Probability
A | Extremely unlikely (virtually impossible or no known occurrences on similar products or processes, with many running hours)
B | Remote (relatively few failures)
C | Occasional (occasional failures)
D | Reasonably Possible (repeated failures)
E | Frequent (failure is almost inevitable)
Severity
1 | No relevant effect on reliability or safety
2 | Very minor, no damage, no injuries, only results in a maintenance action (only noticed by discriminating customers)
3 | Minor, low damage, light injuries (affects very little of the system, noticed by average customer)
4 | Moderate, moderate damage, injuries possible (most customers are annoyed, mostly financial damage)
5 | Critical (causes a loss of primary function; Loss of all safety Margins, 1 failure away from a catastrophe, severe damage, severe injuries, max 1 possible death )
6 | Catastrophic (product becomes inoperative; the failure may result in complete unsafe operation and possible multiple deaths)
Prob/Sev | 1 | 2 | 3 | 4 | 5 | 6
A | Low | Low | Low | Low | Moderate | High
B | Low | Low | Low | Moderate | High | Unacceptable
C | Low | Low | Moderate | Moderate | High | Unacceptable
D | Low | Moderate | Moderate | High | Unacceptable | Unacceptable
E | Moderate | Moderate | High | Unacceptable | Unacceptable | Unacceptable
* From Wikipedia page on FMEA

Sheet: FMEA
 |  |  |  | (A - E) | (1 - 6) | (Automatic)
Failure Mode | Subsystem | Mechanism | System Effects | Probability | Severity | Risk Level | Mitigation
Radio failure | COM | electrical short, internal damage | communication is impossible | B | 6 | unacceptable | Test components before launch. Ensure low vibration during launch.
Hard drive failure | COM | random chance, internal damage | data collection is impossible | B | 6 | unacceptable | Make sure hard drive space worthy before launch.
Failed ground connection | COM | power outage, weather | data temporarily cannot be transmitted | C | 2 | low | None.
Files get stuck in code loop | COM | software bug | cannot sent next data file | A | 4 | low | Command failsafes such as clear buffer, load new file, and reboot
Gyroscope status read failure | ADNC | mechanical damage, software bug | lose accuracy of attitude solution | B | 2 | low | Test components before launch. Ensure low vibration during launch.
Tumbling | ADNC | Passive control on only one axis | communication problems, unexpected forces, insuficient power | C | 6 | unacceptable | Active control, Hysteresis Rods.
Lost position information | ADNC | could not get 4 GPS sattelite lock | cannot record position: science mission critical | A | 5 | high | Moved antenna to point away from earth
Cannot get magnetic match | ADNC | magnetometer faulty read, damage | rely on gyro for attitude fix | B | 1 | low | Attitude determination no longer needed for mission. No action.
Solar panels do not deploy | POWER | thermal knife | not enough power, no mission | B | 6 | unacceptable | None.
Battery underload | POWER | battery failure/dead | no battery power,system only on when solar is powered | C | 3 | moderate | software will not allow GRID to begin until battery loaded correctly
Battery overload | POWER | EPS fails and overloades battery | explosion | B | 6 | unacceptable | Test componet before launch.
