HASP-UMN/CubeSat/(commit log)

2015-09-14 Initialization of GitHub for AEM4331 CubeSat team
    original files.
    [CubeSatTeam.xlsx]
2015-09-14 Updated Team Roster
    [CubeSatTeam.xlsx]
2015-09-25 added subgroup column
    [CubeSatTeamRoster.xlsx]
2015-09-30 Added my subgroup
    [CubeSatTeamRoster.xlsx]
2015-10-02 Added my Sub Group
    [CubeSatTeamRoster.xlsx]
2015-10-02 Added gantt chart and streamlined file layout
    [CubeSat Power Data.xlsx, CubeSatTeamRoster.xlsx, gantt-chart_CubeSat_SeniorDesign.xlsx]
2015-10-02 Changed subgroup
    [CubeSatTeamRoster.xlsx]
2015-10-02 Added myself to roster
    [CubeSatTeamRoster.xlsx]
2015-10-02 Added myself to subgroup
    [CubeSatTeamRoster.xlsx]
2015-10-04 Added GPS costs
    Added GPS options as a spreadsheet to the Attitude Sub folder
    [GPS costs.xlsx]
2015-10-04 Added prices for communications hardware
    [Hardware Prices.xlsx]
2015-10-05 Chart of potential sun sensors
    Still waiting to hear back from everyone I called/emailed this weekend
    [Sun Sensor research.xlsx]
2015-10-05 Added power requirement
    5W to Payload
2015-10-06 Added Subgroup
    [CubeSatTeamRoster.xlsx]
2015-10-06 Placing Roster in Documents folder
    [CubeSatTeamRoster.xlsx]
2015-10-06 Added cost for a sun sensor
    [Sun Sensor research.xlsx]
2015-10-06 Slides for the Power sub team
    Please edit in the power consumption of your sub team.
2015-10-06 Added Comm power req.
    Don't know exactly how much the antenna will draw yet.
2015-10-07 Made slides for sun sensors and Attitude Determination requirements, Added another possible sun sensor candidate
    [Sun Sensor research.xlsx]
2015-10-07 Changed filenames and paths for clarity
    [CubeSatTeamRoster.xlsx]
2015-10-07 Heard back from some suppliers, added info
    [Sun Sensor research.xlsx]
2015-10-07 added contact info
    [Sun Sensor research.xlsx]
2015-10-07 Added Total Cost xlsx
    [Cost.xlsx]
2015-10-07 added computer to cost
    [Cost.xlsx]
2015-10-07 Updated Cost.xls
    [Cost.xlsx]
2015-10-07 Edited Cost for GPS
    [Cost.xlsx]
2015-10-07 Updated Power consumption estimate
    [CubeSat Power Data.xlsx]
2015-10-07 MOST CURRENT PDR
    Still needs communication update and power revision
2015-10-07 Added power data sheets and filled in excel sheet info
    [Cost.xlsx]
2015-10-08 Updated Cost sheet, please review before I send it in.
    [Cost.xlsx]
2015-10-08 Added The power draw for the OBC, Sun Sensors, and Solar Cells
    Battery remains variable, as it depends upon the voltage .
2015-10-09 Updated PDR Sun Sensors
2015-10-09 changed degrees to mRad on sun sensors sheet
2015-10-10 Updated PDR first few slides
    [CubeSatTeamRoster.xlsx]
2015-10-12 Updated costs for GPS
    We already own NovaTel and and antenna
2015-10-14 Added cost to PDR Sun Sensors
2015-10-14 Added gannt
    [GANTT.xls]
2015-10-14 Updated Gantt
    [GANTT.xls]
2015-10-16 PDR update
    Included diagram, changed some slides, new calculations included.
    Deliverables on my part:
    > Full link budget
    > Communications protocols
    > Transmission power requirements
    > (Assistance with proposing up) Orbital parameters
2015-10-16 Added Hardware and cost to Power Management Slides
2015-10-16 updated Gantt chart slide
    [GANTT.xls]
2015-10-17 Added The Millenium Falcon
2015-10-21 Updated Scheduling Information
    [CubeSat_OneYear_Gantt.xls, GANTT.xls, Gantt.xlsx]
2015-10-30 updated cost xls
    [Cost.xlsx]
2015-11-06 Added back of the envelope calculations
    Rough estimate of the force of the solar wind on the CUBESAT in worst
    case scenario
2015-11-13 Added step files for power
2015-11-15 Added step files in the right spot for what I could find.
    [3U 7xUTJ Cell Side Solar Panel - Pumpkin Compatible.STEP, 3U 7xUTJ Cell Side Solar Panel.SLDPRT, 3U_STS_FRAME_ASEMBLED_02_ASM.sldasm, Assem2.SLDASM, BRACKET_KS_007A.sldprt, BRACKET_KS_007B.sldprt, BUSJE_001.sldprt, CubesatAssembly.SLDASM]
2015-11-15 Moved CubeSat Assembly one directory up for clarity
    [CubesatAssembly.SLDASM]
2015-11-17 Updated draft for cubesat proposal
    [3U 7xUTJ Cell Side Solar Panel - Pumpkin Compatible.SLDPRT, GPS antenna.SLDPRT, GRID.SLDASM, PC104 GPS board.SLDPRT, PC104 connector.SLDPRT, leftside.SLDASM]
2015-11-17 Added overview of specifics of power system components
    I started a document that covers the important specifics of the
    components uses by the power management system
2015-11-18 Added Program Skeletons
    Cubist Communication algorithm mostly done, need info from other
    sub-teams
    Descriptions for data reduction and and ground operation algorithms
    started. Still need to sketch out the skeleton code.
2015-11-18 Begun sketch of a file partitioner.
    I had a chat with one of my Comp. Sci. friends and he gave me some tips
    on how I might implement a file partitioner in c. He also gave me some
    sample code he wrote for a previous class that preforms a similar
    function, so I will be studying that to complete this program.
    What I uploaded here is just so I don’t forget what we talked about.
2015-11-18 Found checksum
    I found this c program online that computes checksums. Not sure if it
    will work exactly to our needs, but I’m posting it here so I don’t lose
    it as a reference. Initial pdf (see page 5) describing the checksum
    method employed: http://m.eet.com/media/1146180/22112-21501di.pdf and
    the actual copy/pasted text came from here:
    http://m.eet.com/media/1148045/63742l1.txt
2015-11-23 Added base needs for CDR
    [FMEA.xlsx]
2015-11-28 SEE SLIDE 6
    Suggestion for figure (compare to slide 5) Don’t know what y’all like
    better.
2015-12-04 Magnetorquer Info
    [Magnetorquers.xlsx]
2015-12-04 updated power management doc
2015-12-04 Added clyde space power systems and tech memo.
    [Calibration Curve1.xlsx]
2015-12-11 structure changes
    [3U_STS_FRAME_ASEMBLED_02_ASM.sldasm, Assem1.SLDASM, Bottom_Frame.sldasm, Bracing.SLDASM, DETECTOR_SIDE_FRAME_007MIDDLE.sldprt, Detector_Frame.SLDASM, GPS antenna.SLDPRT, GPS_GPS antenna.SLDPRT]
2015-12-11 FMEA - URGENT! SEE YOUR EMAILS
    Please refer to your emails
    [FMEA.xlsx]
2015-12-12 updated FMEA
    [FMEA.xlsx]
2015-12-12 Minor consistency edits
    [FMEA.xlsx]
2015-12-13 Gyro Spec Sheet
    Here you go Jake
2015-12-15 Added Images of Power Components
2015-12-16 more ch ch ch changes.
    [3D-15-00255-REVB.sldprt, 3D-15-00255-REVB_2.sldprt, 3D-27-00323-REV03.sldprt, 3D-27-00323-REV03_2.sldprt, 3U 7xUTJ Cell Side Solar Panel - Pumpkin Compatible.SLDASM, 3U pcb.sldprt, 3U_STS_FRAME_ASEMBLED_02_ASM_1.sldasm, 7 cell string end tabs - trimmed tabs.sldasm]
2015-12-17 Relevant PMAC sim papers and scripts
    Note: Scripts currently do not replicate Gerhardt/Palo 2010 results
